apollo-lhc/Cornell_CM_Rev3_HW/MCU/CMv3_TM4C_controller_pin_specs.xlsx

 | GPIO pin that needs to be configured
 | Alternate function pin that needs to be configured
 | Analog input, connected through a low pass filter
 | Pin with a pre-defined function
 | Undefine function, direction, and buffer type
Pin Number | Pin Name | Pin Type | Buffer Type | Description | Signal Name | Usage | Schematics
1 | AIN15 | I | Analog | Analog-to-digital converter input 15 | CUR_V_4V0 | The current from the 4.0 volt regulator that supplies power to the 25Gx12 FireFly transmitters. Scale = 2 amps per volt. | 3.07, 3.08
2 | AIN14 | I | Analog | Analog-to-digital converter input 14 | CUR_V_M3V3 | The current from the 3.3 volt regulator that supplies power to the MCU and peripherals. Scale = 2 amps per volt. | 3.01, 3.08
3 | AIN13 | I | Analog | Analog-to-digital converter input 13 | CUR_V_12V | The current on the 12.0 volt line entering the board. Scale = 12.5 amps per volt (was 10 amps per volt). | 2.01, 3.08
4 | AIN12 | I | Analog | Analog-to-digital converter input 12 | V_F2_VCCAUX | The actual value of the VCCAUX voltage for FPGA#2. Nominally 1.8 volts. | 3.06, 3.08
5 | PQ0 | O | OD | GPIO port Q bit 0 | /I2C_RESET_PWR | Active-low open-drain signal to reset the TCA9548A I2C switch related to accessing the LGA80D regulators, plus the 24LCS52 serial "ID" EEPROM. | 4.01, 4.02
6 | PQ1 | O | OD | GPIO port Q bit 1 | /I2C_RESET_CLOCKS | Active-low open-drain signal to reset the TCA9548A I2C switch related to accessing the clock synthesizers and multiplexers. | 4.01, 4.03
7 | VDD | Power |  | Positive supply for I/O and some logic | V_M3V3 | 3.3 volts from the management regulator. It is present whenever the board has 12v supplied. | 2.04
8 | VDDA | Power |  | The positive supply for the analog circuits (ADC, Analog Comparators, etc.). | V_M3V3 | 3.3 volts from the management regulator. It is present whenever the board has 12v supplied. | 3.08
9 | VREFA+ | Power |  | A reference voltage used to specify the voltage at which the ADC converts to a maximum value. | MCU_VREFA | This 2.5 volt level sets the value that will correspond to the ADC full scale valu of 4095 (0xfff) | 3.08
10 | GNDA | Power |  | The ground reference for the analog circuits (ADC, Analog Comparators, etc.). | GND | Ground plane. | 3.08
11 | PQ2 | O | OD | GPIO port Q bit 2 | /I2C_RESET_F2_OPTICS | Active-low open-drain signal to reset the TCA9548A I2C switch related to accessing FireFly devices connected to FPGA#2. | 4.01, 4.06
12 | AIN0 | I | Analog | Analog-to-digital converter input 0 | V_12V | The scaled value of the +12 volt supply entering the board. Scale factor = 1/6 (12 V in reads as 2 V) Nominally 12.0 volts. | 2.01, 3.08
13 | AIN1 | I | Analog | Analog-to-digital converter input 1 | V_M3V3 | The scaled value of the always-on 3.3 volt maintenance supply. Scale factor = 1/2 (3.3 V reads as 1.65V). Nominally 3.3 volts. | 3.01, 3.08
14 | AIN2 | I | Analog | Analog-to-digital converter input 2 | V_3V3 | The scaled value of the global 3.3 volt switched supply. Scale factor = 1/2 (3.3 V reads as 1.65V). Nominally 3.3 volts. | 3.02, 3.08
15 | AIN3 | I | Analog | Analog-to-digital converter input 3 | V_4V0 | The scaled value of the global 4.0 volt switched supply that supplies power to the 25Gx12 FireFly transmitters. Scale factor = 1/2 (4.0 V reads as 2.0V). Nominally 4.0 volts. | 3.07, 3.08
16 | VDD | Power |  | Positive supply for I/O and some logic | V_M3V3 | 3.3 volts from the management regulator. It is present whenever the board has 12v supplied. | 2.04
17 | GND | Power |  | Ground reference for logic and I/O pins | GND | Ground plane. | 2.04
18 | AIN16 | I | Analog | Analog-to-digital converter input 16 | CUR_F1_VCCAUX | The current from the 1.8 volt regulator that supplies power to FPGA#1 GTY transceivers . Scale = 1 amp per volt. | 3.04, 3.08
19 | AIN17 | I | Analog | Analog-to-digital converter input 17 | CUR_F2_VCCAUX | The current from the 1.8 volt regulator that supplies power to FPGA#2 GTY transceivers . Scale = 1 amp per volt. | 3.06, 3.08
20 | AIN18 | I | Analog | Analog-to-digital converter input 18 | F1_TEMP_DIODE | The voltage from the LTC2997H signal conditioner connected to the temperature-sensing diode in FPGA#1. Scale = 4 * (1.004/1.026) millivolts per degree K. | 3.08, 5.05
21 | AIN19 | I | Analog | Analog-to-digital converter input 19 | F2_TEMP_DIODE | The voltage from the LTC2997H signal conditioner connected to the temperature-sensing diode in FPGA#2. Scale = 4 * (1.004/1.026) millivolts per degree K. | 3.08, 6.05
22 | PC7 | I | TTL | GPIO port C bit 7 | PG_4V0 | This PG (power good) input will be HIGH when the LDO06c power supply for the board-wide 4.0 volt supply has been enabled and is supplying a good voltage. | 3.07, 3.09
23 | PC6 | O | TTL | GPIO port C bit 6 | F2_CFG_START | Pulse this output HIGH to drive the "PROGRAM_B" input on FPGA#2 LOW. The leading edge of the pulse will reset the configuration logic on FPGA#1. The trailing edge will start the configuration process. This signal has a 4.7k pull-down resistor. | 2.12, 6.04
24 | PC5 | undef | undef | UART module 7 transmit, GPIO port C bit 5 | SM_ZYNQ_GPIO2 | Connection to a GPIO pin on the ZYNQ on the SM. The use is currently undefined, but it can be used for UART #7 Tx or GPIO PC5. This signal is tied to GND on the original SMv1. It initially has a 270 ohm resistor in series for current limiting. | 2.01
25 | PC4 | undef | undef | UART module 7 receive, GPIO port C bit 4 | SM_ZYNQ_GPIO1 | Connection to a GPIO pin on the ZYNQ on the SM. The use is currently undefined, but it can be used for UART #7 Rx or GPIO PC4. This signal is tied to GND on the original SMv1. It initially has a 270 ohm resistor in series for current limiting. | 2.01
26 | VDD | Power |  | Positive supply for I/O and some logic | V_M3V3 | 3.3 volts from the management regulator. It is present whenever the board has 12v supplied. | 2.04
27 | PQ3 | O | OD | GPIO port Q bit 3 | /I2C_RESET_F1_OPTICS | Active-low open-drain signal to reset the TCA9548A I2C switch related to accessing FireFly devices connected to FPGA#1. | 4.01, 4.05
28 | VDD | Power |  | Positive supply for I/O and some logic | V_M3V3 | 3.3 volts from the management regulator. It is present whenever the board has 12v supplied. | 2.04
29 | PH0 | O | OD | GPIO port H bit 0 | /I2C_RESET_FPGAS | Active-low open-drain signal to reset the TCA9548A I2C switch related to accessing the FPGAs. | 4.01, 4.04
30 | PH1 | I | TTL | GPIO port H bit 1 | SM_SOFT_PWR_EN | This signal is used by the ZYNQ to tell the MCU to enable or disable power supplies on the CM. The ZYNQ will set it LOW to make the MCU disable all controllable power supplies. The ZYNQ will transition it to HIGH to start the MCU's power control state machine. There is not any pull-up on the CM, so configure it as an input with 2 mA internal pull-up to allow operation when not connected to the SM. | 2.01
31 | PH2 | I | TTL | GPIO port H bit 2 | PG_3V3 | This PG (power good) input will be HIGH when the LGA80D power supply for the board-wide 3.3 volt supply has been enabled and is supplying a good voltage. | 3.02, 3.09
32 | PH3 | I | TTL | GPIO port H bit 3 | PG_1V8 | This PG (power good) input will be HIGH when the LGA80D power supply for the board-wide 1.8 volt supply has been enabled and is supplying a good voltage. | 3.02, 3.09
33 | U0Rx | I | TTL | I2C module 9 clock, UART Module 0 receive, GPIO port A bit 0 | SM_ZYNQ_TX | UART for serial data transmitted from the ZYNQ module on the SM and received by the MCU. Has pads for optional I2C pullup. | 2.01
34 | U0Tx | O | TTL | I2C module 9 data, UART Module 0 transmit, GPIO port A bit 1 | SM_ZYNQ_RX | UART for serial data transmitted from the MCU and received by the ZYNQ module on the SM. Has pads for optional I2C pullup. | 2.01
35 | PA2 | I/O | I2C | I2C module 8 clock, UART Module 4 receive, GPIO port A bit 2 | SM_ZYNQ_I2C_SCL | Connection to a GPIO pin on the ZYNQ on the SM. The use is currently undefined, but it can be used for I2C #8 SCL, UART #4 Rx, GPIO PA2, or Timer T1. | 2.01
36 | PA3 | I/O | I2C | I2C module 8 data, UART Module 4 transmit, GPIO port A bit 3 | SM_ZYNQ_I2C_SDA | Connection to a GPIO pin on the ZYNQ on the SM. The use is currently undefined, but it can be used for I2C #8 SDA, UART #4 Tx, GPIO PA3, or Timer T1. It is used as UART #4 Tx on CMv1 for moving monitoring data to the SM. | 2.01
37 | U3Rx | I | TTL | I2C module 7 clock, UART Module 3 receive, GPIO port A bit 4 | SM_IPMC_TX | UART for serial data transmitted from the IPMC module on the SM and received by the MCU. Has pads for optional I2C pullup. | 2.01
38 | U3Tx | O | TTL | I2C module 7 data, UART Module 3 transmit, GPIO port A bit 5 | SM_IPMC_RX | UART for serial data transmitted from the MCU and received by the IPMC module on the SM. Has pads for optional I2C pullup. | 2.01
39 | VDD | Power |  | Positive supply for I/O and some logic | V_M3V3 | 3.3 volts from the management regulator. It is present whenever the board has 12v supplied. | 2.04
40 | PA6 | undef | undef | I2C module 6 clock, UART Module 2 receive, GPIO port A bit 6, Timer T3 | SM_CPLD_GPIO0 | Connection to a GPIO pin on the CPLD on the SM (SMv2 or later). The use is currently undefined, but it can be used for I2C #6 SCL, UART #2 Rx, GPIO PA6, or Timer T3. This signal is tied to GND on the original SMv1. It initially has a 270 ohm resistor in series for current limiting. | 2.01
41 | PA7 | undef | undef | I2C module 6 data, UART Module 2 transmit, GPIO port A bit 7, Timer T3 | SM_CPLD_GPIO1 | Connection to a GPIO pin on the CPLD on the SM (SMv2 or later). The use is currently undefined, but it can be used for I2C #6 SDA, UART #2 Tx, GPIO PA7, or timer T3. This signal is tied to GND on the original SMv1. It initially has a 270 ohm resistor in series for current limiting. | 2.01
42 | PF0 | I | TTL | GPIO port F bit 0 | PG_F1_INT_A | This PG (power good) input will be HIGH when both phases of the "A" LGA80D power supply for FPGA#1's 0.85 volt V_F1_INT internal voltage have been enabled and are supplying a good voltage. The PG signals from each phase are combined in an AND gate ahead of this input. | 3.03, 3.09
43 | PF1 | I | TTL | GPIO port F bit 1 | PG_F1_INT_B | This PG (power good) input will be HIGH when both phases of the "B" LGA80D power supply for FPGA#1's 0.85 volt V_F1_INT internal voltage have been enabled and are supplying a good voltage. The PG signals from each phase are combined in an AND gate ahead of this input. | 3.03, 3.09
44 | PF2 | I | TTL | GPIO port F bit 2 | PG_F1_AVCC | This PG (power good) input will be HIGH when the LGA80D power supply for FPGA#1's 0.9 volt V_F1_AVCC supply has been enabled and is supplying a good voltage. | 3.04, 3.09
45 | PF3 | I | TTL | GPIO port F bit 3 | PG_F1_AVTT | This PG (power good) input will be HIGH when the LGA80D power supply for FPGA#1's 1.2 volt V_F1_AVTT supply has been enabled and is supplying a good voltage. | 3.04, 3.09
46 | PF4 | I | TTL | GPIO port F bit 4 | PG_F1_VCCAUX | This PG (power good) input will be HIGH when the LT1764 power supply for FPGA#1's 1.8 volt V_F1_VCCAUX supply has been enabled and is supplying a good voltage. | 3.04, 3.09
47 | VDD | Power |  | Positive supply for I/O and some logic | V_M3V3 | 3.3 volts from the management regulator. It is present whenever the board has 12v supplied. | 2.04
48 | GND | Power |  | Ground reference for logic and I/O pins | GND | Ground plane. | 2.04
49 | I2C1SCL | I/O | I2C | I2C module 1 clock. | I2C_SCL_POWER | Open-drain signal connected to the I2C clock related to accessing the LGA80D regulators, plus the 24LCS52 serial "ID" EEPROM. | 4.01, 4.02
50 | I2C1SDA | I/O | I2C | I2C module 1 data | I2C_SDA_POWER | Open-drain signal connected to the I2C data line related to accessing the LGA80D regulators, plus the 24LCS52 serial "ID" EEPROM. | 4.01, 4.02
51 | I2C2SCL | I/O | I2C | I2C module 2 clock. | I2C_SCL_CLOCKS | Open-drain signal connected to the I2C clock related to accessing the clock synthesizers and multiplexers. | 4.01, 4.03
52 | I2C2SDA | I/O | I2C | I2C module 2 data | I2C_SDA_CLOCKS | Open-drain signal connected to the I2C data line related to accessing the clock synthesizers and multiplexers. | 4.01, 4.03
53 | I2C3SCL | I/O | I2C | I2C module 3 clock. | I2C_SCL_F2_OPTICS | Open-drain signal connected to the I2C clock related to accessing FireFly devices connected to FPGA#2. | 4.01, 4.06
54 | I2C3SDA | I/O | I2C | I2C module 3 data | I2C_SDA_F2_OPTICS | Open-drain signal connected to the I2C data line related to accessing FireFly devices connected to FPGA#2. | 4.01, 4.06
55 | I2C4SCL | I/O | I2C | I2C module 4 clock. | I2C_SCL_F1_OPTICS | Open-drain signal connected to the I2C clock related to accessing FireFly devices connected to FPGA#1. | 4.01, 4.05
56 | I2C4SDA | I/O | I2C | I2C module 4 data | I2C_SDA_F1_OPTICS | Open-drain signal connected to the I2C data line related to accessing FireFly devices connected to FPGA#1. | 4.01, 4.05
57 | PQ5 | I | TTL | GPIO port Q bit 5 | PG_F2_INT_A | This PG (power good) input will be HIGH when both phases of the "A" LGA80D power supply for FPGA#2's 0.85 volt V_F2_INT internal voltage have been enabled and are supplying a good voltage. The PG signals from each phase are combined in an AND gate ahead of this input. | 3.05, 3.09
58 | PQ6 | I | TTL | GPIO port Q bit 6 | PG_F2_INT_B | This PG (power good) input will be HIGH when both phases of the "B" LGA80D power supply for FPGA#2's 0.85 volt V_F2_INT internal voltage have been enabled and are supplying a good voltage. The PG signals from each phase are combined in an AND gate ahead of this input. | 3.05, 3.09
59 | PK7 | I | TTL | GPIO port K bit 7 | PG_F2_AVCC | This PG (power good) input will be HIGH when the LGA80D power supply for FPGA#2's 0.9 volt V_F2_AVCC supply has been enabled and is supplying a good voltage. | 3.06, 3.09
60 | PK6 | I | TTL | GPIO port K bit 6 | PG_F2_AVTT | This PG (power good) input will be HIGH when the LGA80D power supply for FPGA#2's 1.2 volt V_F2_AVTT supply has been enabled and is supplying a good voltage. | 3.06, 3.09
61 | PK5 | I | TTL | GPIO port K bit 5 | PG_F2_VCCAUX | This PG (power good) input will be HIGH when the LT1764 power supply for FPGA#2's 1.8 volt V_F2_VCCAUX supply has been enabled and is supplying a good voltage. | 3.06, 3.09
62 | PK4 | I | TTL | GPIO port K bit 4 | /F1_CFG_DONE | Active-lo digital input from FPGA#1. If the FPGA is installed, this signal will be LOW when the FPGA configuration is complete. Unfortunately, if the FPGA is not installed, it will also be LOW all the time. Therefore, it must be qualified with /F1_INSTALLED. | 2.12, 5.04
63 | VDD | Power |  | Positive supply for I/O and some logic | V_M3V3 | 3.3 volts from the management regulator. It is present whenever the board has 12v supplied. | 2.04
64 | /WAKE | I | TTL | An external input that brings the processor out of Hibernate mode when asserted. | GND | Tied to GND. This function is not used. | 2.04
65 | /HIB | O | TTL | An output that indicates the processor is in Hibernate mode | No connect | No connection since this function is not used. | 2.04
66 | XOSC0 | I | Analog | External RTC clock reference input. | XOSC0 | Connected to a 32.768 kHz crystal that can drive the internal RTC. | 2.04
67 | XOSC1 | O | Analog | External RTC clock reference output. | XOSC1 | Connected to a 32.768 kHz crystal that can drive the internal RTC. | 2.04
68 | VBAT | Power |  | Power source for the Hibernation module. | V_M3V3 | 3.3 volts from the management regulator. It is present whenever the board has 12v supplied. SInce a battery is not used, this pin connects directly to the VDD source. | 2.04
69 | VDD | Power |  | Positive supply for I/O and some logic | V_M3V3 | 3.3 volts from the management regulator. It is present whenever the board has 12v supplied. | 2.04
70 | /RESET | I | TTL | System reset input | MCU_ENABLED | MCU_ENABLED will be HIGH when: a) SM_TO_CM_PWR_EN is HIGH (either from the board being operated "stand alone" or the signal driven HIGH by the service module) b) AND the management supply is good (V_M3V3). | 2.04
71 | PM7 | I | TTL | GPIO port M bit 7 | /F2_CFG_DONE | Active-low digital input from FPGA#2. If the FPGA is installed, this signal will be LOW when the FPGA configuration is complete. Unfortunately, if the FPGA is not installed, it will also be LOW. Therefore, it must be qualified with /F1_INSTALLED. | 2.12, 6.04
72 | PM6 | I | TTL | GPIO port M bit 6 | hivF1_TO_MCU lovF1_TO_MCU | Unassigned digital input from FPGA#1. This passes through a level converter. The signal name prefaced with "lov" is on the low voltage 1.8 volt FPGA side of the converter. The signal name prefaced with "hiv" is on the high-voltage 3.3v side of the converter. | 2.12, 5.08
73 | PM5 | I | TTL | GPIO port M bit 5 | hivF2_TO_MCU lovF2_TO_MCU | Unassigned digital input from FPGA#2. This passes through a level converter. The signal name prefaced with "lov" is on the low voltage 1.8 volt FPGA side of the converter. The signal name prefaced with "hiv" is on the high-voltage 3.3v side of the converter. | 2.12, 6.08
74 | PM4 | O | TTL | GPIO port M bit 4 | hivMCU_TO_F1 lovMCU_TO_F1 | Unassigned digital ouput to FPGA#1. This passes through a level converter. The signal name prefaced with "lov" is on the low voltage 1.8 volt FPGA side of the converter. The signal name prefaced with "hiv" is on the high-voltage 3.3v side of the converter. | 2.12, 5.08
75 | PM3 | O | TTL | GPIO port M bit 3 | hivMCU_TO_F2 lovMCU_TO_F2 | Unassigned digital ouput to FPGA#2. This passes through a level converter. The signal name prefaced with "lov" is on the low voltage 1.8 volt FPGA side of the converter. The signal name prefaced with "hiv" is on the high-voltage 3.3v side of the converter. | 2.12, 6.08
76 | PM2 | O | TTL | GPIO port M bit 2 | CM_TO_SM_PWR_OK | This output is set HIGH when the MCU's power control state machine has successfully completed enabling the configured set of controllable power supplies on the CM. It will be set LOW when the desired power supplies are not all operational. | 2.01
77 | PM1 | O | TTL | GPIO port M bit 1 | EN_3V3 | Set this output HIGH to turn on the LGA80D power supply for the board-wide V_3V3 3.3 volt rail. This also enables the V_4V0 4.0 volt rail used by the FireFLy 12-lane transmitters that run at 25G. | 3.02, 3.07, 3.09
78 | PM0 | O | TTL | GPIO port M bit 0 | EN_1V8 | Set this output HIGH to turn on the LGA80D power supply for the board-wide 1.8 volts V_1V8 | 3.02, 3.09
79 | VDD | Power |  | Positive supply for I/O and some logic | V_M3V3 | 3.3 volts from the management regulator. It is present whenever the board has 12v supplied. | 2.04
80 | GND | Power |  | Ground reference for logic and I/O pins | GND | Ground plane. | 2.04
81 | PL0 | O | TTL | GPIO port L bit 0 | EN_F1_INT | Set this output HIGH to turn on both phases of both "A" and "B" LGA80D power supplies for FPGA#1's 0.9 volt V_F1_INT internal voltage. | 3.03, 3.09
82 | PL1 | O | TTL | GPIO port L bit 1 | EN_F1_AVCC | Set this output HIGH to turn on the LGA80D power supply for FPGA#1's 0.9 volt V_F1_AVCC voltage. | 3.04, 3.09
83 | PL2 | O | TTL | GPIO port L bit 2 | EN_F1_AVTT | Set this output HIGH to turn on the LGA80D power supply for FPGA#1's 1.2 volt V_F1_AVTT voltage. | 3.04, 3.09
84 | PL3 | O | TTL | GPIO port L bit 3 | EN_F1_VCCAUX | Set this output HIGH to turn on the LT1764 power supply for FPGA#1's 1.8 volt V_F1_VCCAUX voltage. | 3.04, 3.09
85 | PL4 | O | TTL | GPIO port L bit 4 | EN_F2_INT | Set this output HIGH to turn on both phases of both "A" and "B" LGA80D power supplies for FPGA#2's 0.9 volt V_F2_INT internal voltage. | 3.05, 3.09
86 | PL5 | O | TTL | GPIO port L bit 5 | EN_F2_AVCC | Set this output HIGH to turn on the LGA80D power supply for FPGA#2's 0.9 volt V_F2_AVCC voltage. | 3.06, 3.09
87 | VDDC | Power |  | Positive supply for most of the logic function, including the processor core and most peripherals. The voltage on this pin is 1.2 V and is supplied by the on-chip LDO. | TM4C_VDDC | Tied to TM4C pins 87 and 115 and a 3.3 uF capacitor. The VDDC pins should only be connected to each other and an external capacitor as specified in Table 26-15 on page 1577 . | 2.04
88 | OSC0 | I | Analog | Main oscillator crystal input. | OSC0 | Connected to a 16 MHz crystal that can be used for more accuracy than the internal oscillator. | 2.04
89 | OSC1 | O | Analog | Main oscillator crystal output. | OSC1 | Connected to a 16 MHz crystal that can be used for more accuracy than the internal oscillator. | 2.04
90 | VDD | Power |  | Positive supply for I/O and some logic | V_M3V3 | 3.3 volts from the management regulator. It is present whenever the board has 12v supplied. | 2.04
91 | I2C0SCL | I/O | I2C | I2C module 0 clock. | SM_IPMC_I2C_SCL | Open-drain signal connected to the I2C clock from the SM. This is an I2C slave interface | 2.01
92 | I2C0SDA | I/O | I2C | I2C module 0 data | SM_IPMC_I2C_SDA | Open-drain signal connected to the I2C data line from the SM. This is an I2C slave interface | 2.01
93 | PL7 | O | TTL | GPIO port L bit 7 | EN_F2_AVTT | Set this output HIGH to turn on the LGA80D power supply for FPGA#2's 1.2 volt V_F2_AVTT voltage. | 3.06, 3.09
94 | PL6 | O | TTL | GPIO port L bit 6 | EN_F2_VCCAUX | Set this output HIGH to turn on the LT1764 power supply for FPGA#2's 1.8 volt V_F2_VCCAUX voltage. | 3.06, 3.09
95 | I2C5SCL | I/O | I2C | I2C module 5 clock. | I2C_SCL_FPGAS | Open-drain signal connected to the I2C clock related to accessing the FPGAs. | 4.01, 4.04
96 | I2C5SDA | I/O | I2C | I2C module 5 data | I2C_SDA_FPGAS | Open-drain signal connected to the I2C data line related to accessing the FPGAs. | 4.01, 4.04
97 | TDO | O | TTL | JTAG TDO | FP_MCU_TDO | Front-panel JTAG connector signal. Can be used for JTAG TDO or ARM "SWD" SWO | 2.03
98 | TDI | I | TTL | JTAG TDI | FP_MCU_TDI | Front-panel JTAG connector signal. Used for JTAG TDI | 2.03
99 | TMS | I | TTL | JTAG TMS | FP_MCU_TMS | Front-panel JTAG connector signal. Can be used for JTAG TMS or ARM "SWD" SWDIO | 2.03
100 | TCK | I | TTL | JTAG TCK | FP_MCU_TCK | Front-panel JTAG connector signal. Can be used for JTAG TCK or ARM "SWD" SWCLK | 2.03
101 | VDD | Power |  | Positive supply for I/O and some logic | V_M3V3 | 3.3 volts from the management regulator. It is present whenever the board has 12v supplied. | 2.04
102 | PQ4 | O | TTL | GPIO port Q bit 4 | FPGA_CFG_FROM_FLASH | Set this output HIGH to enable the FPGAs to boot from the on-board FLASH memory (Master SPI mode). Set this output LOW to limit booting to JTAG (JTAG only mode). The FPGA configuration input bit "M2" takes on the inverted value of this signal. This signal has a 4.7k pull-down resistor. | 2.12, 5.04, 6.04
103 | PP2 | O | TTL | GPIO port P bit 2 | F1_CFG_START | Pulse this output HIGH to drive the "PROGRAM_B" input on FPGA#1 LOW. The leading edge of the pulse will reset the configuration logic on FPGA#1. The trailing edge will start the configuration process. This signal has a 4.7k pull-down resistor. | 2.12, 5.04
104 | PP3 | O | TTL | GPIO port P bit 3 | MCU_LED_RED | Set this output HIGH to light the RED element of the MCU RGB LED. | 2.12
105 | PP4 | O | TTL | GPIO port P bit 4 | MCU_LED_GREEN | Set this output HIGH to light the GREEN element of the MCU RGB LED. | 2.12
106 | PP5 | O | TTL | GPIO port P bit 5 | MCU_LED_BLUE | Set this output HIGH to light the BLUE element of the MCU RGB LED. | 2.12
107 | PN0 | O | TTL | GPIO port N bit 0 | ID_EEPROM_WP | This output controls the write-protect pin on the ID EEPROM. Set this output LOW to enable writing to the EEPROM. Set this output HIGH to disable writing. | 4.01
108 | PN1 | O | TTL | GPIO port N bit 1 | JTAG_FROM_SM | Set this output HIGH to enable the FPGA JTAG chain to be controlled by the SM. Set this output LOW to enable the FPGA JTAG chian to be controlled from the front panel connector. | 2.03
109 | PN2 | undef | TTL | GPIO port N bit 2 | SPARE_GPIO3 | Connection to a test point on the CM circuit board. The use is currently undefined. It is recommended to configure it as an output driven LOW until a specific need is determined. | 2.03
110 | PN3 | undef | TTL | GPIO port N bit 3 | SPARE_GPIO2 | Connection to a test point on the CM circuit board. The use is currently undefined. It is recommended to configure it as an output driven LOW until a specific need is determined. | 2.03
111 | PN4 | undef | undef | GPIO port N bit 4 | SPARE_GPIO0 | Connection to a test point on the CM circuit board. The use is currently undefined. It is recommended to configure it as an output driven LOW until a specific need is determined. | 2.12
112 | PN5 | undef | undef | GPIO port N bit 5 | SPARE_GPIO1 | Connection to a test point on the CM circuit board. The use is currently undefined. It is recommended to configure it as an output driven LOW until a specific need is determined. | 2.12
113 | VDD | Power |  | Positive supply for I/O and some logic | V_M3V3 | 3.3 volts from the management regulator. It is present whenever the board has 12v supplied. | 2.04
114 | GND | Power |  | Ground reference for logic and I/O pins | GND | Ground plane. | 2.04
115 | VDDC | Power |  | Positive supply for most of the logic function, including the processor core and most peripherals. The voltage on this pin is 1.2 V and is supplied by the on-chip LDO. | TM4C_VDDC | Tied to TM4C pins 87 and 115 and a 3.3 uF capacitor. The VDDC pins should only be connected to each other and an external capacitor as specified in Table 26-15 on page 1577 . | 2.04
116 | PJ0 | I | TTL | GPIO port J bit 0 | hivF1_C2C_OK lovF1_C2C_OK | Active-hi digital input from FPGA#1. The FPGA should Set this signal when it has a good C2C (AXI chip-to-chip) link with the Zynq on the SM. This passes through a level converter. The signal name prefaced with "lov" is on the low voltage 1.8 volt FPGA side of the converter. The signal name prefaced with "hiv" is on the high-voltage 3.3v side of the converter. | 2.12, 5.08
117 | PJ1 | I | TTL | GPIO port J bit 1 | hivF2_C2C_OK lovF2_C2C_OK | Active-hi digital input from FPGA#2. The FPGA should Set this signal when it has a good C2C (AXI chip-to-chip) link with the Zynq on the SM. This passes through a level converter. The signal name prefaced with "lov" is on the low voltage 1.8 volt FPGA side of the converter. The signal name prefaced with "hiv" is on the high-voltage 3.3v side of the converter. | 2.12, 6.08
118 | PP0 | I | TTL | GPIO port P bit 0 | /F1_INSTALLED | Active-lo digital input that indicates that FPGA#1 is installed on the board. It connects to a pullup resistor and one of the GND balls on the FPGA. If the FPGA is installed, the signal is pulled low through the internal GND of the FPGA. | 2.12, 5.01
119 | PP1 | I | TTL | GPIO port P bit 1 | /F2_INSTALLED | Active-lo digital input that indicates that FPGA#2 is installed on the board. It connects to a pullup resistor and one of the GND balls on the FPGA. If the FPGA is installed, the signal is pulled low through the internal GND of the FPGA. | 2.12, 6.01
120 | AIN11 | I | Analog | Analog-to-digital converter input 11 | V_F2_AVTT | The actual value of the AVTT voltage for FPGA#2. Nominally 1.2 volts. | 3.06, 3.08
121 | AIN10 | I | Analog | Analog-to-digital converter input 10 | V_F2_AVCC | The actual value of the AVCC voltage for FPGA#2. Nominally 0.9 volts. | 3.06, 3.08
122 | VDD | Power |  | Positive supply for I/O and some logic | V_M3V3 | 3.3 volts from the management regulator. It is present whenever the board has 12v supplied. | 2.04
123 | AIN9 | I | Analog | Analog-to-digital converter input 9 | V_F2_INT | The actual value of the internal core voltage for FPGA#2. Nominally 0.85 volts. | 3.05, 3.08
124 | AIN8 | I | Analog | Analog-to-digital converter input 8 | V_F1_VCCAUX | The actual value of the VCCAUX voltage for FPGA#1. Nominally 1.8 volts. | 3.04, 3.08
125 | AIN7 | I | Analog | Analog-to-digital converter input 7 | V_F1_AVTT | The actual value of the AVTT voltage for FPGA#1. Nominally 1.2 volts. | 3.04, 3.08
126 | AIN6 | I | Analog | Analog-to-digital converter input 6 | V_F1_AVCC | The actual value of the AVCC voltage for FPGA#1. Nominally 0.9 volts. | 3.04, 3.08
127 | AIN5 | I | Analog | Analog-to-digital converter input 5 | V_F1_INT | The actual value of the internal core voltage for FPGA#1. Nominally 0.85 volts. | 3.03, 3.08
128 | AIN4 | I | Analog | Analog-to-digital converter input 4 | V_1V8 | The actual value of the global 1.8 volt switched supply. Nominally 1.8 volts. | 3.02, 3.08
