apollo-lhc/Cornell_CM_Rev3_HW/ClockBuilderPRO/test_projects/TestConfigurationIndex.xlsx

Sheet: Configurations
Configuration Name Breakdown (dddbbpvv)
 | ddd = device, one of R0A, R0B, R1A, R1B, or R1C
 | bb = CM board version, one of "v3" (CMv3) or "v0" (CMv1 or CMv2)
 | p = project type, one of "C" (common), "T" (TF), "D" (IT-DTC), "X" (diagnostic special), or "0" (old non-specific CMv1 or CMv2)
 | vv = version, increment for new versions of specific "dddbbp" types
Green cells indicate the input sources
R0Av3X01 | Common | 48 | no connect | unused | no connect | unused | no connect | 320 | 160 | 300 | 150 | 280 | 140 | 260 | 130 | 240 | no connect | unused
R0Av3X02 | Common |  | no connect | 230 | no connect | 230 | no connect | 230 | 230 | 230 | 230 | 230 | 230 | 230 | 230 | 230 | no connect | 230
R0Av3X03 | Common | 48 | no connect | unused | no connect | unused | no connect | 320.63 | 320.63 | 320.63 | 320.63 | 320.63 | 320.63 | 320.63 | 320.63 | 320.63 | no connect | unused
R0Bv3X01 | Common | 48 | unused | unused | unused | unused | no connect | 310 | 155 | 290 | 145 | 270 | 135 | 250 | 125 | 230 | no connect | unused
R0Bv3X02 | Common |  | 240 | unused | unused | 240 | no connect | 240 | 240 | 240 | 240 | 240 | 240 | 240 | 240 | 240 | no connect | 240
R0Bv3X03 | Common |  | unused | 320 | unused | 320 | no connect | 320 | 320 | 320 | 320 | 320 | 320 | 320 | 320 | 320 | no connect | 320
R0Bv3X04 | Common |  | unused | unused | 40 | 40 | no connect | 200 | 200 | 200 | 200 | 200 | 200 | 200 | 200 | 200 | no connect | 40
R0Bv3X05 | Common |  | 240 | 320 | 40 | unused | no connect | 280 | 280 | 280 | 280 | 280 | 280 | 280 | 280 | 280 | no connect | unused
R1Av3X01 | Common | 48 | unused | unused | unused | unused | 60 | 40 | 100 | 120 | 312 | 168 | 336 | 156 | 272 | 136 | no connect | unused
R1Av3X02 | Common |  | 320 | unused | unused | 320 | 320 | 320 | 320 | 320 | 320 | 320 | 320 | 320 | 320 | 320 | no connect | 320
R1Av3X03 | Common |  | unused | 40 | unused | 40 | 160 | 160 | 160 | 160 | 160 | 160 | 160 | 160 | 160 | 160 | no connect | 40
R1Av3X04 | Common |  | unused | unused | 40 | 40 | 120 | 120 | 120 | 120 | 120 | 120 | 120 | 120 | 120 | 120 | no connect | 40
R1Bv3X01 | Common | 48 | unused | unused | unused | unused | 176 | 220 | 110 | 132 | 296 | 163 | 326 | 148 | 268 | 132 | 55 | unused
R1Bv3X02 | Common |  | 100 | unused | unused | 100 | 200 | 200 | 200 | 200 | 200 | 200 | 200 | 200 | 200 | 200 | 200 | 100
R1Bv3X03 | Common |  | unused | 40 | unused | 40 | 280 | 280 | 280 | 280 | 280 | 280 | 280 | 280 | 280 | 280 | 280 | 40
R1Bv3X04 | Common |  | unused | unused | 40 | 40 | 140 | 140 | 140 | 140 | 140 | 140 | 140 | 140 | 140 | 140 | 140 | 40
R1Cv3X01 | Common | 48 | unused | no connect | unused | no connect | 116 | 232 | 174 | 348 | 310 | 170 | 340 | 155 | 286 | 143 | 226 | 113
R1Cv3X02 | Common |  | 120 | unused | unused | no connect | 240 | 240 | 240 | 240 | 240 | 240 | 240 | 240 | 240 | 240 | 240 | 240
R1Cv3X03 | Common |  | unused | unused | 40 | no connect | 180 | 180 | 180 | 180 | 180 | 180 | 180 | 180 | 180 | 180 | 180 | 180

Sheet: ClockDistribution
Files | R0Av3X01 | R0Bv3X01 |  |  | R1Av3X01 | R1Bv3X01 |  | R1Cv3X01
 |  |  |  |  |  |  |  |  |  |  |  |  |  | FPGA #1 |  |  | FPGA #2
Quad # | Quad Letter | Ref # | Vivado Constraints Name | FPGA #1 A/B Switch | FPGA #1 Source | FPGA #1 Freq | FPGA #2 A/B Switch | FPGA #2 Source | FPGA #2 Freq | Logic Clock Name (schematic) | Logic Clock Name (constraint file) | Logic Clock Pins | A/B Switch | Source | Freq | A/B Switch | Source | Freq | A/B Switch | Signal | IC | Bit #
 |  |  |  |  |  |  |  |  |  |  |  |  |  |  |  |  |  |  | 1 | F1L_X12_R0_SEL | U88 | P00
120 | AB | R0 | lf_r0_ab |  | R1A-0A | 60 |  | R1A-0 | 40 | FnL_X12_R0_CLK | lf_x12_r0_clk | P33/P34 | 1 | R0A/B-2 | 300/290 | 5 | R0A/B-6 | 260/250 | 2 | F1L_X4_R0_SEL | U88 | P01
120 | AB | R1 | lf_r1_ab |  | R1B-0 | 220 |  | R1B-1 | 110 | FnL_X4_R0_CLK | lf_x4_r0_clk | N32/M32 | 2 | R0A/B-3 | 150/145 | 6 | R0A/B-7 | 130/125 | 3 | F1R_X12_R0_SEL | U88 | P02
122 | AD | R0 | lf_r0_ad | 1 | R0A/B-2 | 300/290 | 5 | R0A/B-6 | 260/250 | FnR_X12_R0_CLK | rt_x12_r0_clk | R18/R17 | 3 | R0A/B-1 | 160/155 | 7 | R0A/B-0 | 320/310 | 4 | F1R_X4_R0_SEL | U88 | P03
122 | AD | R1 | lf_r1_ad |  | R1B-2 | 132 |  | R1B-6 | 148 | FnR_X4_R0_CLK | rt_x4_r0_clk | N19/N18 | 4 | R0A/B-4 | 280/270 | 8 | R0A/B-5 | 140/135 | 5 | F2L_X12_R0_SEL | U83 | P00
124 | AF | R0 | lf_r0_af | 2 | R0A/B-3 | 150/145 | 6 | R0A/B-7 | 130/125 | Fn_TCDS40_CLK | tcds40_clk | BF27/BF28 |  | R1B-9 | 55 |  | R1B-9 | 55 | 6 | F2L_X4_R0_SEL | U83 | P01
124 | AF | R1 | lf_r1_af |  | R1A-4 | 168 |  | R1A-6 | 156 | LHC_CLK | lhc_clk | BE26/BE27 |  | SM | 40 |  | SM | 40 | 7 | F2R_X12_R0_SEL | U83 | P02
126 | R | R0 | lf_r0_r | 1 | R0A/B-2 | 300/290 | 5 | R0A/B-6 | 260/250 | FnFmSPARE2 | in_spare[2] | C29/C30 |  | FPGA#2 | 200 |  | FPGA#1 | 200 | 8 | F2R_X4_R0_SEL | U83 | P03
126 | R | R1 | lf_r1_r |  | R1B-3 | 296 |  | F1B-7 | 268
129 | U | R0 | lf_r0_u | 1 | R0A/B-2 | 300/290 | 5 | R0A/B-6 | 260/250
129 | U | R1 | lf_r1_u |  | R1B-0A | 176 |  | R1B-5 | 326
131 | W | R0 | lf_r0_w | 2 | R0A/B-3 | 150/145 | 6 | R0A/B-7 | 130/125
131 | W | R1 | lf_r1_w |  | R1A-3 | 312 |  | R1A-5 | 336 |  | out_spare[2] | BG26/BG27
133 | Y | R0 | lf_r0_y | 1 | R0A/B-2 | 300/290 | 5 | R0A/B-6 | 260/250
133 | Y | R1 | lf_r1_y |  | R1B-4 | 163 |  | R1B-8 | 134 | F1_XTAL_200 | clk_200 | AT17/AU16
220 | L | R0 | rt_r0_l |  | OSC | 200 |  | OSC | 200
220 | L | R1 | rt_r1_l |  | R1A-7 | 272 |  | R1A-8 | 136
222 | N | R0 | rt_r0_n | 3 | R0A/B-1 | 160/155 | 7 | R0A/B-0 | 320/310
222 | N | R1 | rt_r1_n |  | R1C-4 | 170 |  | R1C-5 | 340
224 | P | R0 | rt_r0_p | 4 | R0A/B-4 | 280/270 | 8 | R0A/B-5 | 140/135
224 | P | R1 | rt_r1_p |  | R1C-0A | 116 |  | R1C-9 | 226
226 | B | R0 | rt_r0_b | 3 | R0A/B-1 | 160/155 | 7 | R0A/B-0 | 320/310
226 | B | R1 | rt_r1_b |  | R1C-6 | 155 |  | R1C-3 | 310
229 | E | R0 | rt_r0_e | 3 | R0A/B-1 | 160/155 | 7 | R0A/B-0 | 320/310
229 | E | R1 | rt_r1_e |  | R1C-7 | 286 |  | R1C-2 | 348
231 | G | R0 | rt_r0_g | 4 | R0A/B-4 | 280/270 | 8 | R0A/B-5 | 140/135
231 | G | R1 | rt_r1_g |  | R1C-8 | 143 |  | R1C-0 | 232
233 | I | R0 | rt_r0_i | 3 | R0A/B-1 | 160/155 | 7 | R0A/B-0 | 320/310
233 | I | R1 | rt_r1_i |  | R1C-9A | 113 |  | R1C-1 | 174
