apollo-lhc/Cornell_CM_Rev3_HW/BoardTesting/FireFly_installation_for_TF.docx

# FireFly Installation for TF on CMv3 (6089-127 Rev A)

### Summary

1) Set FireFly transmitter voltage slide switches
2) Reinstall standoffs
3) Prepare and attach front panel
4) Install FireFly modules
5) Install FireFly heatsink thermal foam and heatsink
6) Route FireFly cables to front panel coupler block
7) Label front panel coupler block

### Set FireFly transmitter voltage slide switches

1) There are 8 slide switches on the bottom side of the board. Set all of them to the “3.3V” position (NOT the 3.8V position).
2) Set only switch SW7 to the “3.8V” position. This set the transmitter voltage for the FireFly in site “U41”. (FPGA #2 quads 128/129/130)

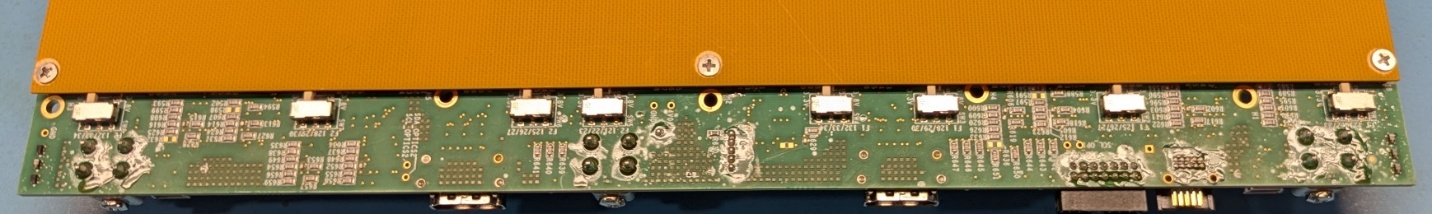
[picture p1: figure]

Selector switches in the “3.3V” (OFF) position.

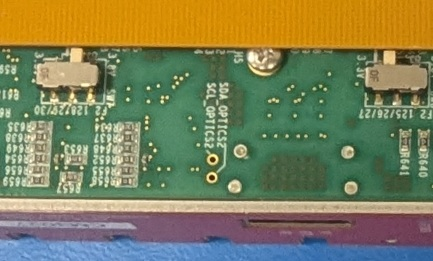
[picture p2: figure]

Selector switch SW7 in the “3.8V” (ON) position.

Selector switch SW7 location.

### Reinstall standoffs

Several standoffs may have been removed to facilitate testing the board with copper FireFly cables. If so, they need to be replaced.

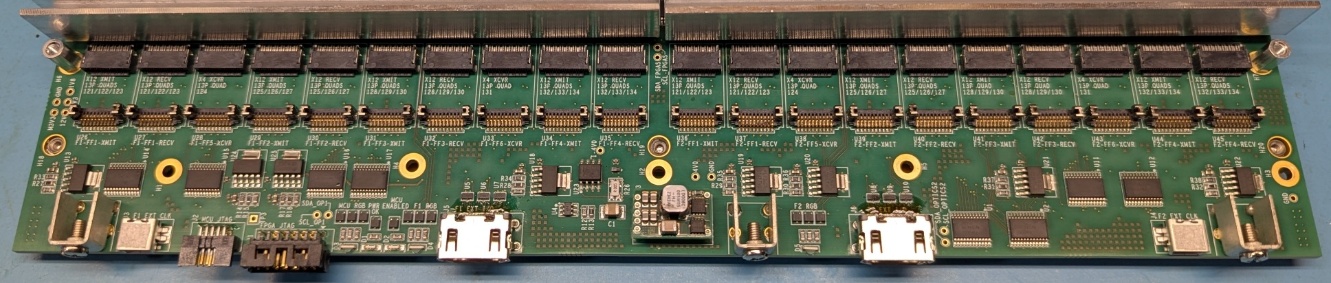
[picture p3: figure]

Missing FireFly heatsink standoffs

(2 places)

Missing top cover standoffs

(3 places)

1) Remove the bottom cover.
2) Install 3 21-mm long top cover standoffs
  a. From the bottom side of the board, insert a Phillips-head M2.5 x 8 screw and an M2.5 lock-washer through one of the mounting holes H1, H2, or H3.
  b. From the top side of the board add an M2.5 x 21 mm standoff.
  c. Tighten the screw and standoff.
3) Install 2 8-mm long FireFly heatsink standoffs
  a. From the bottom side of the board, insert a Phillips-head M2.5 x 6 screw and an M2.5 lock-washer through one of the mounting holes H4 or H5. (NOTE: The M2.5 x 8 screws are too long for these standoffs)
  b. From the top side of the board add an M2.5 x 8 mm standoff.
  c. Tighten the screw and standoff.
4) Reinstall the bottom cover.

### Prepare and attach front panel

1) Remove and discard the factory screws, if any, from the front panel mounting blocks.

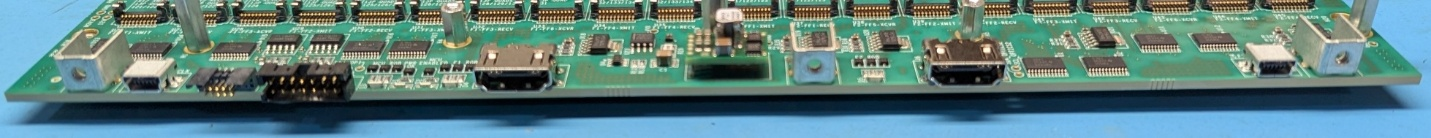
[picture p4: figure]

Remove screws

2) On a front panel that has already had the overlay applied, attach two 30-mm standoffs for the fiber optic connectors on the upper half. Insert Phillips-head M2.5x6 screws plus M2.5 lockwashers from the back side, and thread on the spacers from the front side and tighten.
3) Attach a fiber optic coupler block to the standoffs using Phillips-head M2.5 x 12-mm screws. Be sure the “key” faces in the direction shown in the photo.
4) Print and attach a label that shows the CM serial number. The format is “CMxxxx” where “xxxx” is the 4-digit serial number that matched the one on the board.
5) Attach the front panel to the board with three Phillips-head M3x6 screws.

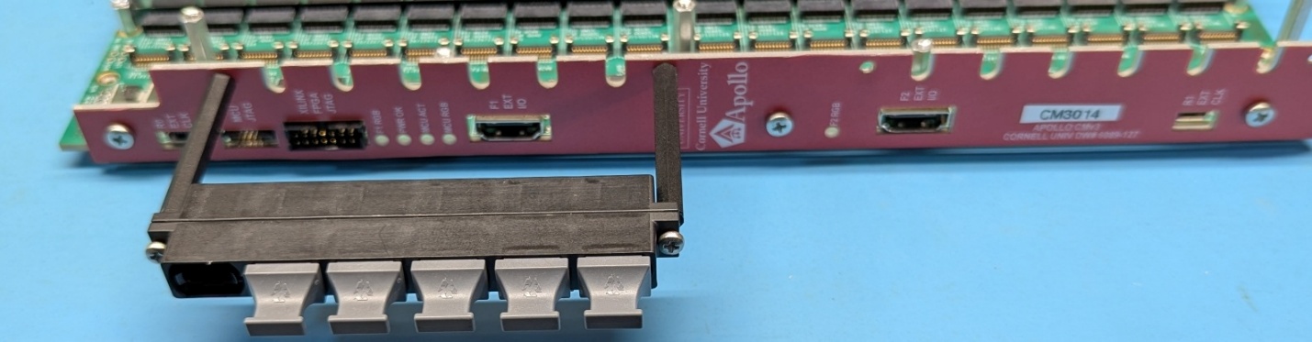
[picture p5: figure]

Coupler block

30-mm standoffs

Serial number label

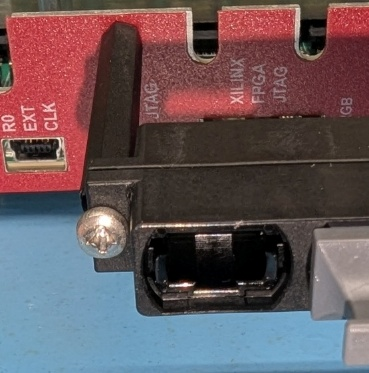
[picture p6: figure]

“Key” direction

### Install FireFly modules

1) Plug in all the required FireFly modules. For a TF board, the FireFly types and sites are:
  a. F1-FF1-RECV (U27) Quads 121/122/123: 25Gx12 Receiver
  b. F1-FF2-RECV (U30) Quads 125/126/127: 25Gx12 Receiver
  c. F1-FF3-RECV (U32) Quads 128/129/130: 25Gx12 Receiver
  d. F1-FF4-RECV (U35) Quads 132/133/134: 25Gx12 Receiver
  e. F2-FF3-XMIT (U41) Quads 128/129/130: 25Gx12 Transmitter
  f. F2-FF5-XCVR (U43) Quad 131: 25Gx4 Transceiver

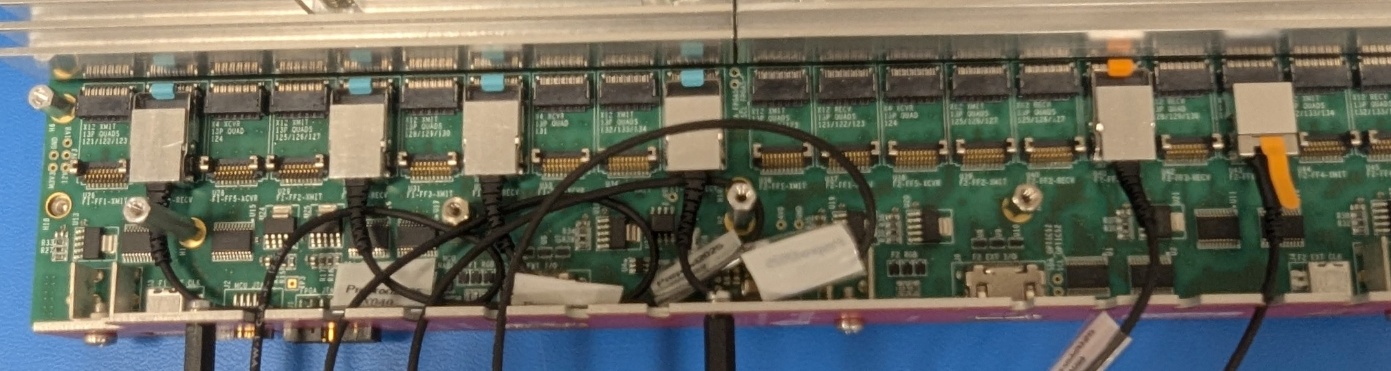
[picture p7: figure]

25Gx4 Transceiver

25Gx12 Transmitter

25Gx12 Receiver

1) Cut five 11-mm wide by 15-mm long strips of pink 1.78 mm thick Laird Tflex HD300 (DigiKey P/N 926-1594). Apply them to the top of the FireFly receivers and transmitter. Cut one 11-mm square piece and apply it to the top of the FireFly transceiver. Be sure it does not overlap the latch on this device. If you have trouble cutting and centering them, cut larger pieces to start with.

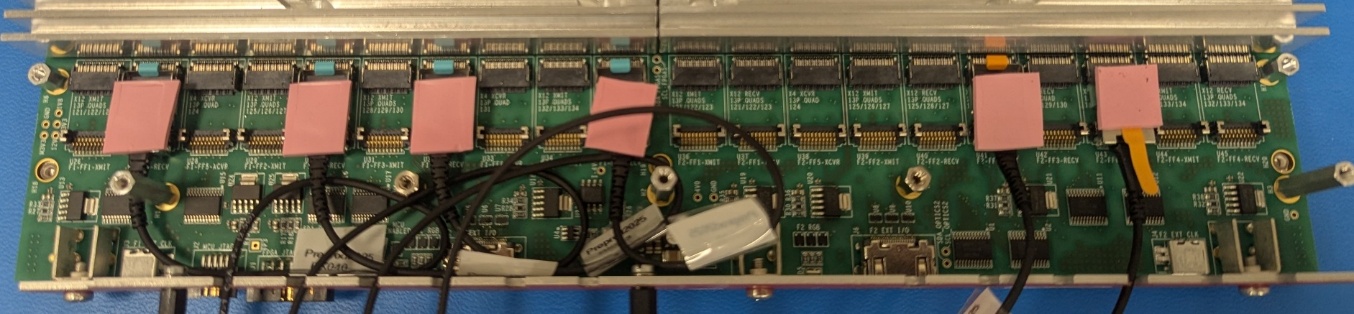
[picture p8: figure]

11-mm square (do not overlap latch)

11-mm by 15-mm ( 5 places)

2) Mount the FireFly heatsink using 4 M2.5x12 screws, 4 M2.5 shoulder washers, and 4 S001YJ1D springs. The shoulder on the washer should be inside the spring. Tighten the screws just until the springs are almost fully compressed.

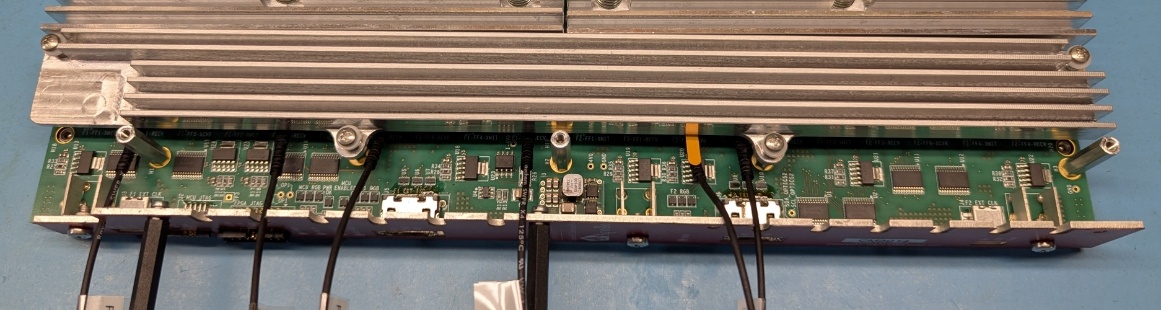
[picture p9: figure]
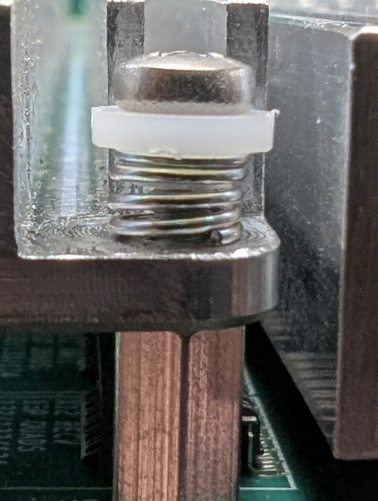
[picture p10: figure]

Spring almost fully compressed

3) One at a time, route the FireFly cables in the space between the front panel and the FireFly heatsink. Pass the cable through the slot in the front panel and plug the MTP connector into the front panel coupler block. Do them is the same order as they are installed on the board.

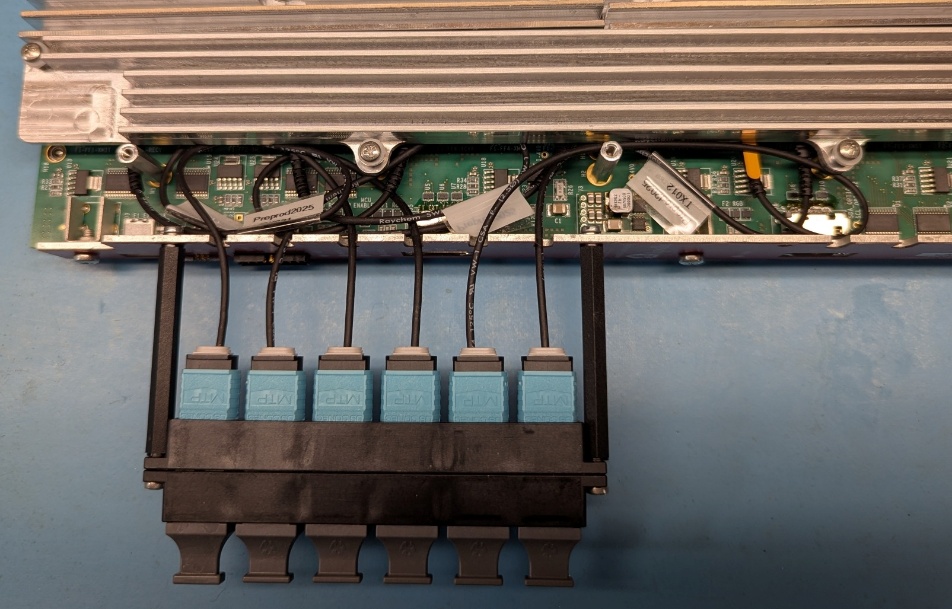
[picture p11: figure]

Cables routed

4) Label both sides of the coupler block. Use the Epson LW-PX750 with a 9 mm black-on-white cartridge. For the TF, use the data format shown below. The “^” character is a “space”.

TF block #1 (LABEL PRINTER FILE 03)

OT-DTC^^^^OT-DTC^^^^OT-DTC^^^^OT-DTC^^^^^^L1T^^^^^^^^DTH

^RECV^^^^^^RECV^^^^^^RECV^^^^^^RECV^^^^^^^XMIT^^^^^^^XCVR

^^#1^^^^^^^^^#2^^^^^^^^^#3^^^^^^^^^#4

IT-DTC block #1 (LABEL PRINTER FILE 04)

LUMI^1-1^^DTH^1-1^^^^^FE^1-1^^^^FE^1-2^^^^DTH^1-2^^^^FE^1-3

^^^^^^^^^^^^^^^^^^^^^^^^EMP^^^^^^^EMP^^^^^^^^^^^^^^^^^^EMP

^^^^^^^^^^^^^^^^^^^^^^^96-107^^^^^84-95^^^^^^^^^^^^^^^^^68-79

IT-DTC block #2 (LABEL PRINTER FILE 05)

DTH^2-1^^^^^FE^2-1^^^^FE^2-2^^^^DTH^2-2^^^^FE^2-3

^^^^^^^^^^^^^^EMP^^^^^^^EMP^^^^^^^^^^^^^^^^^^EMP

^^^^^^^^^^^^^96-107^^^^^84-95^^^^^^^^^^^^^^^^^68-79

5) With scissors, trim the excess from both ends of the tape, peel the backing, and apply the labels.

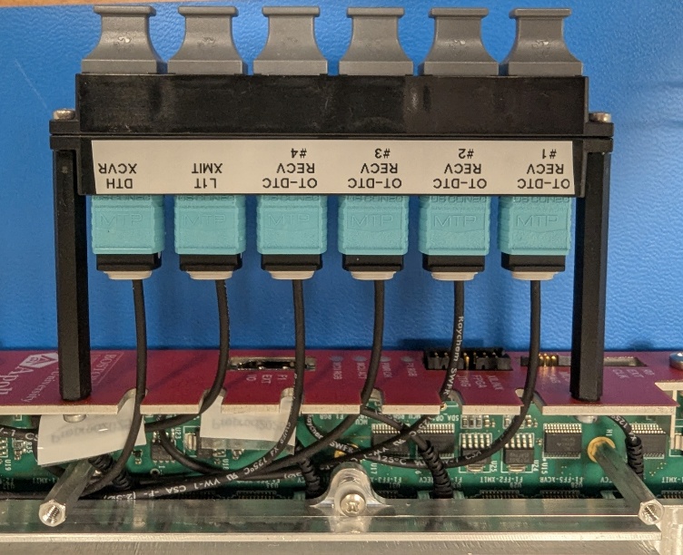
[picture p12: figure]

Viewed from top side of CM

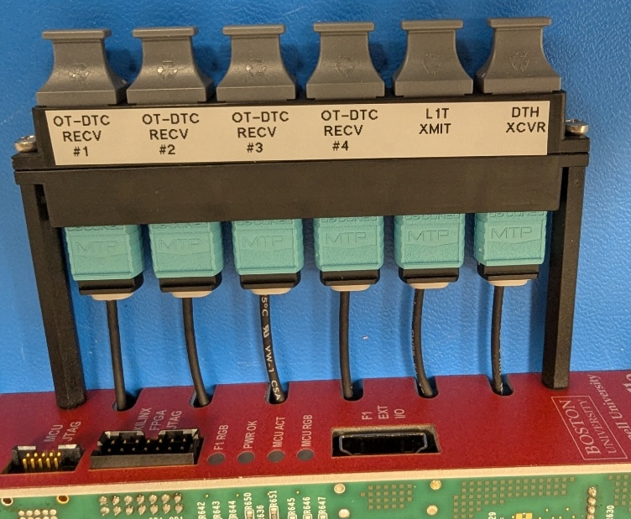
[picture p13: figure]

Viewed from bottom side of CM

### Details about installing FireFly modules

1) When installing a FireFly module with a retaining clip, the clip MUST be at its full height on both sides throughout the process.
  a. If the clip is down by even a small amount, it will bend the receiver on the socket when the FireFly is pushed in.
  b. Subsequently pressing down on the clip to lock it will be hard, and the receiver will be bent even more. The FireFly may be withdrawn slightly.
  c. Examining the empty socket will reveal bent receivers.
  d. A bent receiver can be VERY CAREFULLY straightened, but if you over-correct then the receiver can be broken off.

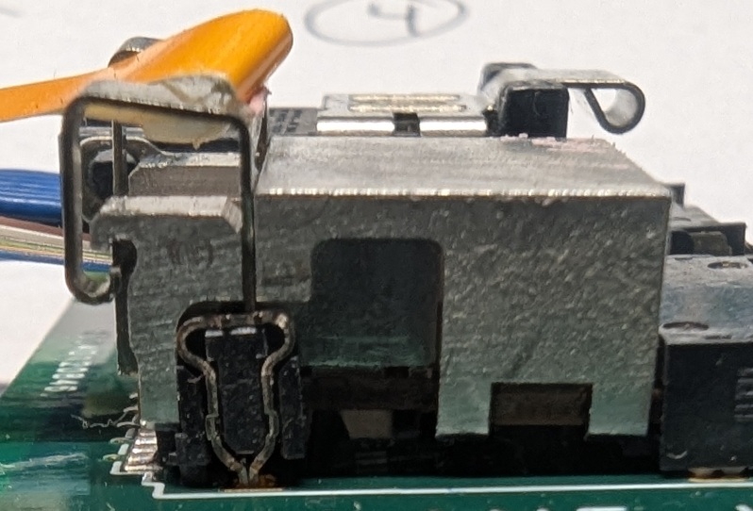
[picture p14: figure]

FireFly fully inserted

Clip aligned over receiver

Clip at full height during insertion

Figure 1 Correct alignment of the Retaining Clip for Insertion

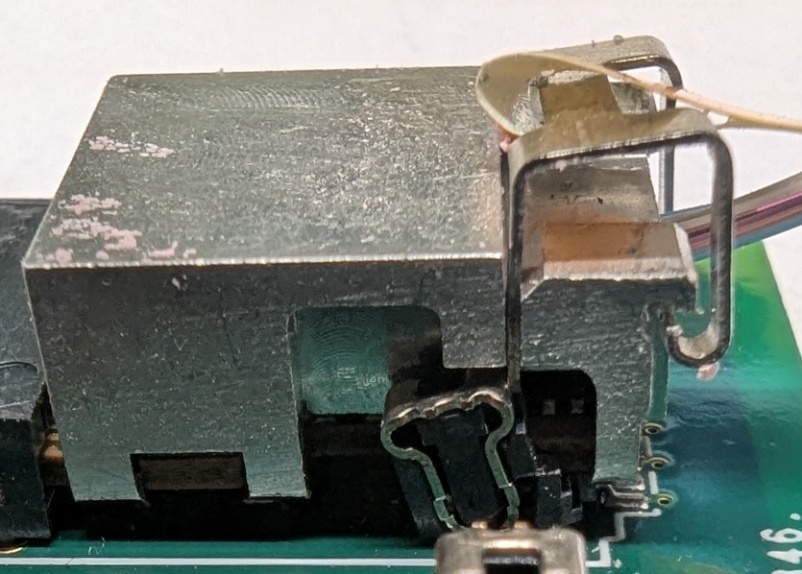
[picture p15: figure]

FireFly slightly withdrawn

Receiver bent forward when FireFly is pushed in

Clip slightly less than full height during insertion

Figure 2 Incorrect positioning of the Retaining Clip

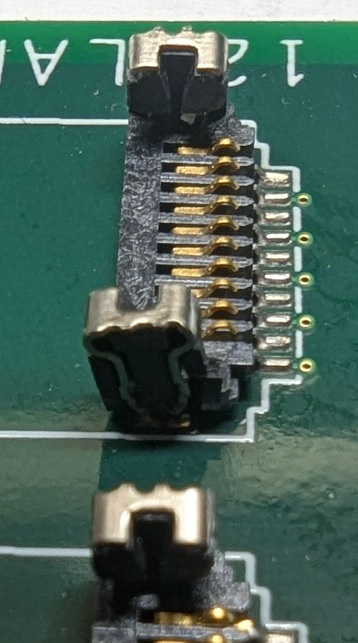
[picture p16: figure]

Bad (bent) receiver

Good (straight) receiver

Figure 3 Bent Retaining Clip Receiver

2) When installing a FireFly module or cable, it is first placed over the low-speed connector.
  a. If the module has a retaining clip, it must be at its full height. See instructions about retaining clips. Cable latches must be open.
  b. As the module or cable is held level, it is slightly pushed into the high-speed connector while verifying that it is entering the center of the connector.
  c. It is then fully slid into the high-speed connector. It should be flush against the connector.
  d. Some incorrect alignment issues are shown below. They may be slightly exaggerated.

Module is level before gold fingers enter high-speed connector.

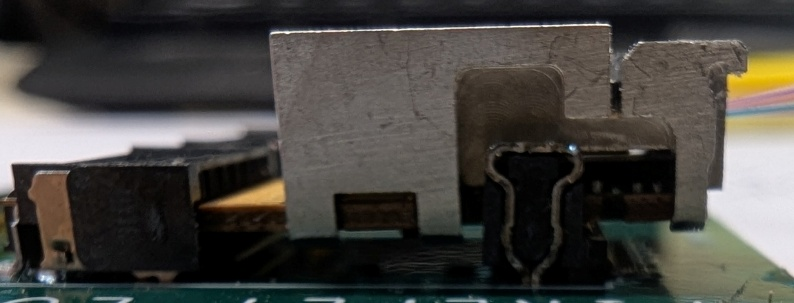
[picture p17: figure]

Module is then slid forward a slight bit while being checked for insertion into the center of the connector.

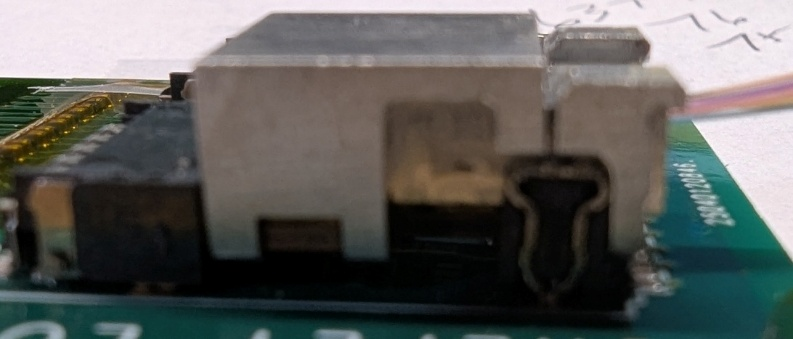
[picture p18: figure]

Module is slid fully into the connector. No gap, no visible gold.

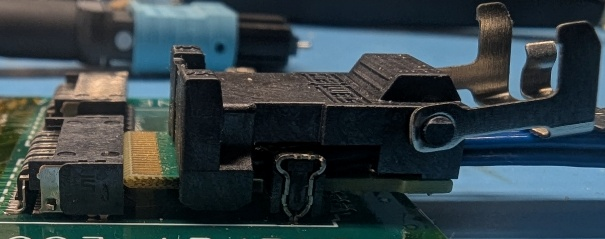
[picture p19: figure]
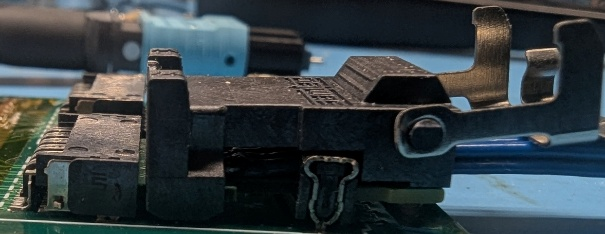
[picture p20: figure]
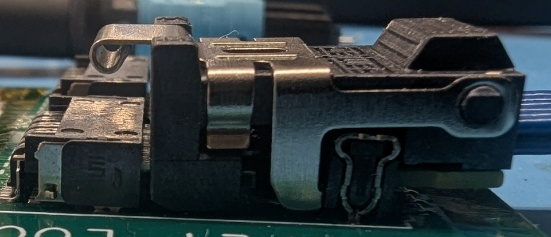
[picture p21: figure]

The closed latch on a cable must be behind, and not overlap, the side of the low-speed connector.

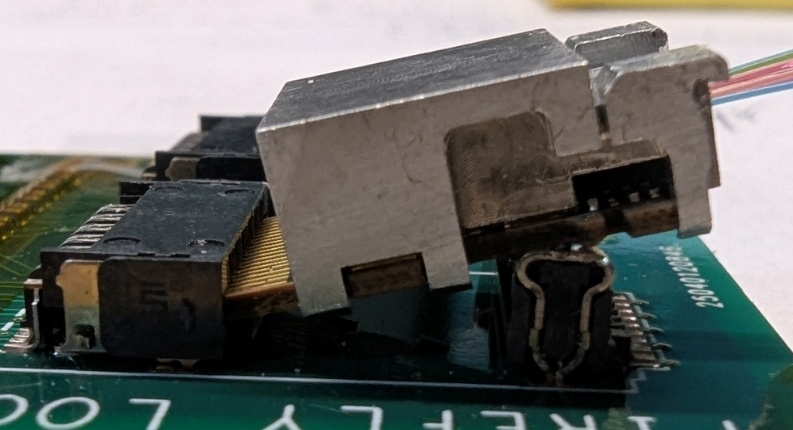
[picture p22: figure]

This module is tilted, and was started into the high-speed connector before being placed over the low-speed connector.

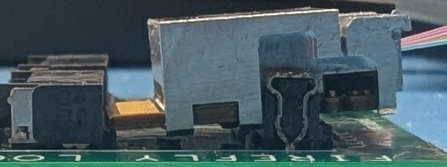
[picture p23: figure]

These fingers are not aligned with the center of the high-speed connector

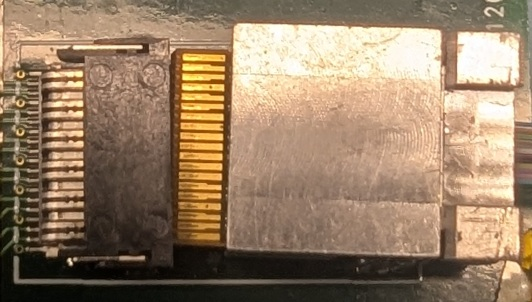
[picture p24: figure]

This module is not square to the connector
