apollo-lhc/Cornell_CM_Rev3_HW/BoardTesting/6089-127_RevA_final_SM_CM_assembly.pdf

1

### 6089-127 RevA Final SM-CM Assembly

### 1. Get an SM and unplug the front panel handle switch connector from the SM 1.1. These connectors are FRAGILE! 1.2. Do not pull on the wires

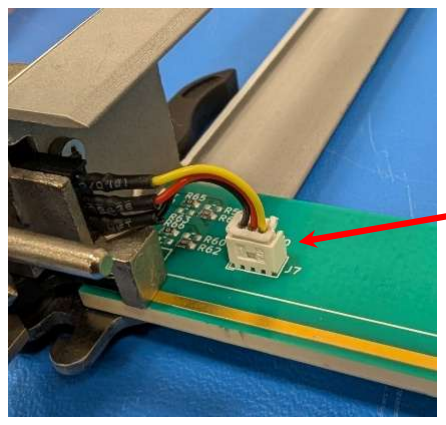
[picture p62: figure]

### 2. Flip the board over to the bottom. Remove the front panel handle screws 2.1. Use a #0 square-tip screwdriver 2.2. Do not use a Phillips-head screwdriver

2.3. Do not lose the screws. We don’t have spares.

### 2.4. Set aside the front panel

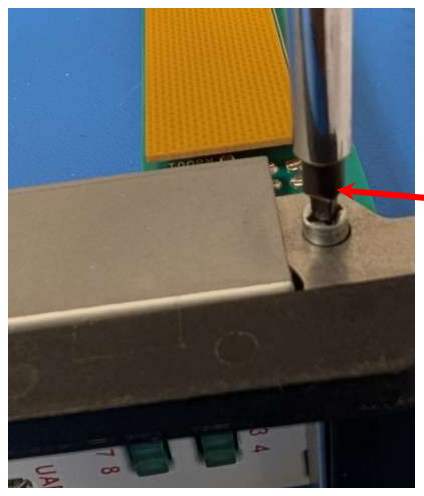
[picture p63: figure]

### 3. Remove the splice plates 3.1. The bottom cover does not need to be removed

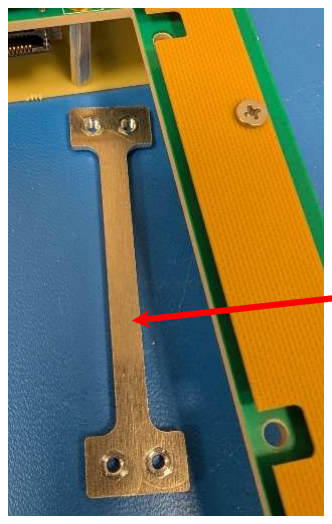
[picture p64: figure]

Splice plate removed
with cover in place

Square-drive screwdriver to remove handle screws

Front panel handle switch
connector

2

### 4. Flip the board over to the top. Unplug the front panel LED circuit board 4.1. Support the SM main board while unplugging

4.2. Wiggle it out. Do not bend the pins.

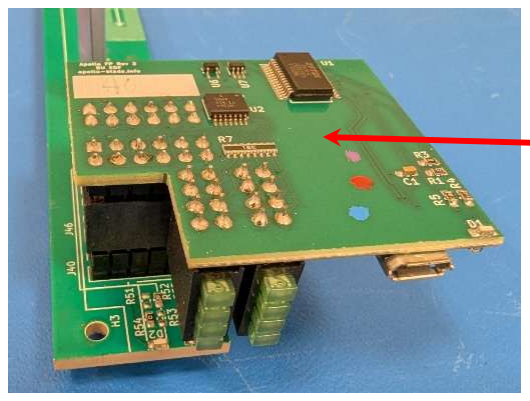
[picture p65: figure]

### 5. Get a CM

5.1. Do not use matching serial numbers. Matching numbers will become confusing.

### 6. Connect the CM to the SM 6.1. With the SM flat on the table, set the CM into the cutout opening

6.2. Mate the boards, pressing evenly on both sides with your index fingers on the SM top cover standoffs and your thumbs on the CM front panel

LED board ready for removal

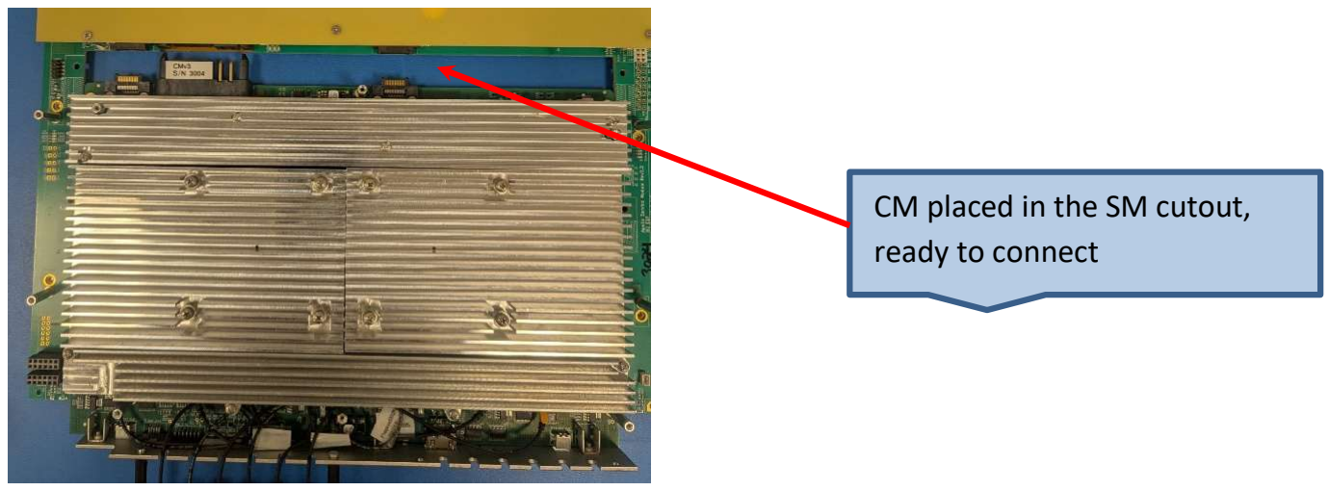
[picture p66: figure]
CM placed in the SM cutout, ready to connect
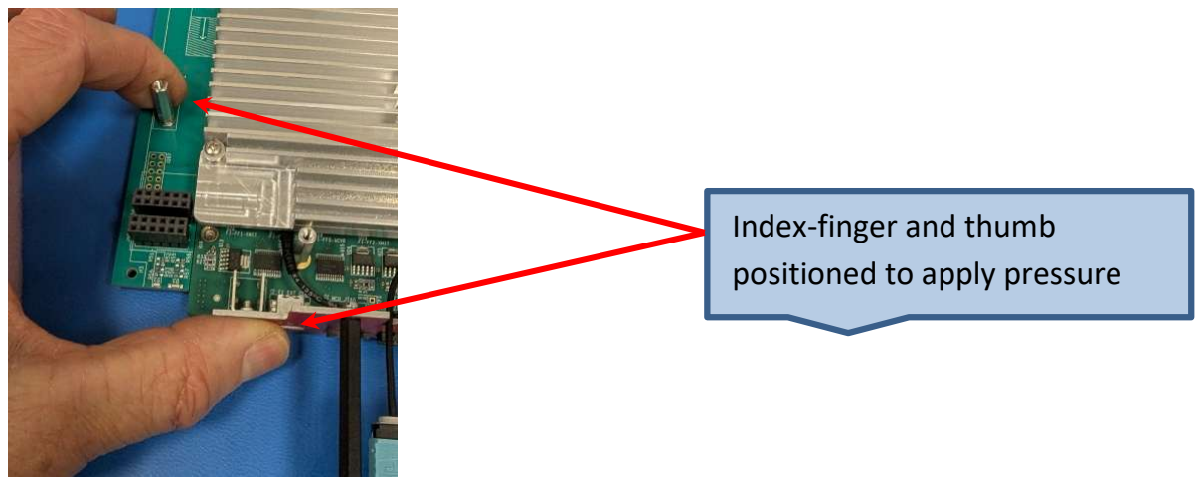
[picture p67: figure]
Index-finger and thumb positioned to apply pressure

3

Attach first splice plate
6.3. Without lifting either board, rotate the combo so that one side hangs over the edge of the table

### 6.4. Slide a splice plate into position 6.5. Loosely insert 4 6-mm long M3 screws from the bottom

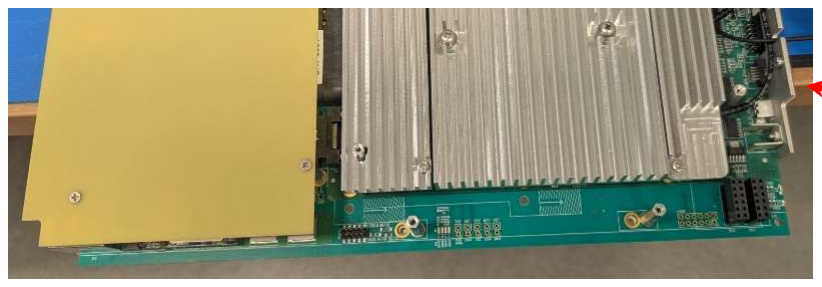
[picture p68: figure]
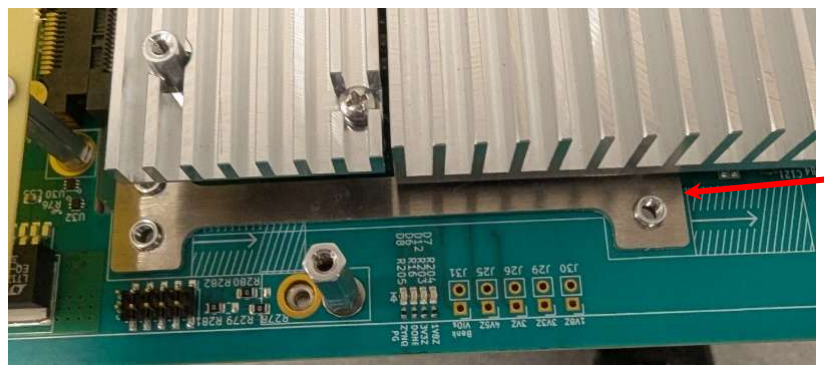
[picture p69: figure]
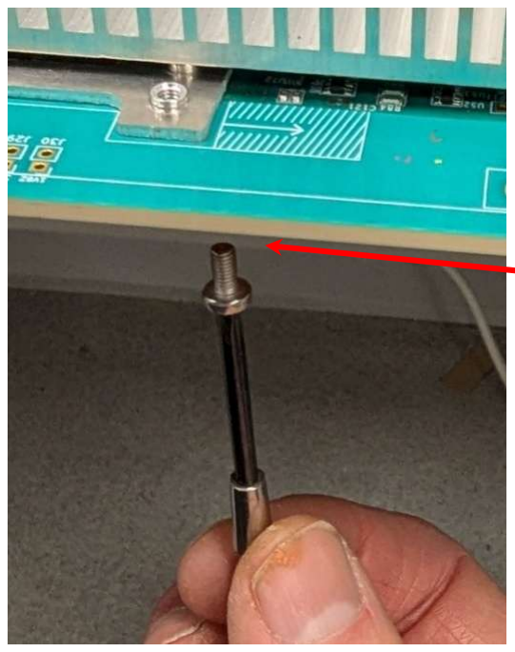
[picture p70: figure]

7. Rotate the combo so the opposite side is over the edge of the table and attach the second splice plate in the same way as the first

Insert screws from the bottom. A jeweler’s screwdriver is very handy.

Place splice plate in position

Hanging over edge of table

4

### 8. Flip the board over to the bottom and tighten the splice plate screws 8.1. Use the torque-driver and tighten to 3.5 in-lbs

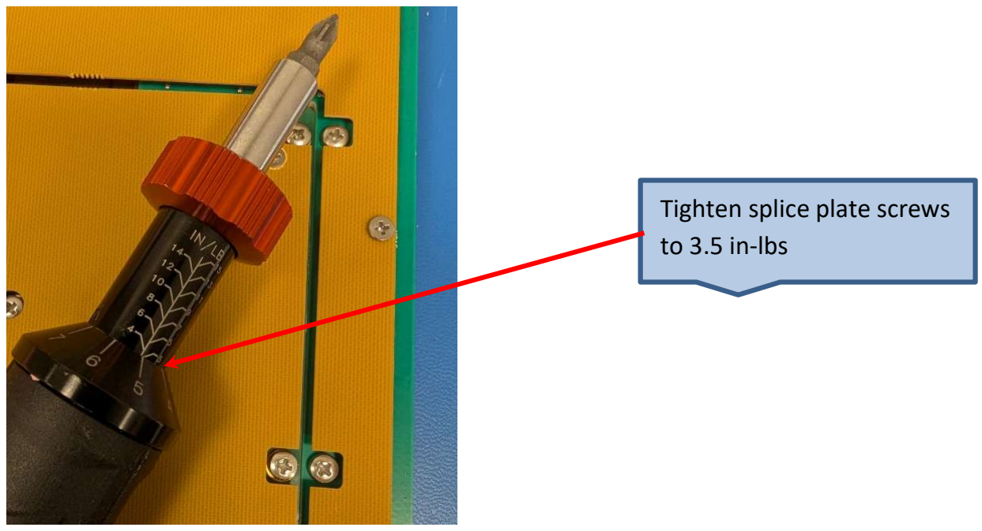
[picture p71: figure]
Tighten splice plate screws to 3.5 in-lbs

### 9. Flip the board over to the top side and install the SM’s front panel LED board

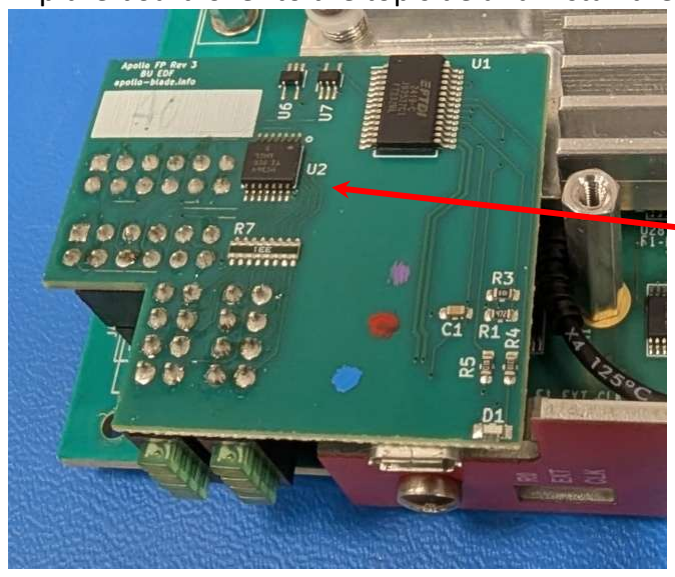
[picture p72: figure]
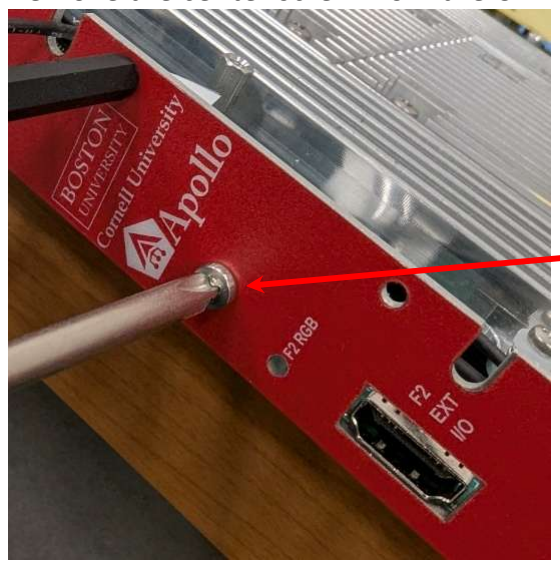
[picture p73: figure]

### 10. Remove the center screw from the CM front panel

Remove center screw

Plug in LED board

5

### 11. Attach the SM front panel

11.1. The SM front panel LED board will need some wiggling to align the LEDs and connector with the openings in

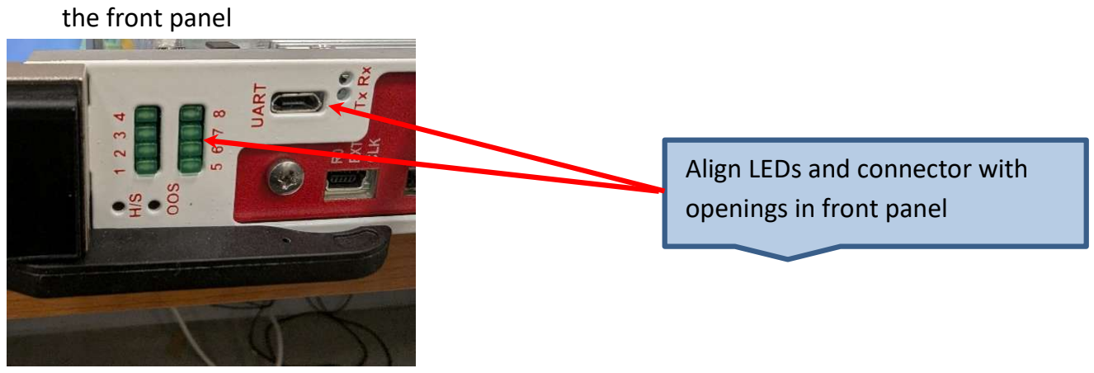
[picture p74: figure]
the front panel; Align LEDs and connector with openings in front panel

### 12. Flip the board over to the bottom side and install the front panel handle screws 12.1. Line up the holes in the handle mounts wit the holes in the board 12.2. Install the screws just barely snug

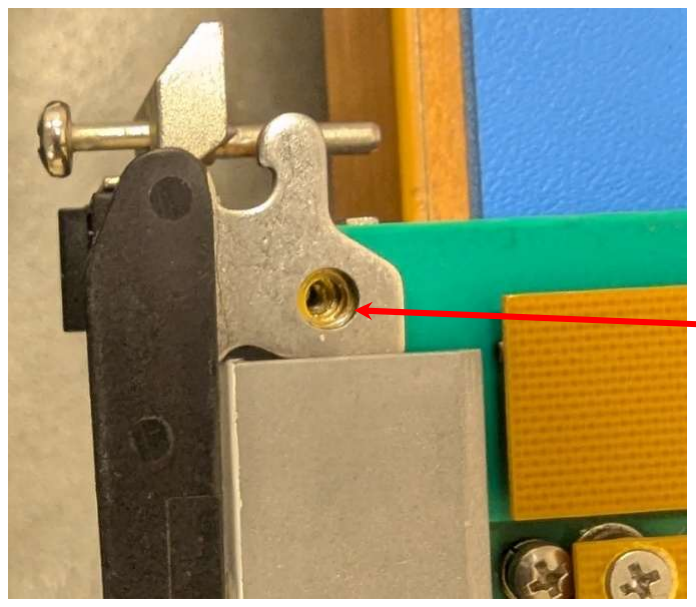
[picture p75: figure]
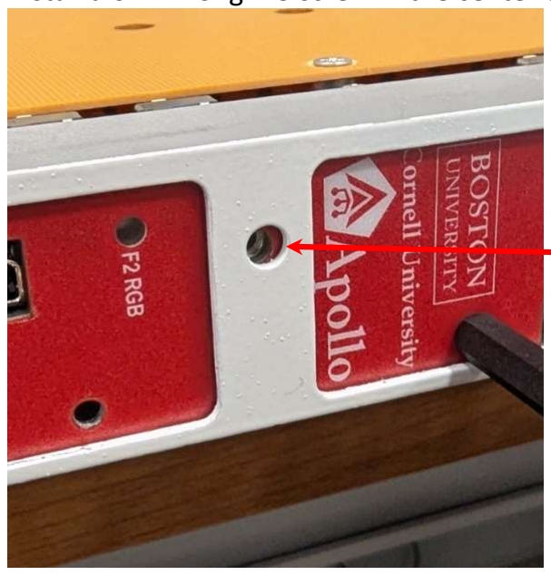
[picture p76: figure]

### 13. Install a 6 mm long M3 screw in the center of the front panel

M3 x 6-mm screw

Align board hole
with handle hole

6

### 14. Flip the board over to the top side and plug in the front panel switch connector

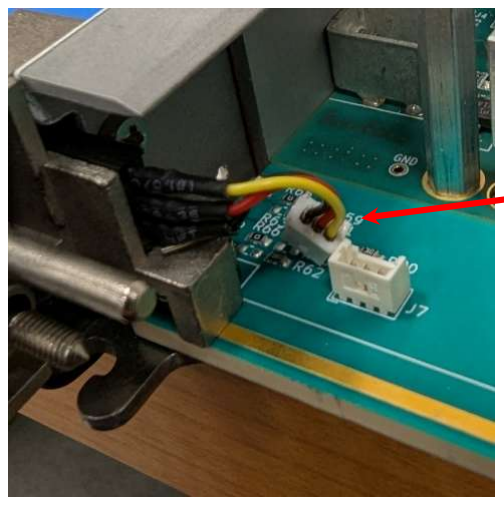
[picture p77: figure]

### 15. Attach a CM top cover with 10 M2.5 flat-head screws

16. Record the SM and CM serial numbers in the database.

### 16.1. On 18Mar2026, I mated SM3024 with CM3004

Plug in connector

Picture needed
