apollo-lhc/Cornell_CM_Rev3_HW/BoardTesting/Programming_the_FPGAs.docx

Programming the FPGAs

This guide details how to program the Apollo FPGAs using the Vivado GUI.

1) Open a Terminal

Once logged onto a Cornell computer connected to an Apollo board, open a terminal. (For production testing, the node to log onto is lnx231.classe.cornell.edu.) One way this can be done is by clicking the “Activities” button in the top left-hand corner of the screen.

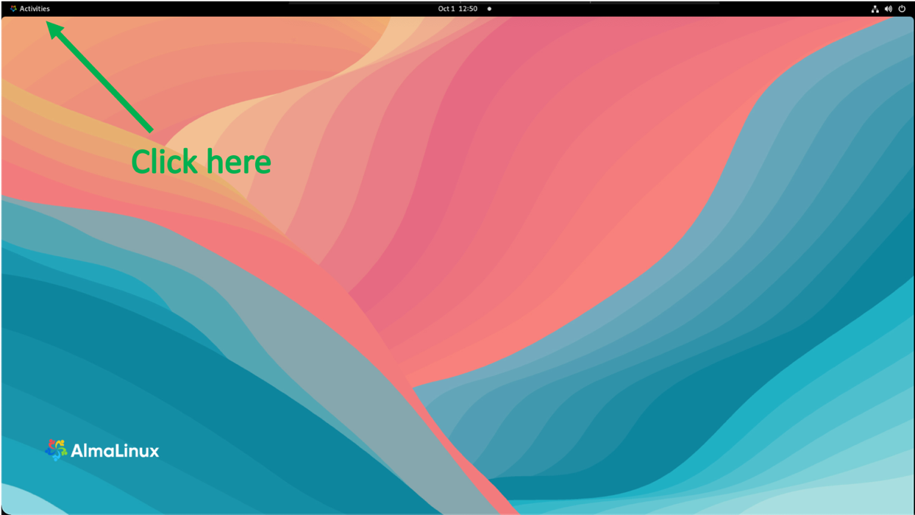
[picture p99: figure]

Next, click the terminal icon now at the bottom of the screen.

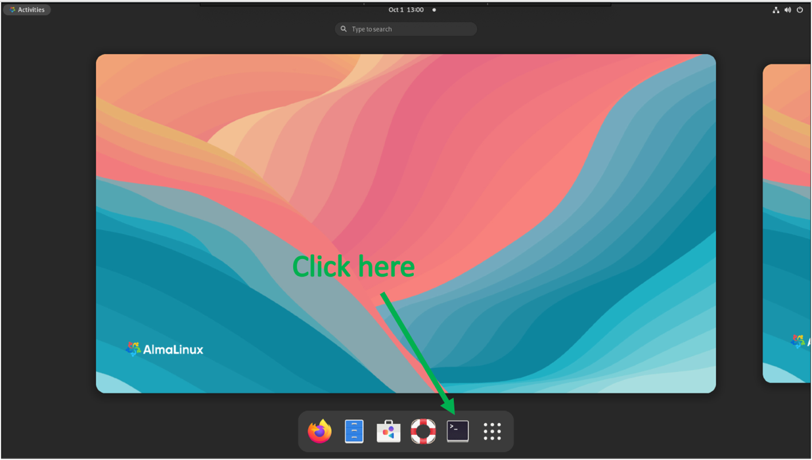
[picture p100: figure]

2) Open the Vivado GUI

We are going to use this terminal to open an instance of the Vivado GUI. Before we can do that, we must tell the computer where Vivado is installed and which version we want to use. Do this by entering the following commands into the terminal:

source /nfs/opt/Xilinx/Vivado/2020.2/settings64.sh

export XILINXD_LICENSE_FILE=2100@lnxlm

vivado

Note that vivado creates a log file where it is launched, so make sure you have write permission in the directory you are writing in.

Upon entering the above commands into the terminal, the terminal should print the following messages:

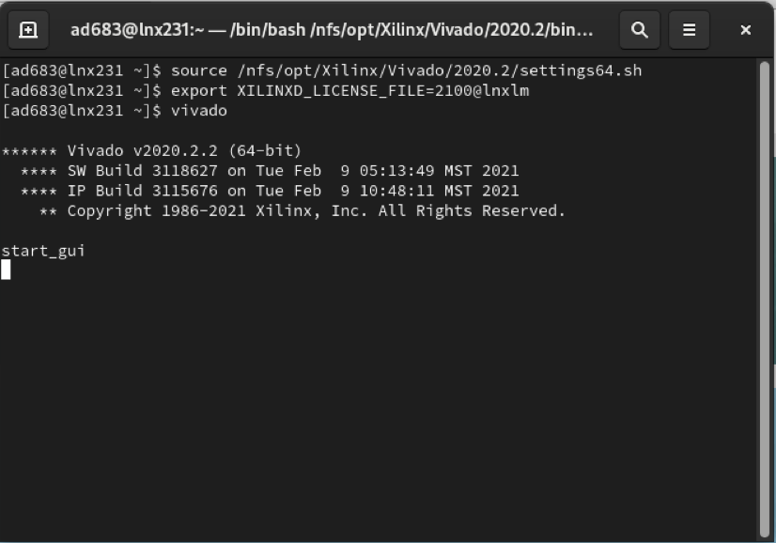
[picture p101: figure]

After a few seconds, the Vivado GUI should appear on your screen.

3) Open the Vivado Hardware Manager

Next, click “Open Hardware Manager” in the “Tasks” section.

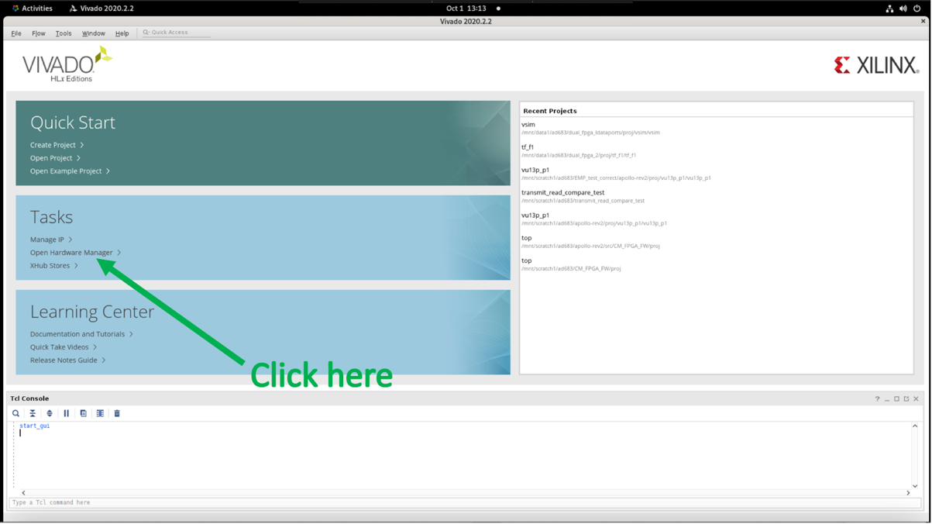
[picture p102: figure]

This should open the hardware manager designed to program, test, and interact in other ways with the Apollo board.

4) Connect to the Hardware Target

Before we do any of those things, we need to connect the board to the hardware manager. Look in the box labeled “Hardware” in the top left of the screen. Click the auto-connect button that looks like a dark wrench and a light wrench facing each other.

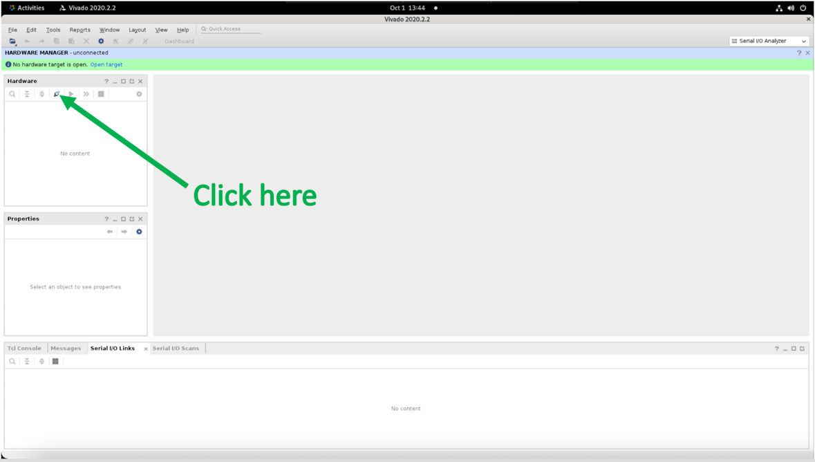
[picture p103: figure]

Auto-connect should take a few seconds to complete. Upon completion, the hardware manager should have connected to a target named: “xilinx_tcf/Xilinx/00001631afcb01”

You should see this target name next to a green square with a red dot in the “Hardware” box like so. Below that, you should see the two devices corresponding to the two FPGAs. They are represented by jagged blue squares. The name next to one device should read “xcvu13p_0”, and the other should read “xcvu13p_1”. If instead you see a long scrollable list of other components, don’t worry. This just means that at least one of the boards is already programmed. The device may read as “Programmed” or “Not programmed” next to the name to indicate this. Either setting is fine. The procedure for programming the boards will be the same. The important point is that you can find the two devices of interest in that list. However, you may want to click the downward facing arrow next to programmed devices to hide the MGT list so you don’t have to scroll around to find the devices we want to program.

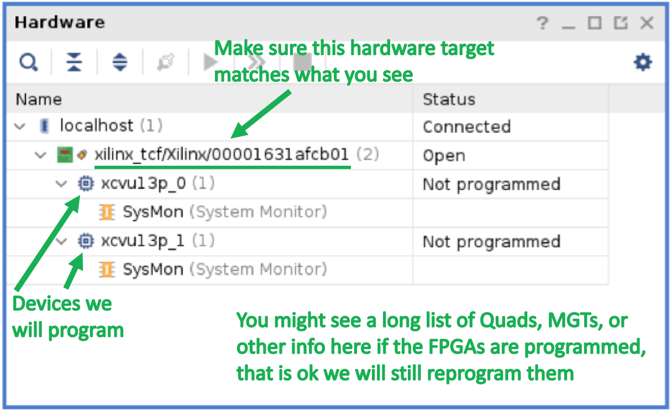
[picture p104: figure]

5) Select FPGA to Program

Next, right click the first device (the one labeled “xcvu13p_0”) to open an options menu shown below. Then click “Program Device…”

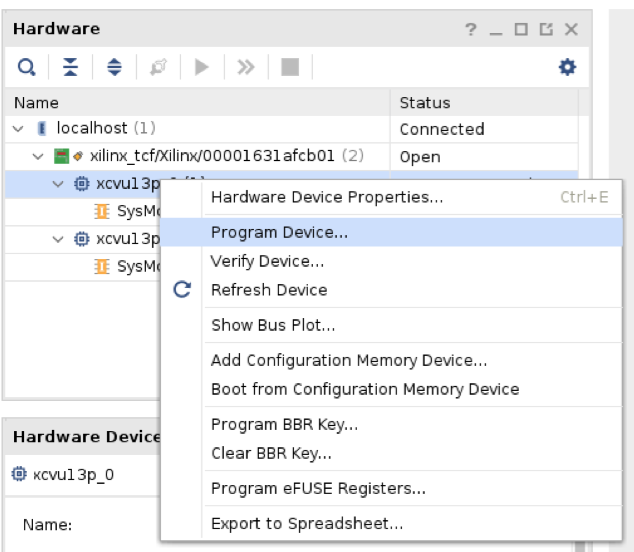
[picture p105: figure]

6) Choose the Firmware with which to Program the FPGA

That will open a window titled “Program Device” as shown below. Finally, copy and paste the path to your bit file (e.g. /nfs/cms/tracktrigger/apollo/clocktest/clock_test.bit) in the “Bitstream file:” text box. Make sure you are copying the correct firmware. Some firmwares are specific to one FPGA or the other. Other firmwares expect certain connectors on the external links and using the wrong firmware could damage the board as a result. Finally, click the blue “Program” button to program the first FPGA (xcvu13p_0) with the desired firmware.

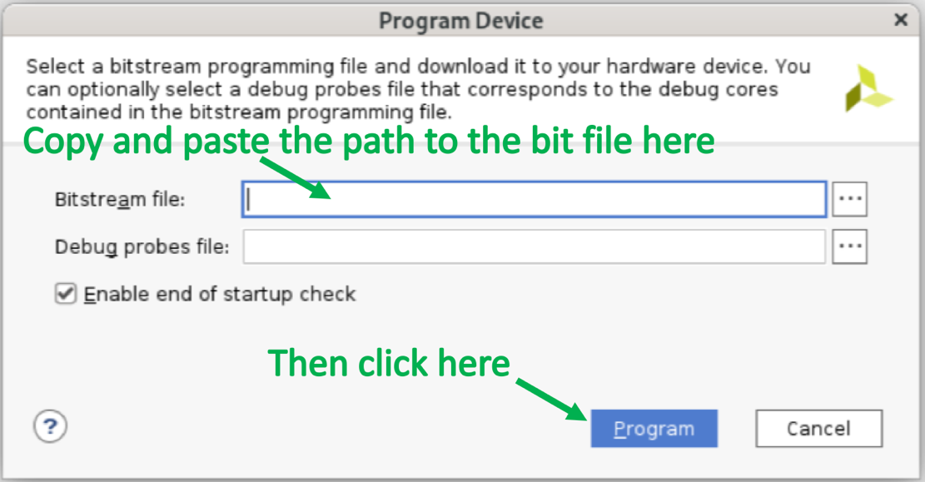
[picture p106: figure]

You will then see a loading screen like the one below. It may take a few minutes to finish, but upon completion the FPGA will be programmed.

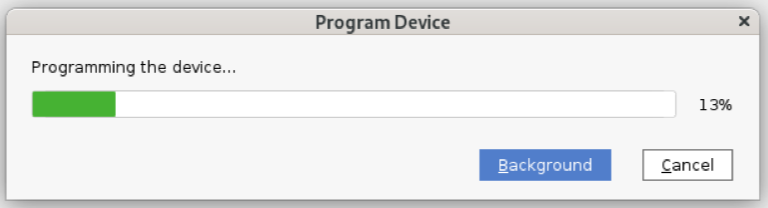
[picture p107: figure]

7) Program the other FPGA

Programming the second FPGA (xcvu13p_1) is a similar procedure. Repeat the procedure detailed in steps 5) and 6). This time right clicking on the other device for step 5) and select “Program Device…”. Then repeat step 6) making sure to copy and paste the correct firmware for FPGA 2 (xcvu13p_1).
