apollo-lhc/Cornell_CM_Rev3_HW/BoardTesting/6089-126_CM_TESTBOARD_SCHEMATIC_04Nov2024.pdf

# ZYNQ UART

## THESE CONNECTORS ARE FOR A

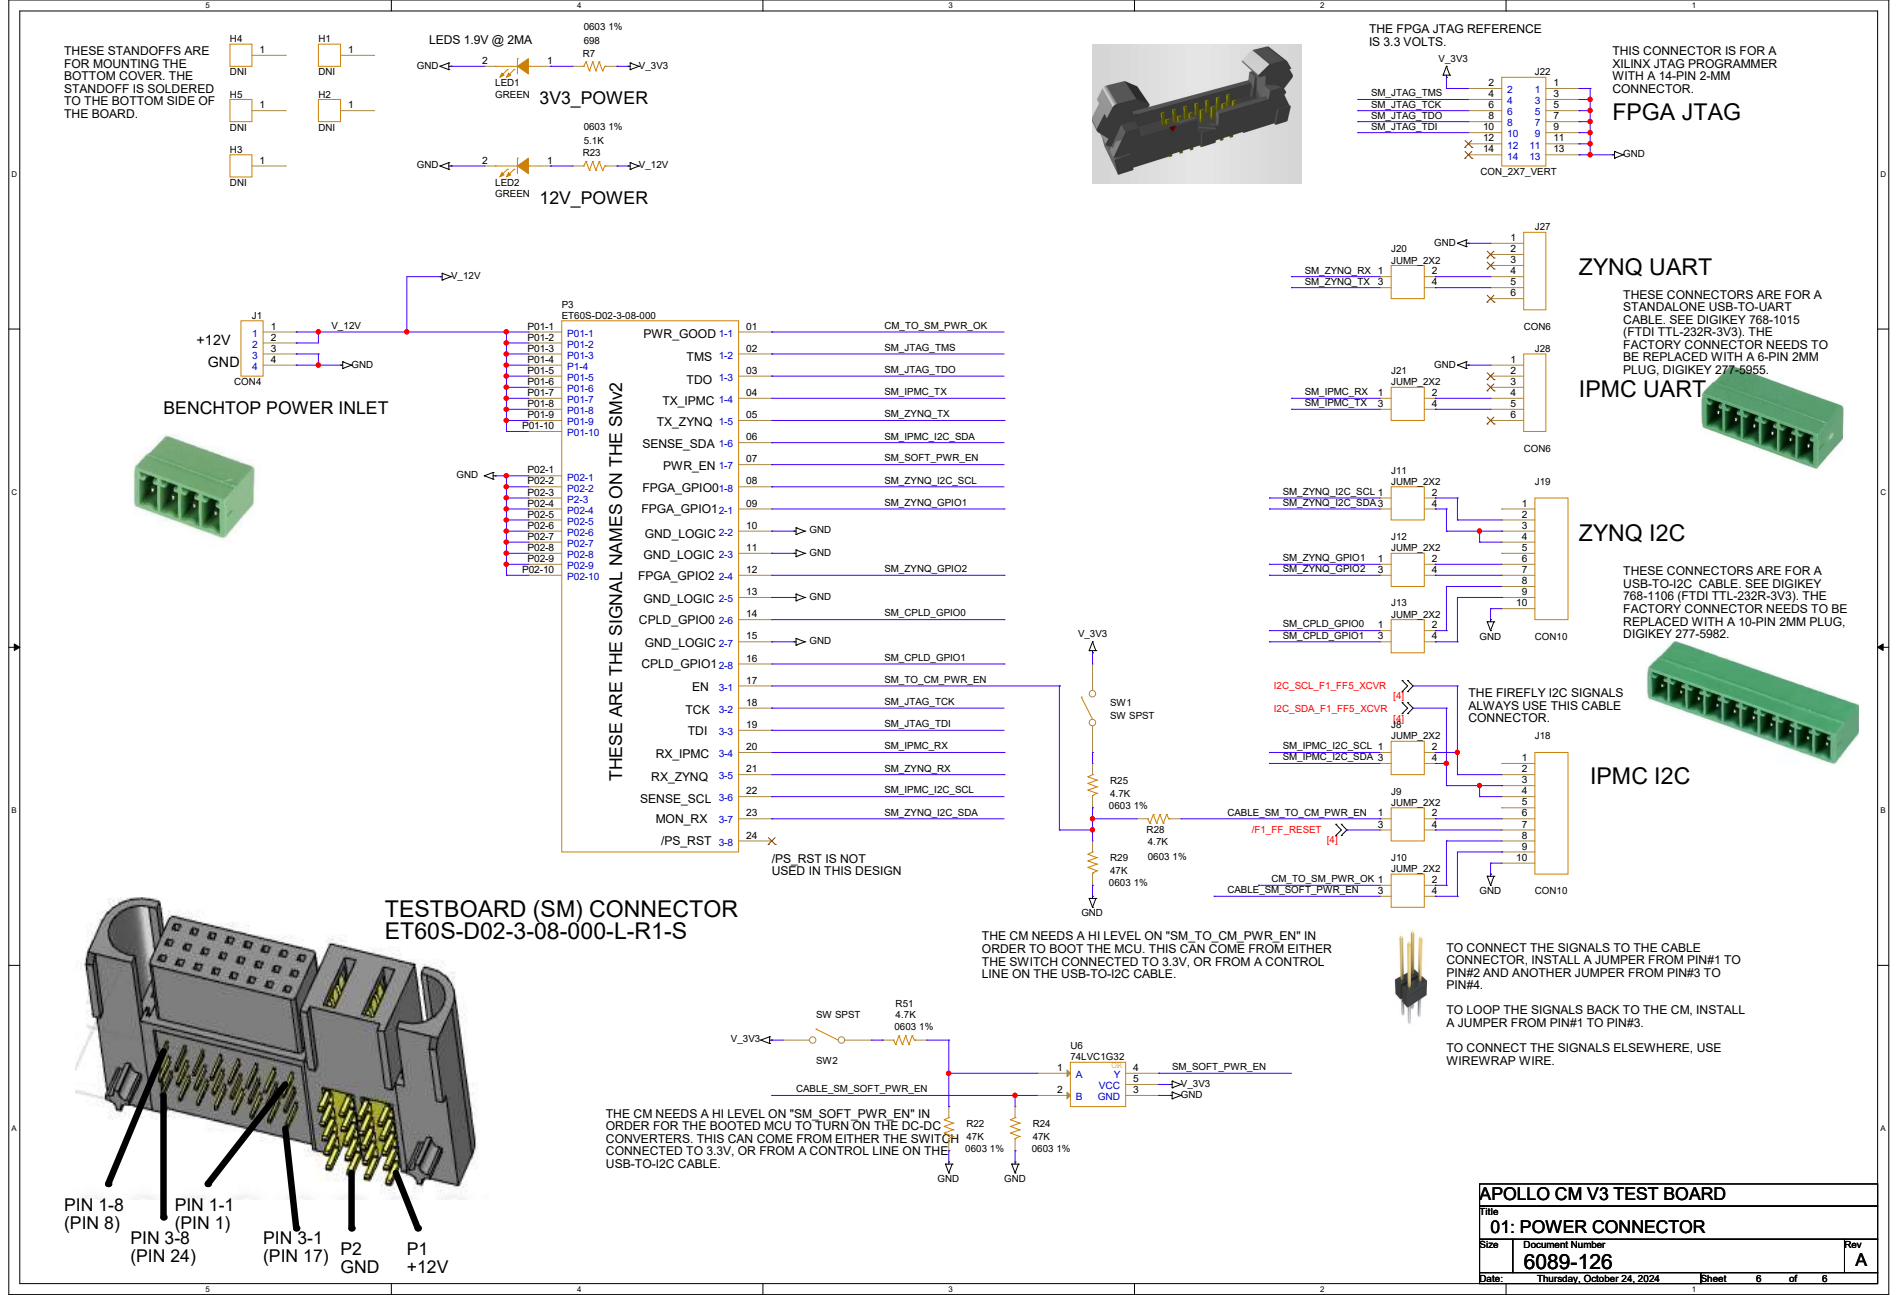
[picture p122: page 1]

THE FPGA JTAG REFERENCE
IS 3.3 VOLTS.

THESE STANDOFFS ARE
FOR MOUNTING THE
BOTTOM COVER. THE
STANDOFF IS SOLDERED
TO THE BOTTOM SIDE OF
THE BOARD.

THIS CONNECTOR IS FOR A
XILINX JTAG PROGRAMMER
WITH A 14-PIN 2-MM
CONNECTOR.
FPGA JTAG

STANDALONE USB-TO-UART
CABLE. SEE DIGIKEY 768-1015
(FTDI TTL-232R-3V3). THE
FACTORY CONNECTOR NEEDS TO
BE REPLACED WITH A 6-PIN 2MM
PLUG, DIGIKEY 277-5955.
IPMC UART

THESE CONNECTORS ARE FOR A
USB-TO-I2C CABLE. SEE DIGIKEY
768-1106 (FTDI TTL-232R-3V3). THE
FACTORY CONNECTOR NEEDS TO BE
REPLACED WITH A 10-PIN 2MM PLUG,
DIGIKEY 277-5982.

/PS_RST IS NOT
USED IN THIS DESIGN

THE CM NEEDS A HI LEVEL ON "SM_TO_CM_PWR_EN" IN
ORDER TO BOOT THE MCU. THIS CAN COME FROM EITHER
THE SWITCH CONNECTED TO 3.3V, OR FROM A CONTROL
LINE ON THE USB-TO-I2C CABLE.

TO CONNECT THE SIGNALS TO THE CABLE
CONNECTOR, INSTALL A JUMPER FROM PIN#1 TO
PIN#2 AND ANOTHER JUMPER FROM PIN#3 TO
PIN#4.
TO LOOP THE SIGNALS BACK TO THE CM, INSTALL
A JUMPER FROM PIN#1 TO PIN#3.
TO CONNECT THE SIGNALS ELSEWHERE, USE
WIREWRAP WIRE.

THE CM NEEDS A HI LEVEL ON "SM_SOFT_PWR_EN" IN
ORDER FOR THE BOOTED MCU TO TURN ON THE DC-DC
CONVERTERS. THIS CAN COME FROM EITHER THE SWITCH
CONNECTED TO 3.3V, OR FROM A CONTROL LINE ON THE
USB-TO-I2C CABLE.

APOLLO CM V3 TEST BOARD
01: POWER CONNECTOR

## THE SIGNALS THAT START WITH "MGT" ARE HIGH SPEED DIFFERENTIAL PAIRS CONNECTED TO GIGABIT

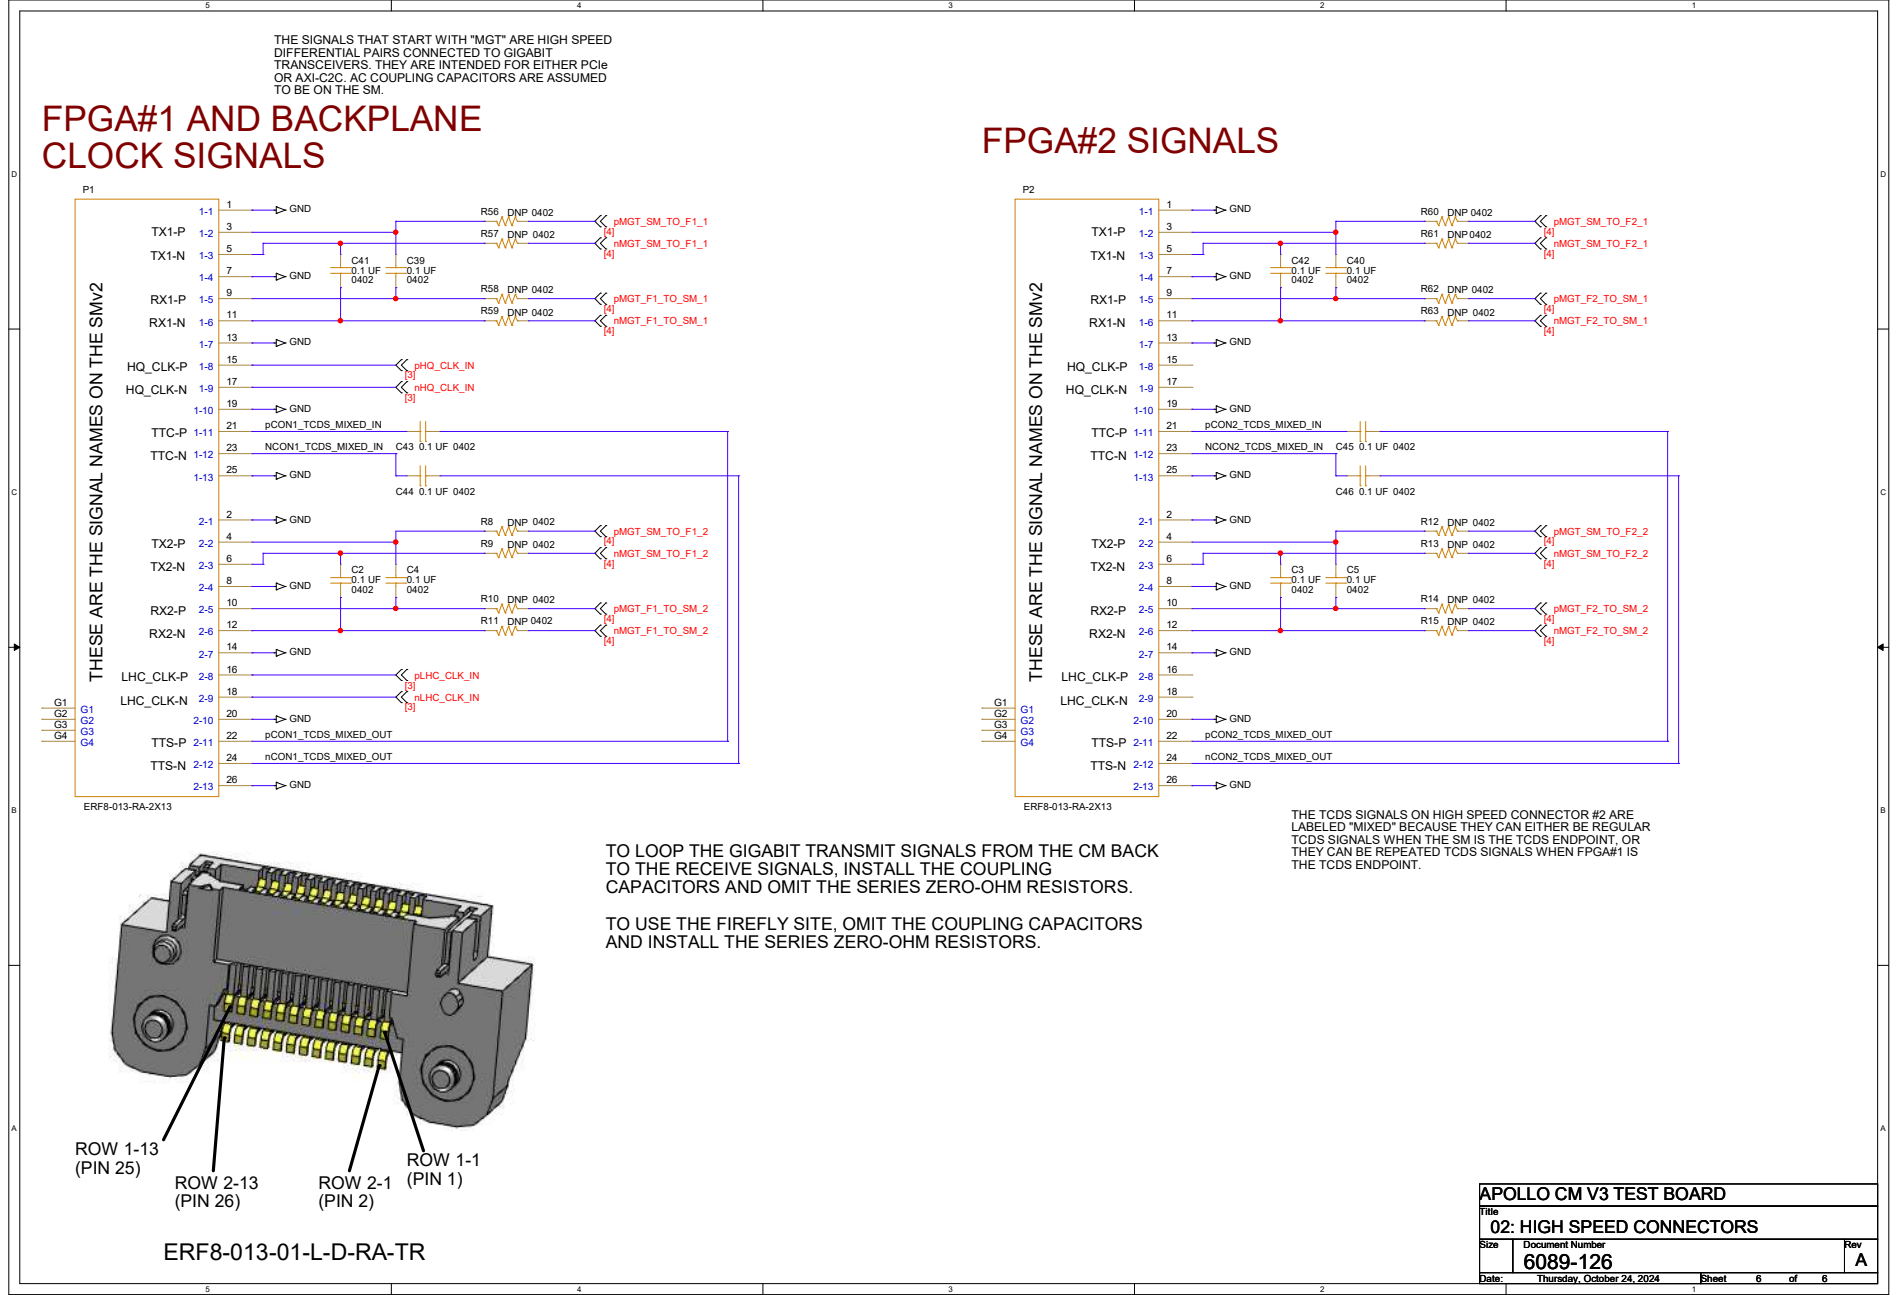
[picture p123: page 2]

TRANSCEIVERS. THEY ARE INTENDED FOR EITHER PCIe
OR AXI-C2C. AC COUPLING CAPACITORS ARE ASSUMED
TO BE ON THE SM.

FPGA#1 AND BACKPLANE
CLOCK SIGNALS
RX1-P THESE ARE THE SIGNAL NAMES ON THE SMv2

GND GND GND GND GND

R15 DNP 0402 C46 0.1 UF 0402 R63 DNP 0402 R10 DNP 0402 C2

THE TCDS SIGNALS ON HIGH SPEED CONNECTOR #2 ARE
LABELED "MIXED" BECAUSE THEY CAN EITHER BE REGULAR
TCDS SIGNALS WHEN THE SM IS THE TCDS ENDPOINT, OR
THEY CAN BE REPEATED TCDS SIGNALS WHEN FPGA#1 IS
THE TCDS ENDPOINT.

TO LOOP THE GIGABIT TRANSMIT SIGNALS FROM THE CM BACK
TO THE RECEIVE SIGNALS, INSTALL THE COUPLING
CAPACITORS AND OMIT THE SERIES ZERO-OHM RESISTORS.
TO USE THE FIREFLY SITE, OMIT THE COUPLING CAPACITORS
AND INSTALL THE SERIES ZERO-OHM RESISTORS.

# IN_320MHZ

# IN_FP_CLK1

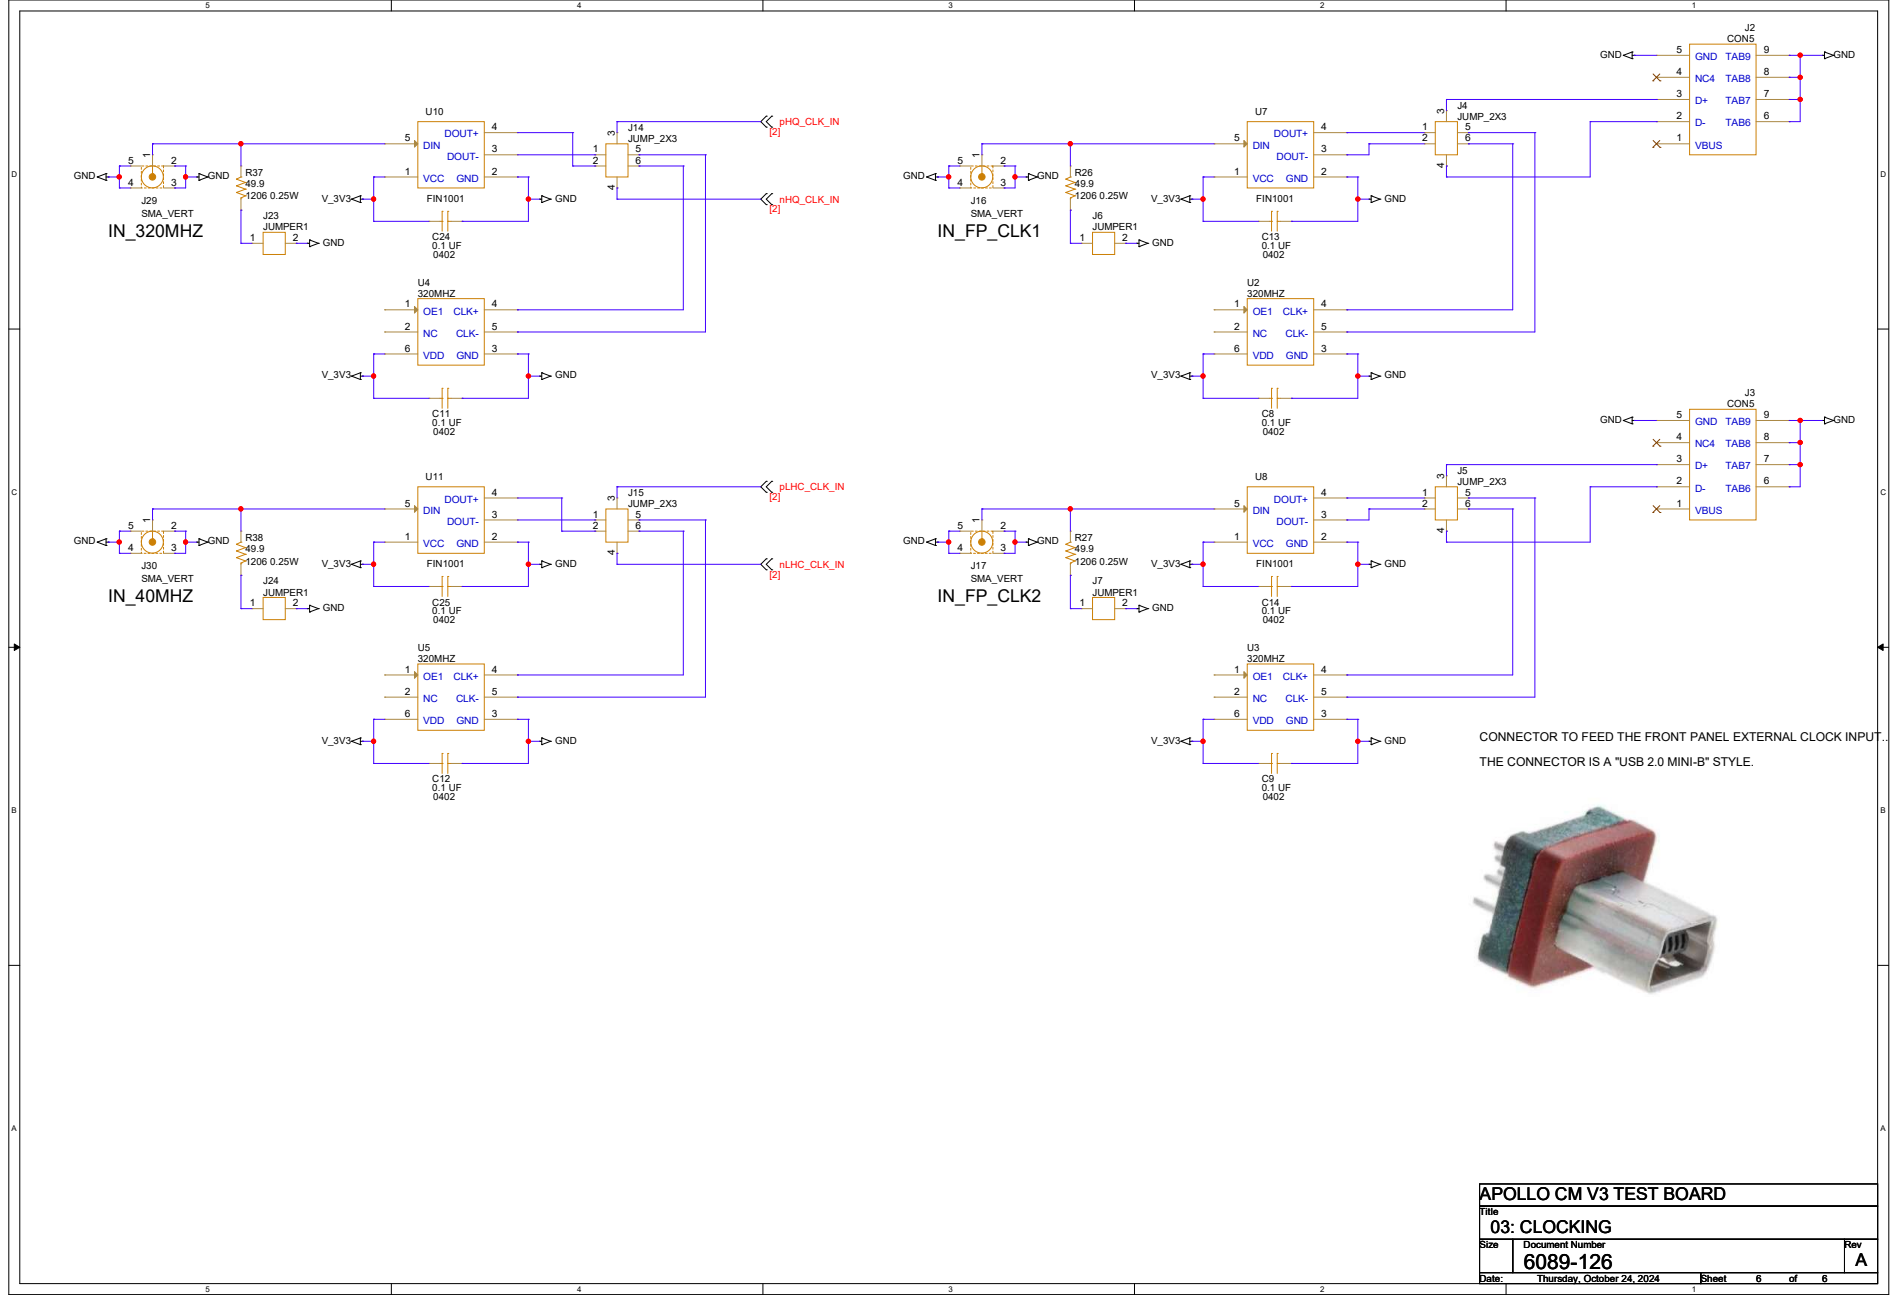
[picture p124: page 3]

CONNECTOR TO FEED THE FRONT PANEL EXTERNAL CLOCK INPUT..
THE CONNECTOR IS A "USB 2.0 MINI-B" STYLE.

# GND_B7 B7 GND_A7 A7 GND_B4 B4 GND_A4 A4 GND_B1 B1 GND_A1 A1

# RX3P B14 RX3N B15 RX4P A14 RX4N A15 TX1P A3 TX1N A2 TX2P B3 TX2N B2 TX3P A6

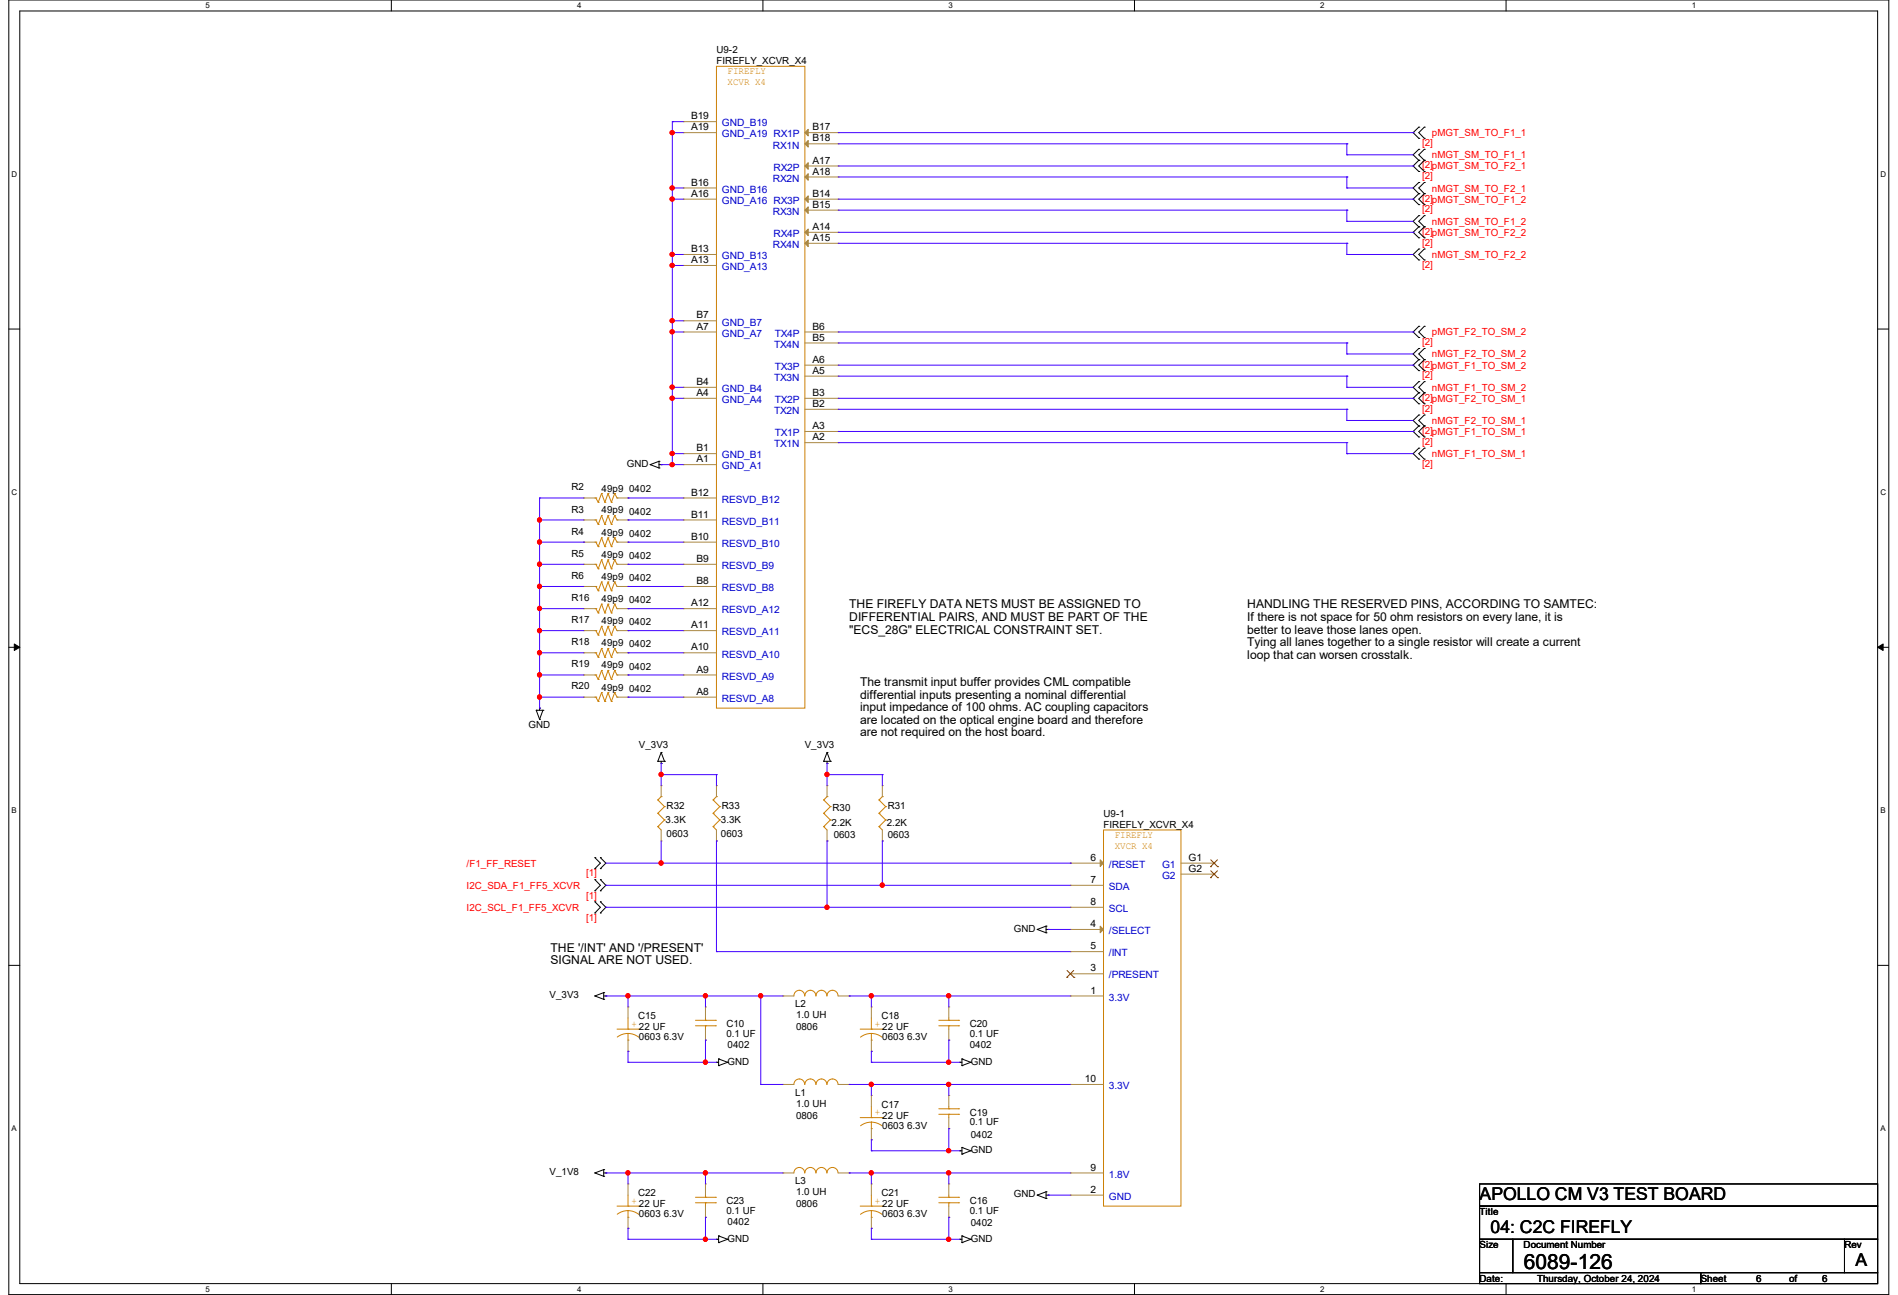
[picture p125: page 4]

THE FIREFLY DATA NETS MUST BE ASSIGNED TO
DIFFERENTIAL PAIRS, AND MUST BE PART OF THE
"ECS_28G" ELECTRICAL CONSTRAINT SET.

HANDLING THE RESERVED PINS, ACCORDING TO SAMTEC:
If there is not space for 50 ohm resistors on every lane, it is
better to leave those lanes open.
Tying all lanes together to a single resistor will create a current
loop that can worsen crosstalk.

The transmit input buffer provides CML compatible
differential inputs presenting a nominal differential
input impedance of 100 ohms. AC coupling capacitors
are located on the optical engine board and therefore
are not required on the host board.

THE '/INT' AND '/PRESENT'
SIGNAL ARE NOT USED.

## THIS DEVICE DOES NOT REQUIRE ANY

EXTERNAL OUTPUT CAPACITORS.

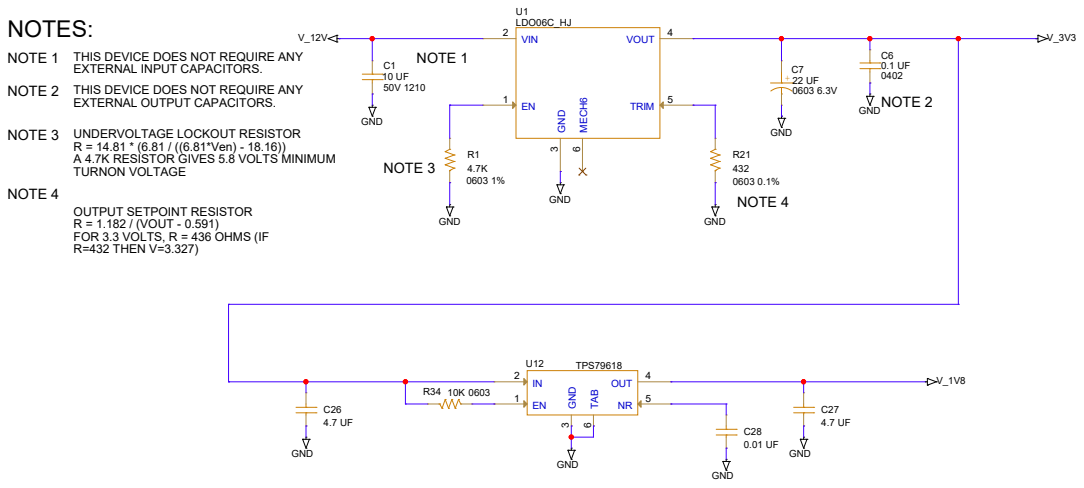
[picture p126: page 5]

THIS DEVICE DOES NOT REQUIRE ANY
EXTERNAL INPUT CAPACITORS.

NOTE 3 UNDERVOLTAGE LOCKOUT RESISTOR

R = 14.81 * (6.81 / ((6.81*Ven) - 18.16))
A 4.7K RESISTOR GIVES 5.8 VOLTS MINIMUM
TURNON VOLTAGE

OUTPUT SETPOINT RESISTOR
R = 1.182 / (VOUT - 0.591)
FOR 3.3 VOLTS, R = 436 OHMS (IF
R=432 THEN V=3.327)

## EVEN AND ODD ARE ON OPPOSITE SIDES. JUMPER

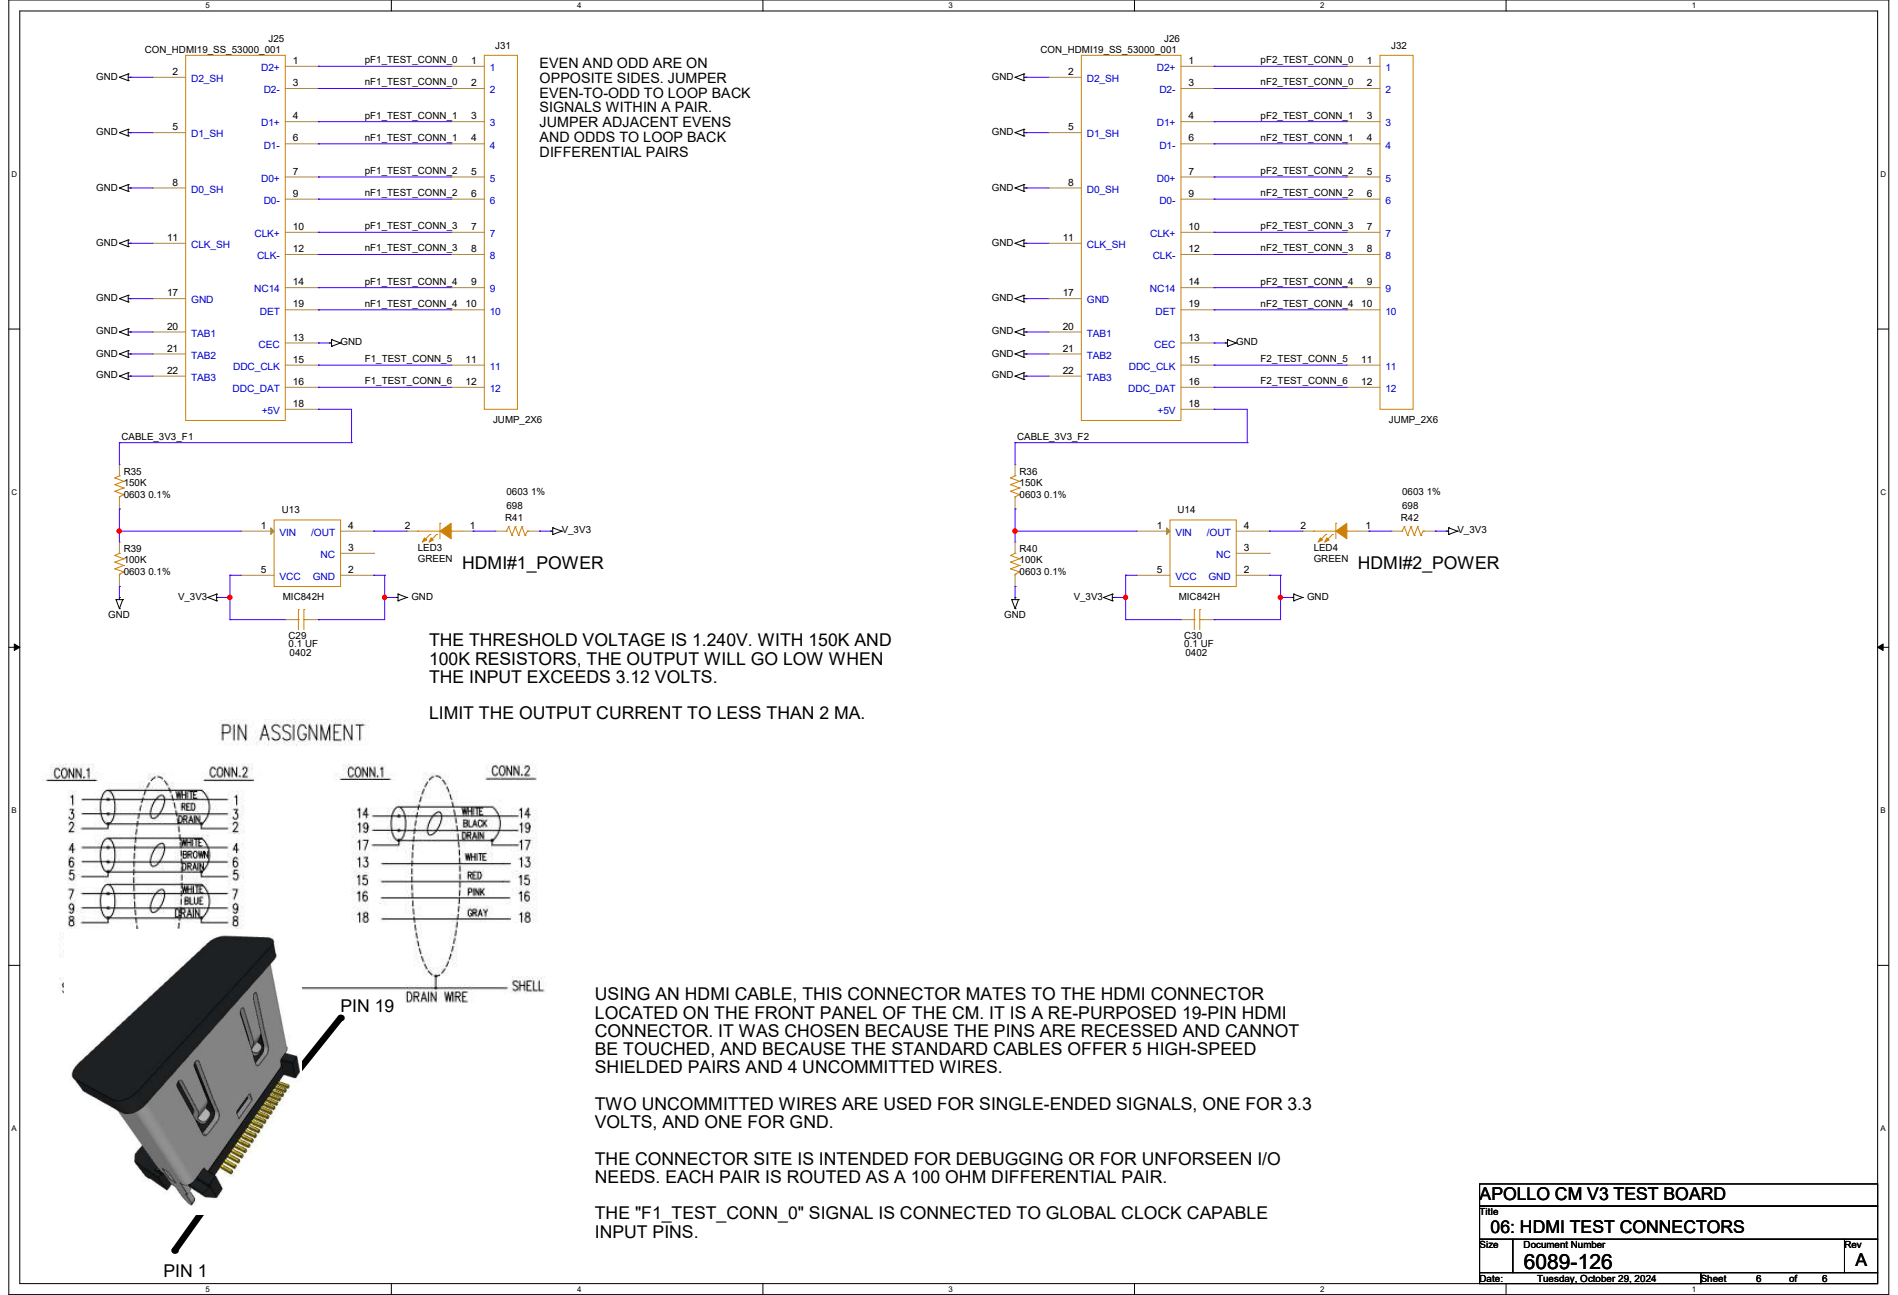
[picture p127: page 6]

EVEN-TO-ODD TO LOOP BACK
SIGNALS WITHIN A PAIR.
JUMPER ADJACENT EVENS
AND ODDS TO LOOP BACK
DIFFERENTIAL PAIRS

THE THRESHOLD VOLTAGE IS 1.240V. WITH 150K AND
100K RESISTORS, THE OUTPUT WILL GO LOW WHEN
THE INPUT EXCEEDS 3.12 VOLTS.
LIMIT THE OUTPUT CURRENT TO LESS THAN 2 MA.

USING AN HDMI CABLE, THIS CONNECTOR MATES TO THE HDMI CONNECTOR
LOCATED ON THE FRONT PANEL OF THE CM. IT IS A RE-PURPOSED 19-PIN HDMI
CONNECTOR. IT WAS CHOSEN BECAUSE THE PINS ARE RECESSED AND CANNOT
BE TOUCHED, AND BECAUSE THE STANDARD CABLES OFFER 5 HIGH-SPEED
SHIELDED PAIRS AND 4 UNCOMMITTED WIRES.
TWO UNCOMMITTED WIRES ARE USED FOR SINGLE-ENDED SIGNALS, ONE FOR 3.3
VOLTS, AND ONE FOR GND.
THE CONNECTOR SITE IS INTENDED FOR DEBUGGING OR FOR UNFORSEEN I/O
NEEDS. EACH PAIR IS ROUTED AS A 100 OHM DIFFERENTIAL PAIR.
THE "F1_TEST_CONN_0" SIGNAL IS CONNECTED TO GLOBAL CLOCK CAPABLE
INPUT PINS.

IN_HDMI_1 | OUT_HDMI_1

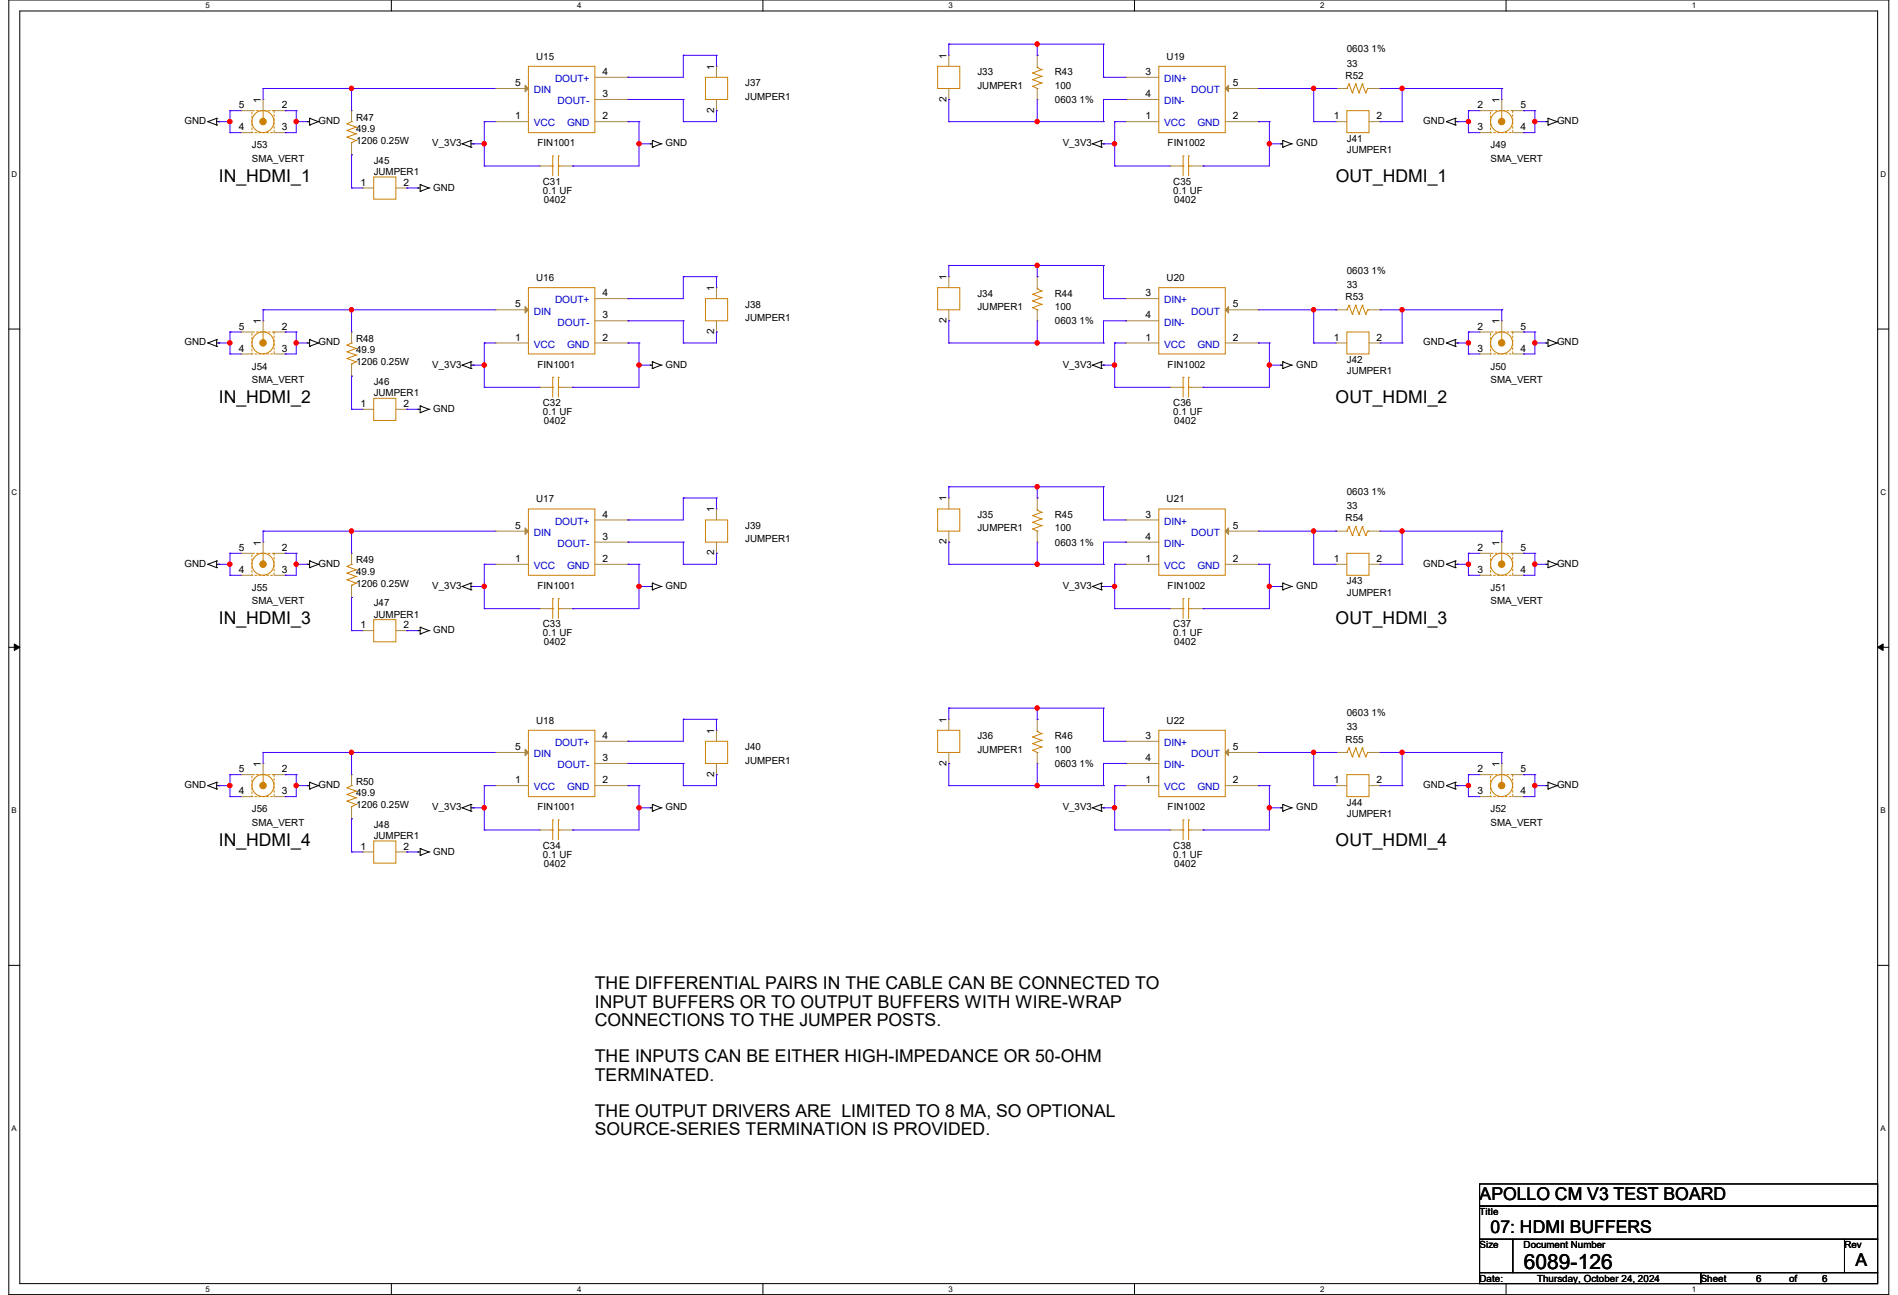
[picture p128: page 7]

THE DIFFERENTIAL PAIRS IN THE CABLE CAN BE CONNECTED TO
INPUT BUFFERS OR TO OUTPUT BUFFERS WITH WIRE-WRAP
CONNECTIONS TO THE JUMPER POSTS.
THE INPUTS CAN BE EITHER HIGH-IMPEDANCE OR 50-OHM
TERMINATED.
THE OUTPUT DRIVERS ARE LIMITED TO 8 MA, SO OPTIONAL
SOURCE-SERIES TERMINATION IS PROVIDED.
