apollo-lhc/Cornell_CM_Rev3_HW/Schematic/6089-127-RevA_23Jan2025.pdf

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
# THIS IS A FLAT SCHEMATIC, NOT A HIERARCHICAL ONE. NETS USE "OFFPAGE CONNECTOR" SYMBOLS TO GO FROM PAGE TO PAGE. ON ANY PAGE, THE NUMBER OF THE CONNECTING PAGE(S) IS SHOWN IN A SMALL NUMBER BELOW THE SIGNAL NAME. PAGE NUMBERS CAN BE FOUND IN SMALL TYPE AT THE

BOTTOM OF THE TITLE BLOCK.

THE SCHEMATIC IS DIVIDED INTO SECTIONS OF RELATED FUNCTIONALITY. THE SECTIONS ARE: 1: NOTES AND BLOCK DIAGRAMS 2: OFF-BOARD SIGNALS (SM AND FRONT PANEL), GLOBAL CLOCKING, C2C AND TCDS 3: POWER SOURCES AND CONTROLS 4: I2C CONTROLS 5: FPGA#1 POWER AND SIGNAL (NON-MGT) 6: FPGA#2 POWER AND SIGNAL (NON-MGT) 7: FPGA#1 GTY TRANSCEIVERS FOR FIREFLY 8: FPGA#2 GTY TRANSCEIVERS FOR FIREFLY 9: BETWEEN-FPGA GTY TRANSCEIVERS 9.99: MECHANICAL PARTS

# TO DO:

# These are some general signal naming conventions:

1) Signals connected to the FPGAs contain either "F1" or "F2".
2) Signals connected to the Service Module contain "SM".
3) Signals connected to the Front Panel contain "FP".
4) Signal names starting with “PG” are “Power Good” signals from power modules.
5) Signal names starting with “EN” are “Enable” signals to turn on power modules.
6) GTY reference clock names indicate FPGA followed by side (F1L, F1R, F2L, F2R), then the reference clock (R0 or R1), finishing with the sequence order (1 thru 7).
7) Power source names start with "V_", then the voltage with the letter "V" as a decimal point.

# (V_3V3 is a 3.3 volt source)

8) The MCU I/Os are 3.3 volt and the FPGA I/Os are 1.8 volt. Level shifters are used for the conversion. Signal names on the FPGA side are prefaced with "lov" (low voltage) and signals on the MCU side are prefaced with "hiv" (high voltage).

# Make JPG pictures for the block diagrams by displaying them in a PowerPoint slide show

that fills the screen. Do a "print screen", then paste it in "paint". Crop, save file, and insert picture.

# Consider making page numbers larger

# Update MCU code with new scale factor for 12V current reading

# Make design notes on the 5 synth pages match

# Update MCU code to accomodate reassigned pins on I2C register chips

Title Size | Document Number | Rev Date: | Sheet | of
6089-127 | A

# 1.01: NOTES

Thursday, January 23, 2025 | 1 | 82
APOLLO CM v3 Title Size | Document Number | Rev Date: | Sheet | of

# 1.01: NOTES

Thursday, January 23, 2025 | 1 | 82

# 1.01: NOTES

Thursday, January 23, 2025 | 1 | 82

# APOLLO CM v3

# 1.02: BLOCK DIAGRAM

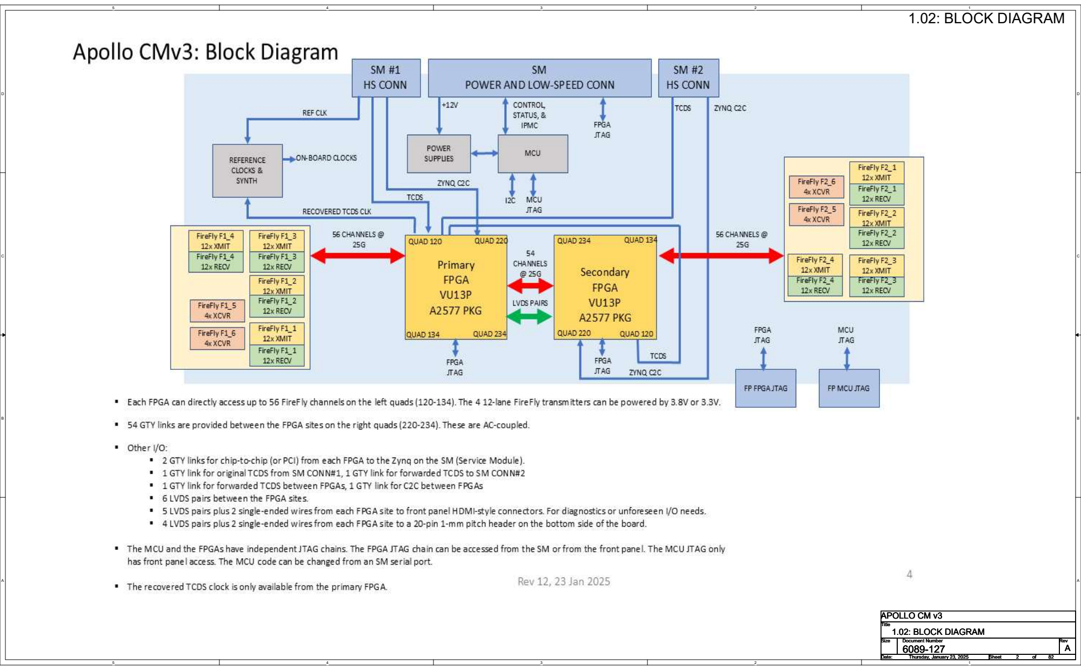
[picture p129: page 2]
Title Size; Document Number; Rev Date:; Sheet; 1.02: BLOCK DIAGRAM; Thursday, January 23, 2025; APOLLO CM v3 Title Size; APOLLO CM v3

# 1.03: GTY CONNECTIONS

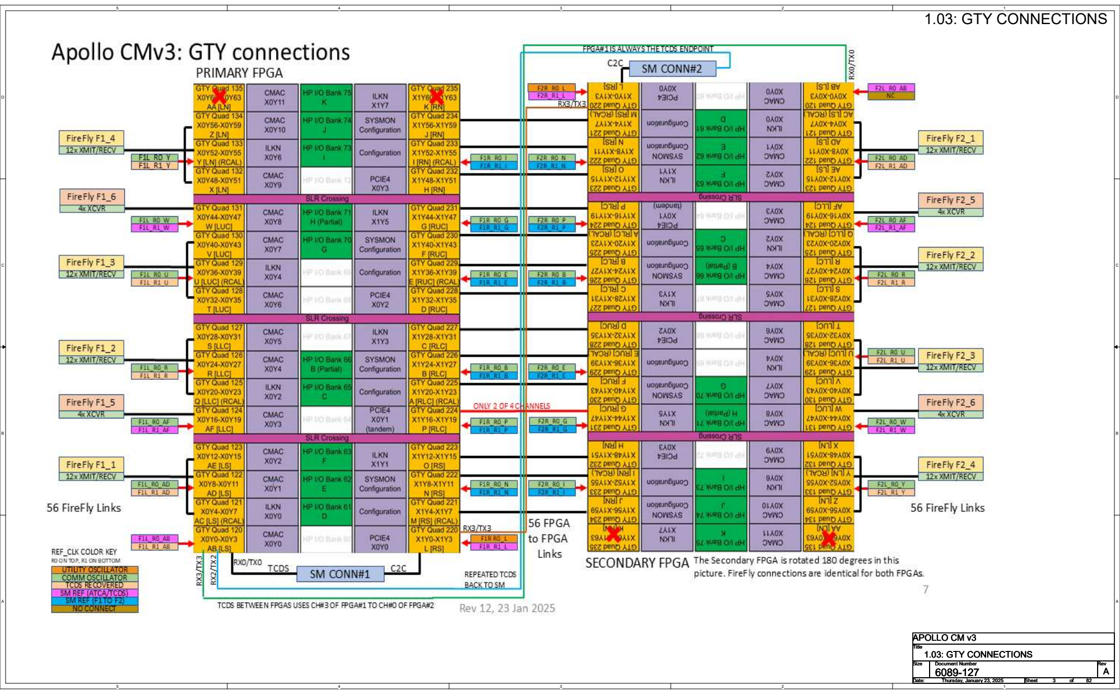
[picture p130: page 3]
Title Size; Document Number; Rev Date:; Sheet; 1.03: GTY CONNECTIONS; Thursday, January 23, 2025; APOLLO CM v3 Title Size; APOLLO CM v3

# 1.04: POWER

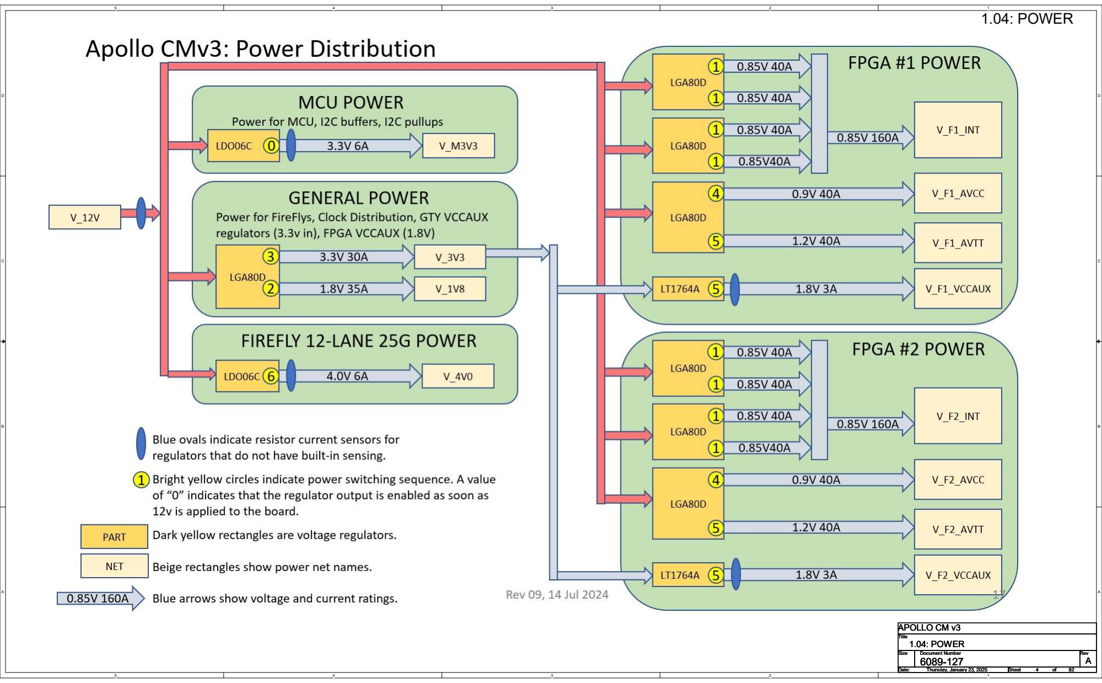
[picture p131: page 4]
Title Size; Document Number; Rev Date:; Sheet; 1.04: POWER; Thursday, January 23, 2025; APOLLO CM v3 Title Size; APOLLO CM v3

# 1.05: R0 SYNTH CLOCKS

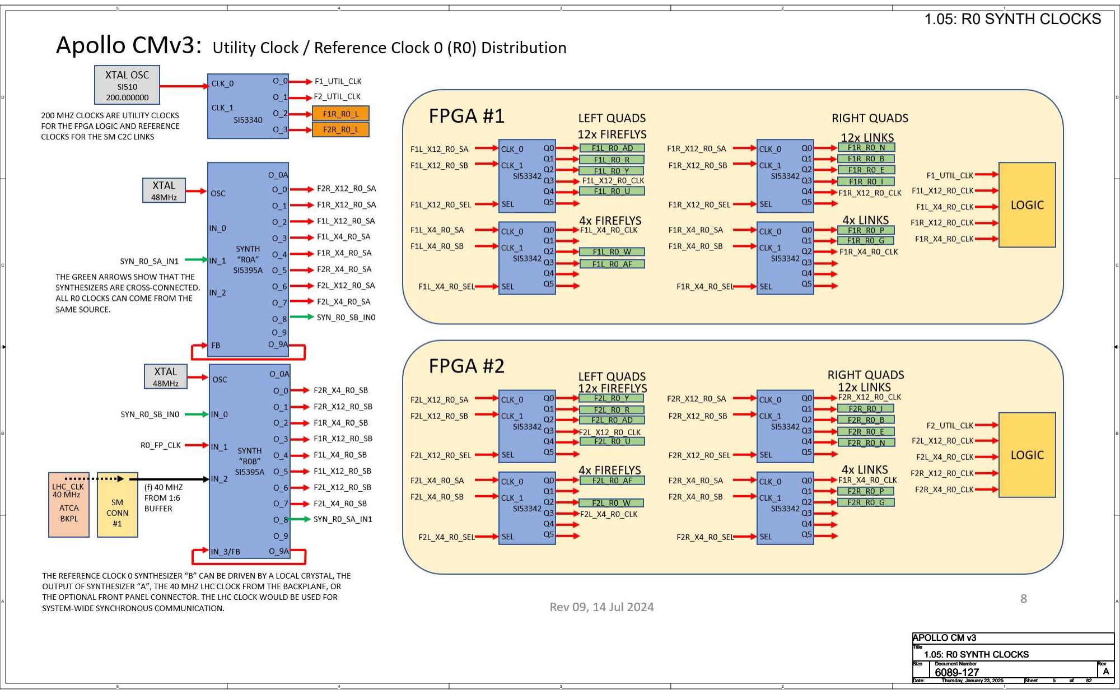
[picture p132: page 5]
Title Size; Document Number; Rev Date:; Sheet; 1.05: R0 SYNTH CLOCKS; Thursday, January 23, 2025; APOLLO CM v3 Title Size; APOLLO CM v3

# 1.06: R1 SYNTH CLOCKS

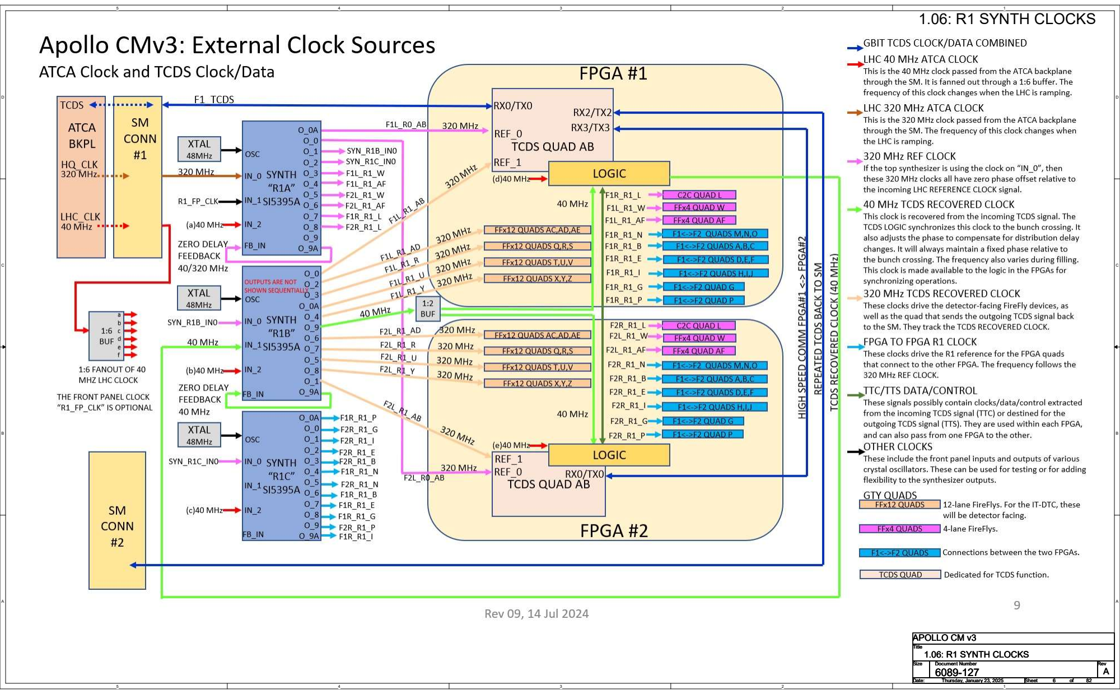
[picture p133: page 6]
Title Size; Document Number; Rev Date:; Sheet; 1.06: R1 SYNTH CLOCKS; Thursday, January 23, 2025; APOLLO CM v3 Title Size; APOLLO CM v3

# 1.07: TCDS FULL (SIMPLIFIED)

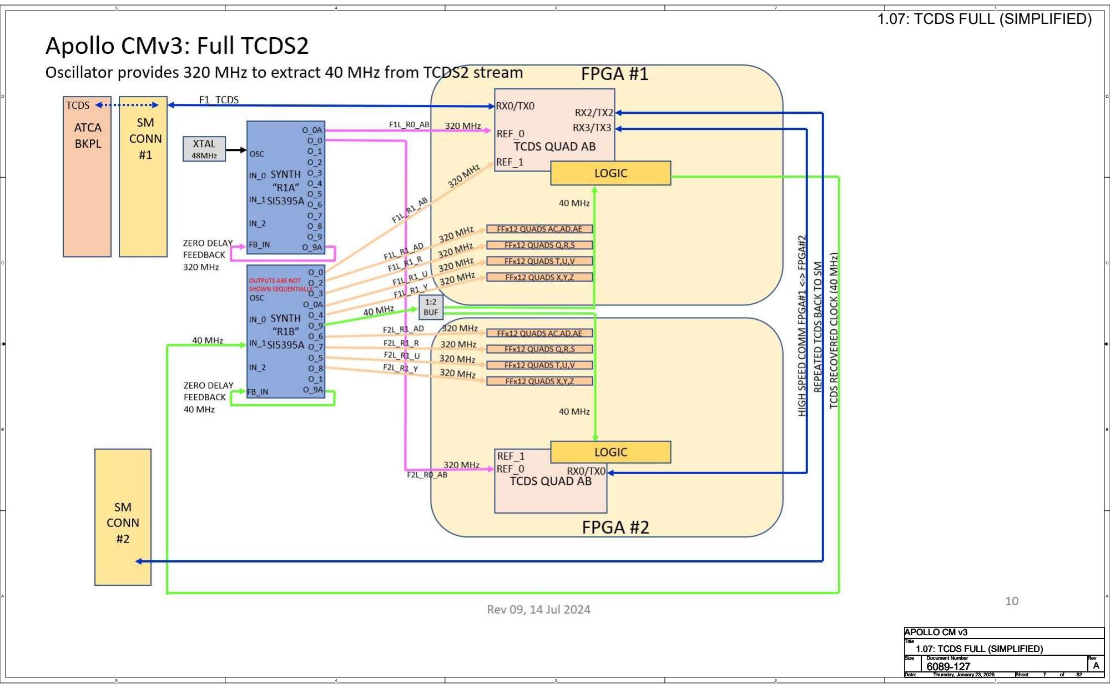
[picture p134: page 7]
Title Size; Document Number; Rev Date:; Sheet; Thursday, January 23, 2025; APOLLO CM v3 Title Size

1.07: TCDS FULL (SIMPLIFIED)

APOLLO CM v3

# 1.08: TCDS LIGHTWEIGHT-A (SIMPLIFIED)

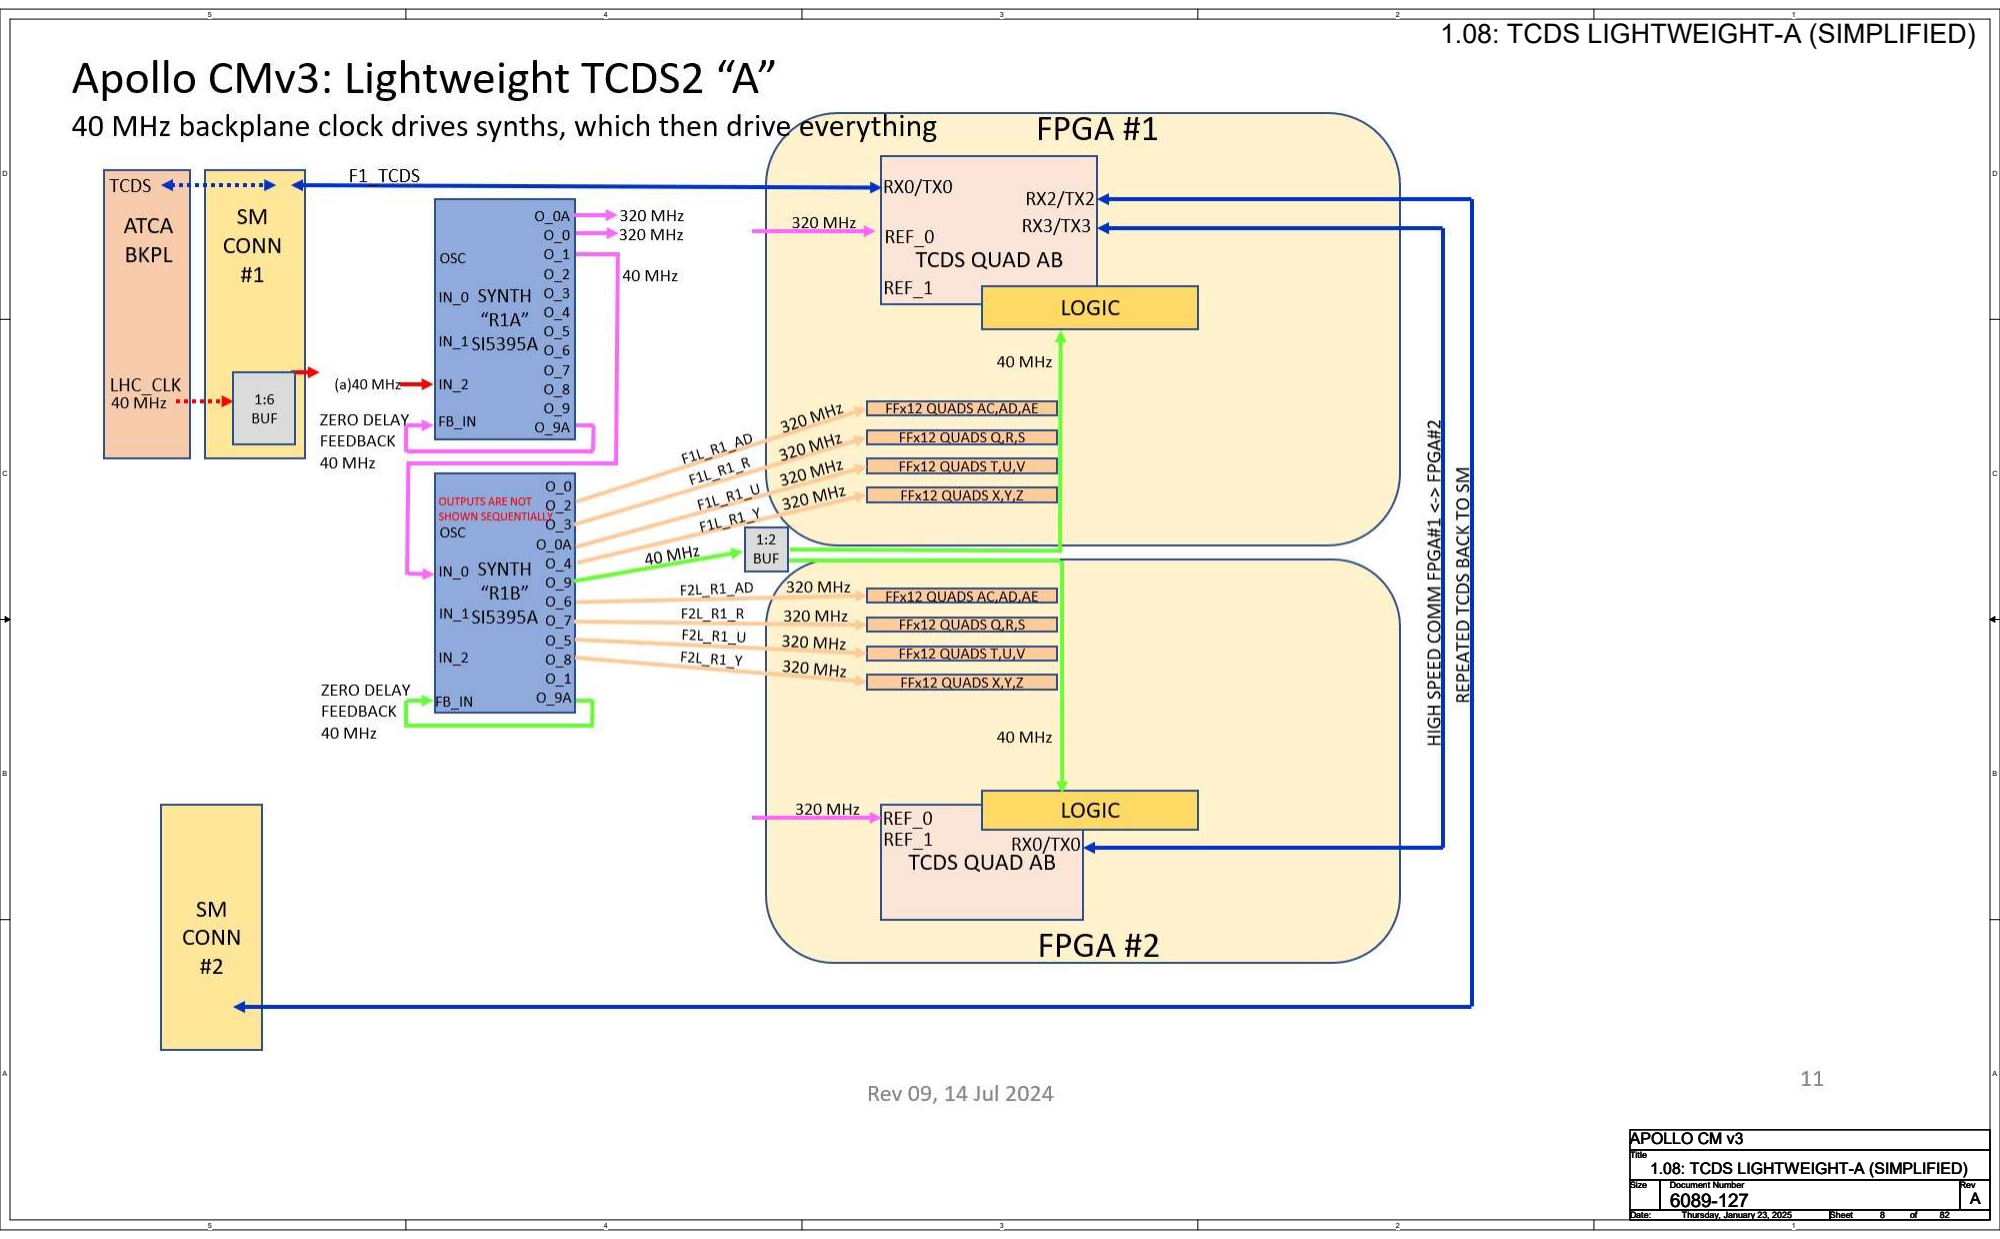
[picture p135: page 8]
Title Size; Document Number; Rev Date:; Sheet; Thursday, January 23, 2025; APOLLO CM v3 Title Size

1.08: TCDS LIGHTWEIGHT-A (SIMPLIFIED)

APOLLO CM v3

# 1.09: TCDS LIGHTWEIGHT-B (SIMPLIFIED)

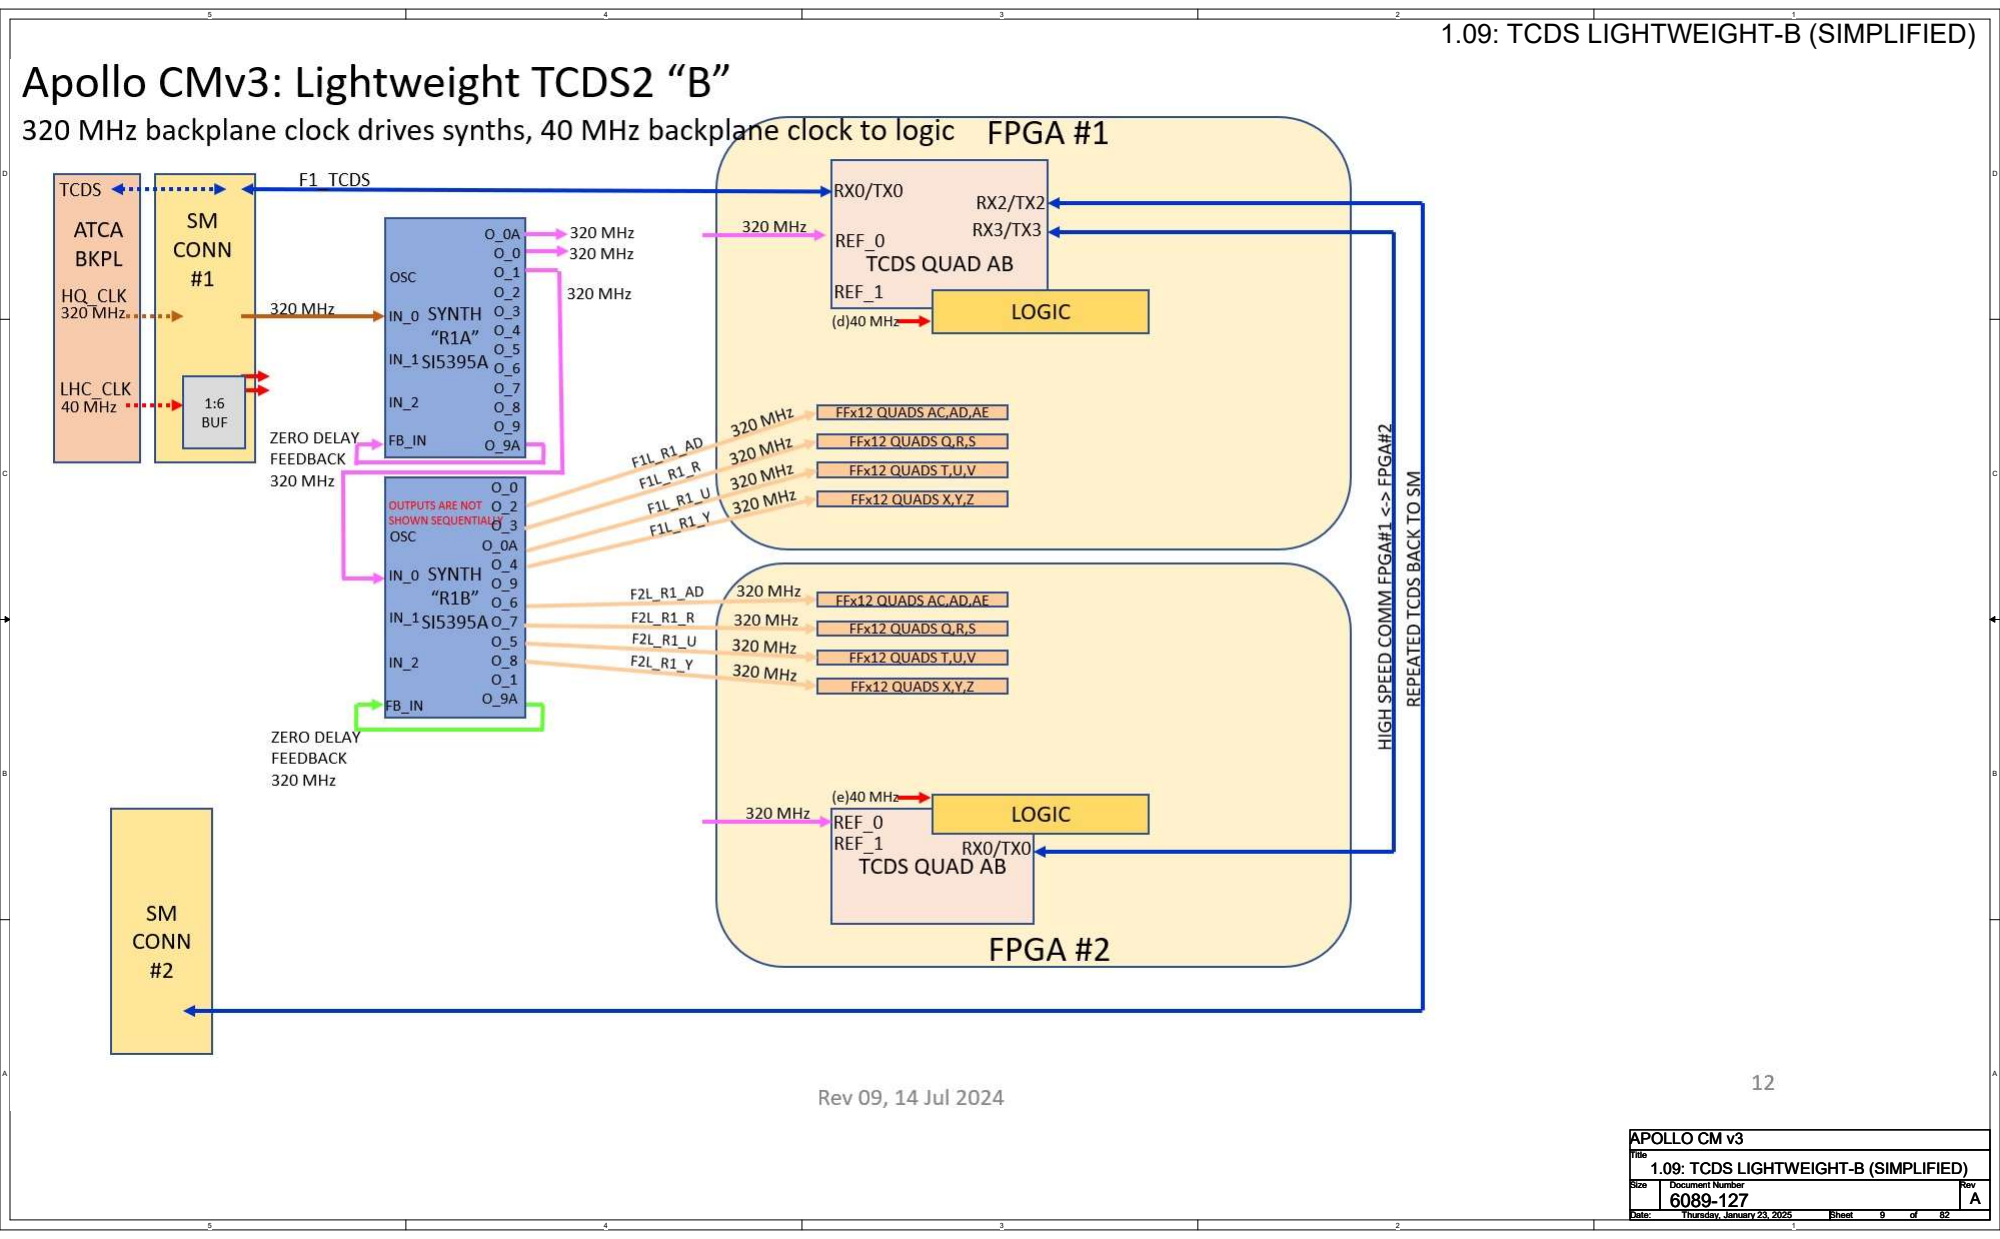
[picture p136: page 9]
Title Size; Document Number; Rev Date:; Sheet; Thursday, January 23, 2025; APOLLO CM v3 Title Size

1.09: TCDS LIGHTWEIGHT-B (SIMPLIFIED)

APOLLO CM v3

# 1.10: TCDS LIGHTWEIGHT-C (SIMPLIFIED)

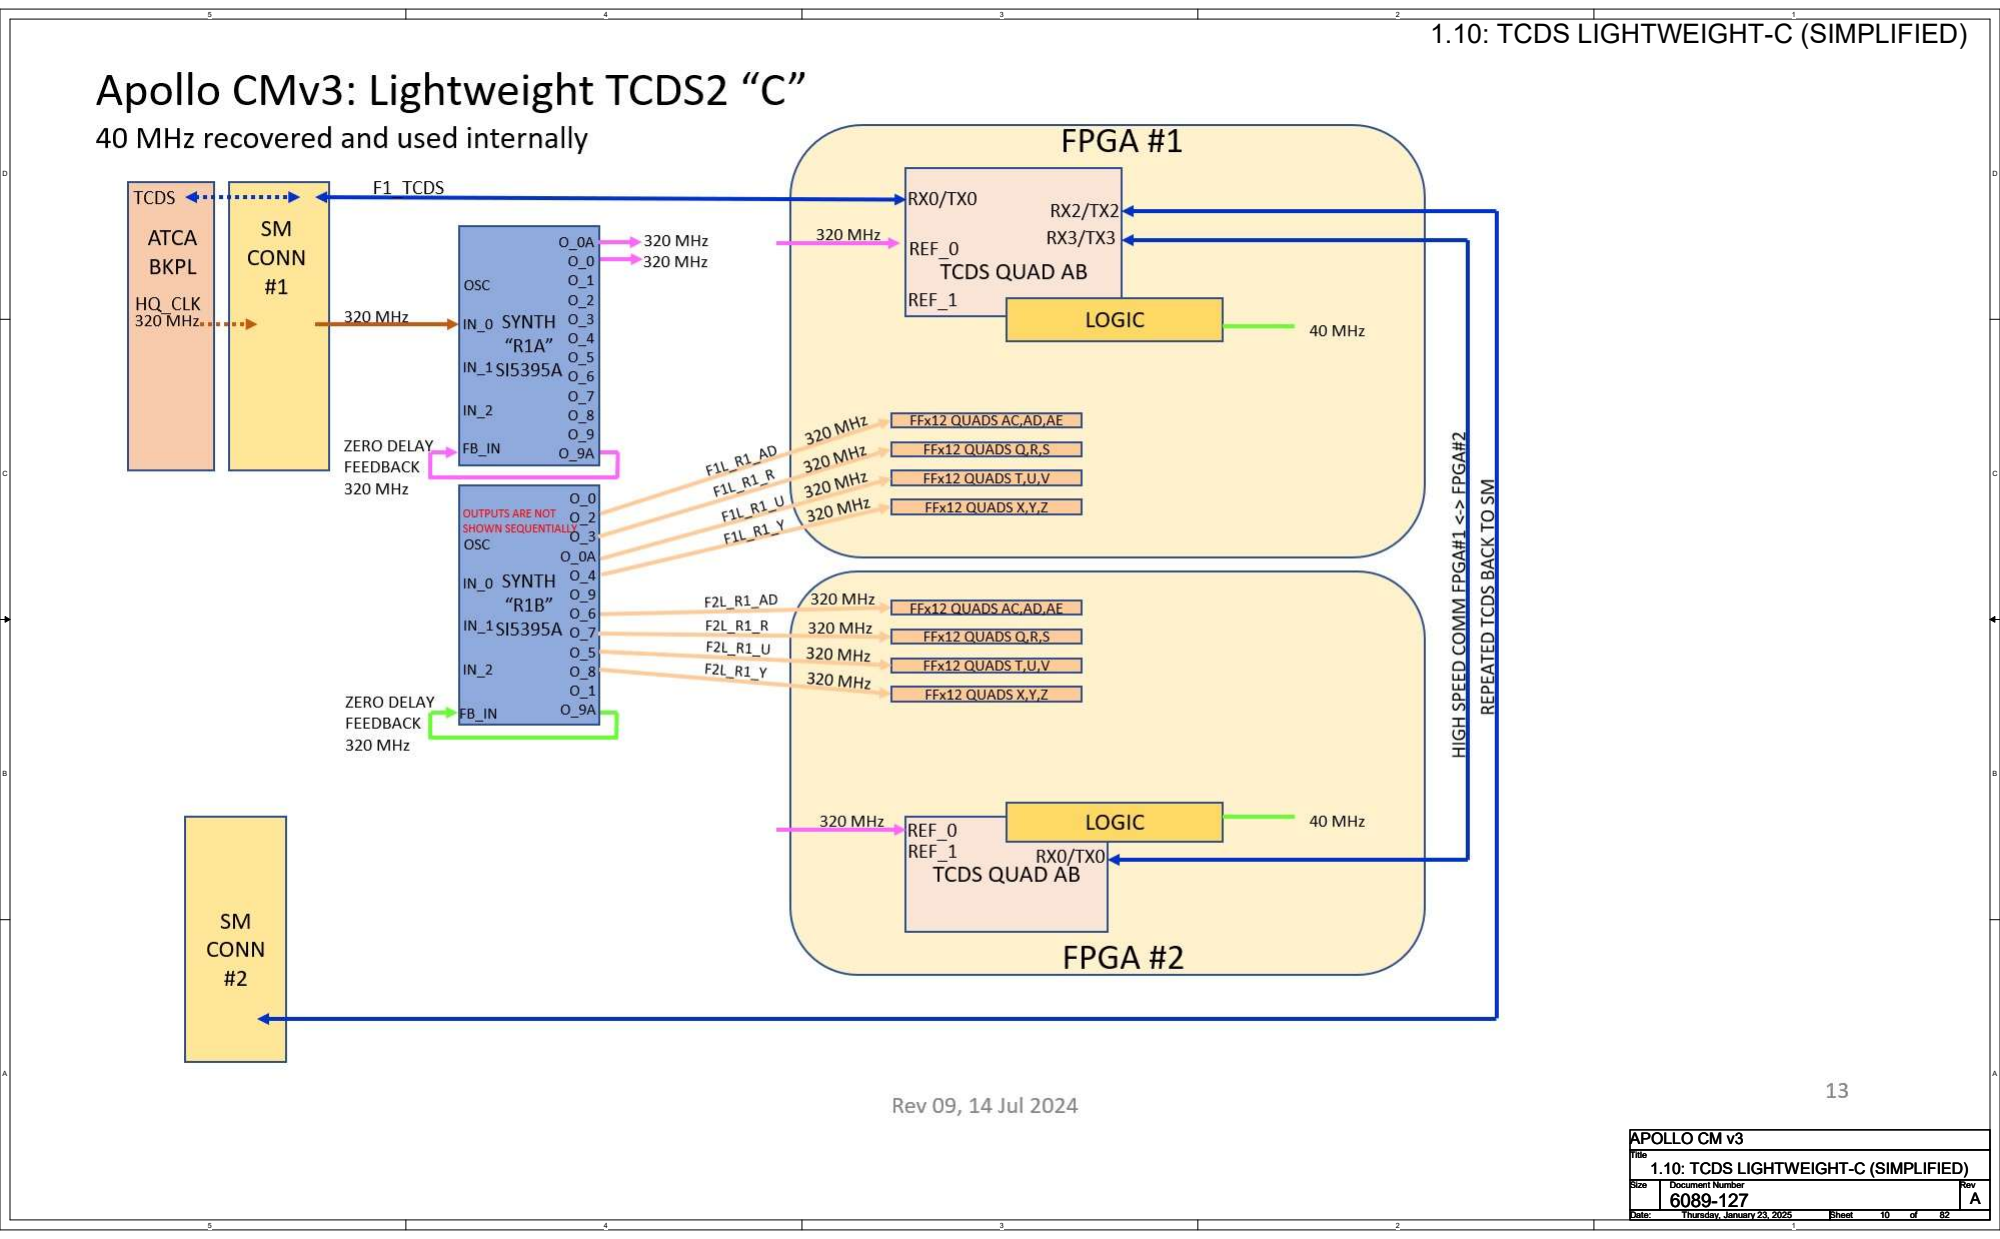
[picture p137: page 10]
Title Size; Document Number; Rev Date:; Sheet; Thursday, January 23, 2025; APOLLO CM v3 Title Size

1.10: TCDS LIGHTWEIGHT-C (SIMPLIFIED)

APOLLO CM v3

# 1.11: MCU I/O AND INTERNALS

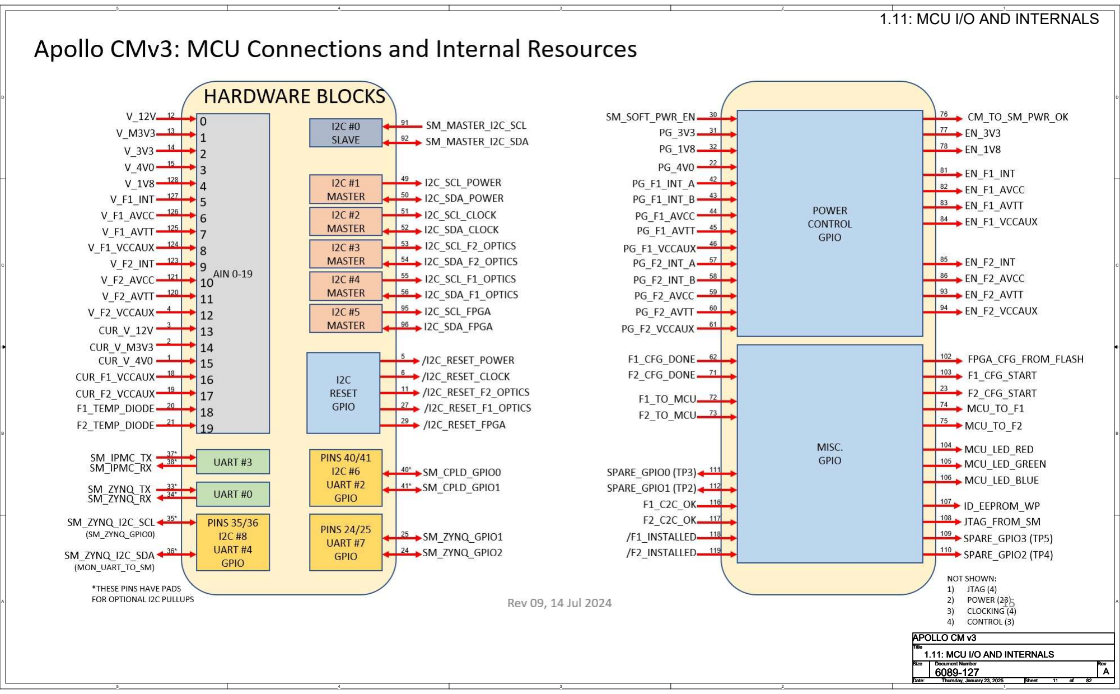
[picture p138: page 11]
Title Size; Document Number; Rev Date:; Sheet; Thursday, January 23, 2025; APOLLO CM v3 Title Size

1.11: MCU I/O AND INTERNALS

APOLLO CM v3

# 1.12: FIREFLY SITE USAGE

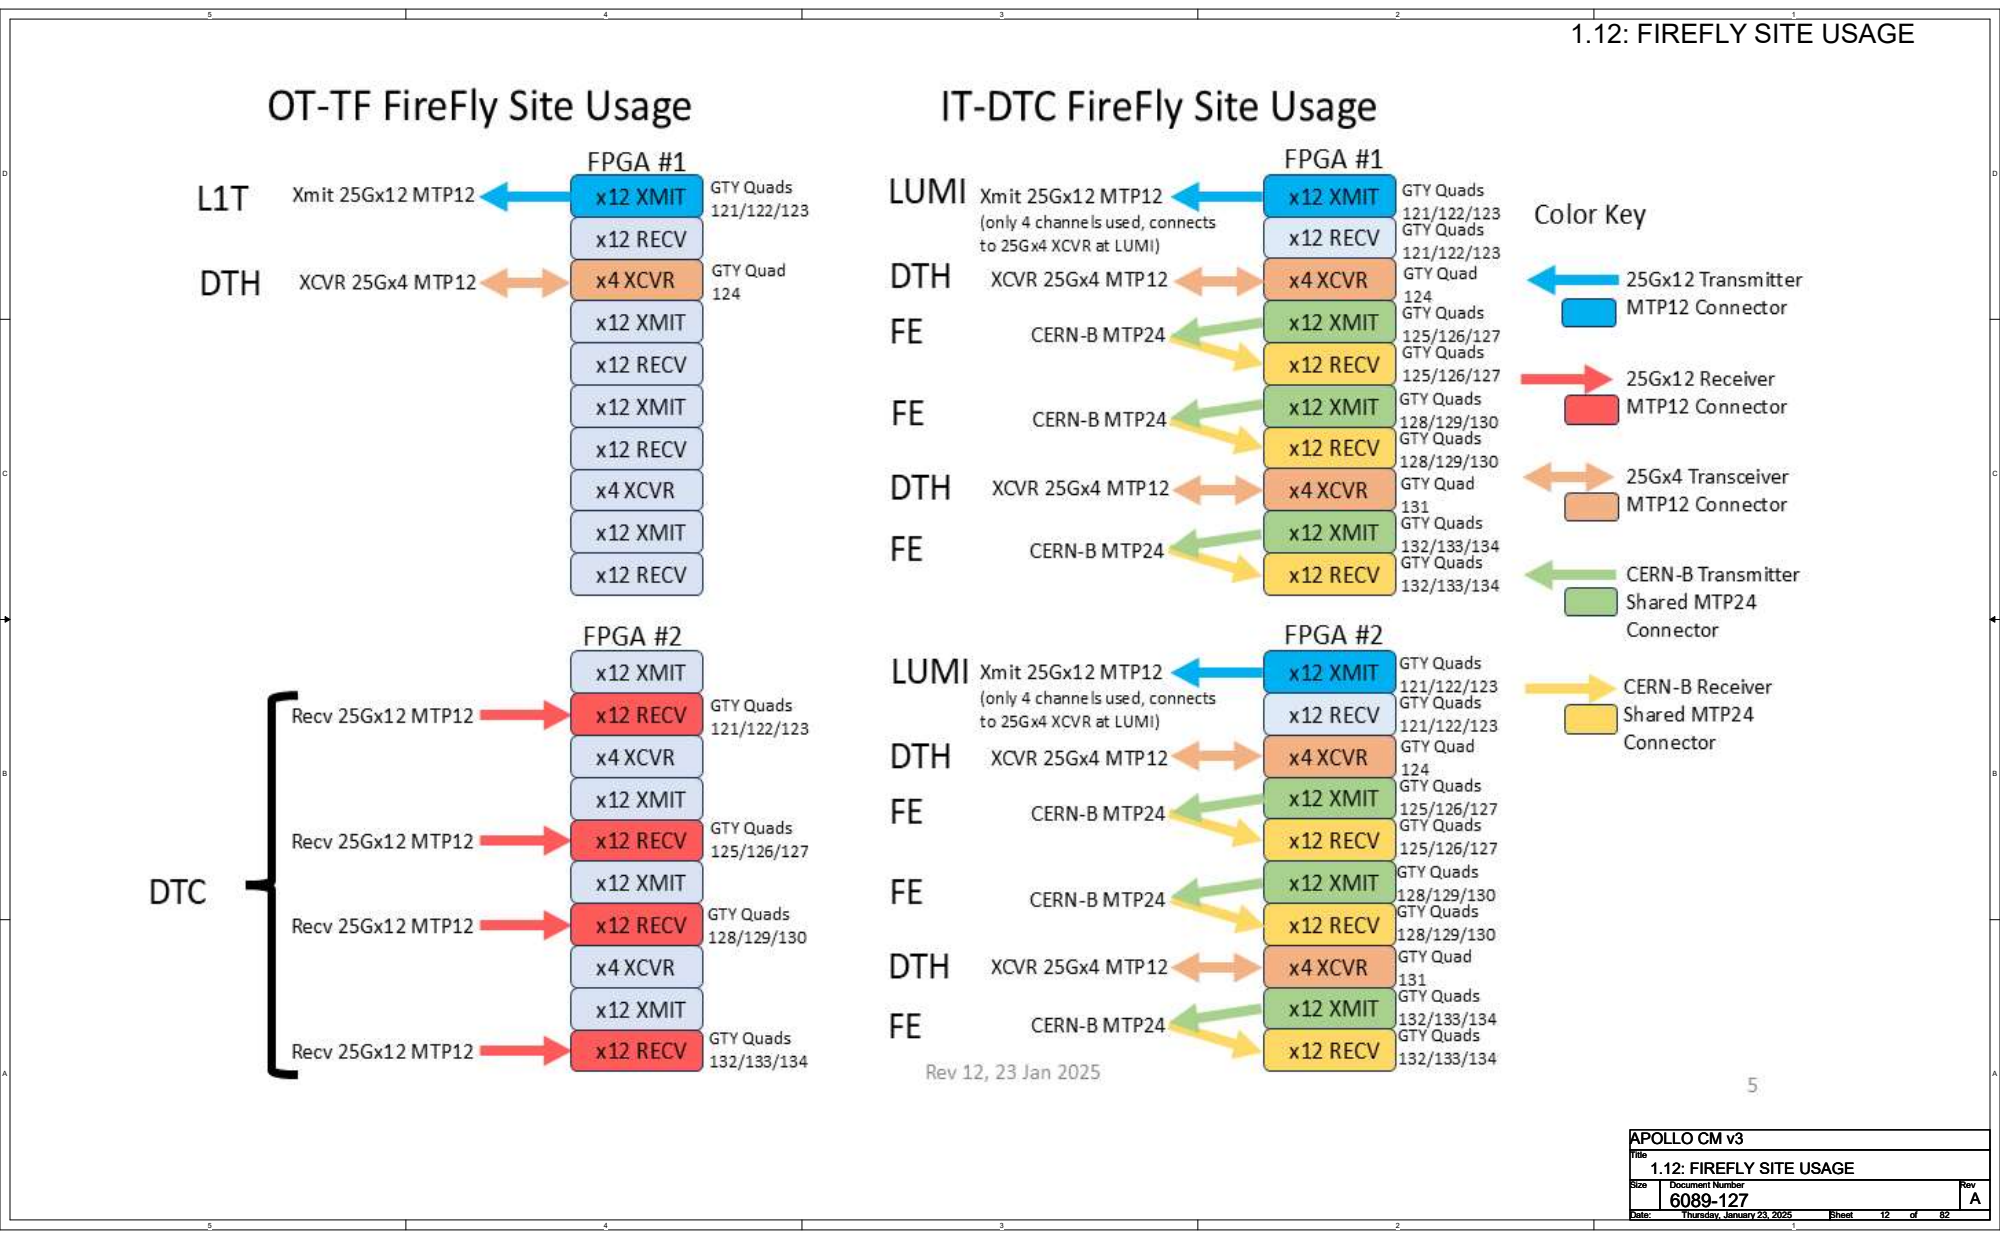
[picture p139: page 12]
Title Size; Document Number; Rev Date:; Sheet; Thursday, January 23, 2025; APOLLO CM v3 Title Size

1.12: FIREFLY SITE USAGE

APOLLO CM v3

# 2.01: SM POWER AND CONTROL CONNECTOR

## THE CURRENT SENSE RESISTOR IS A 4-WIRE DEVICE. A

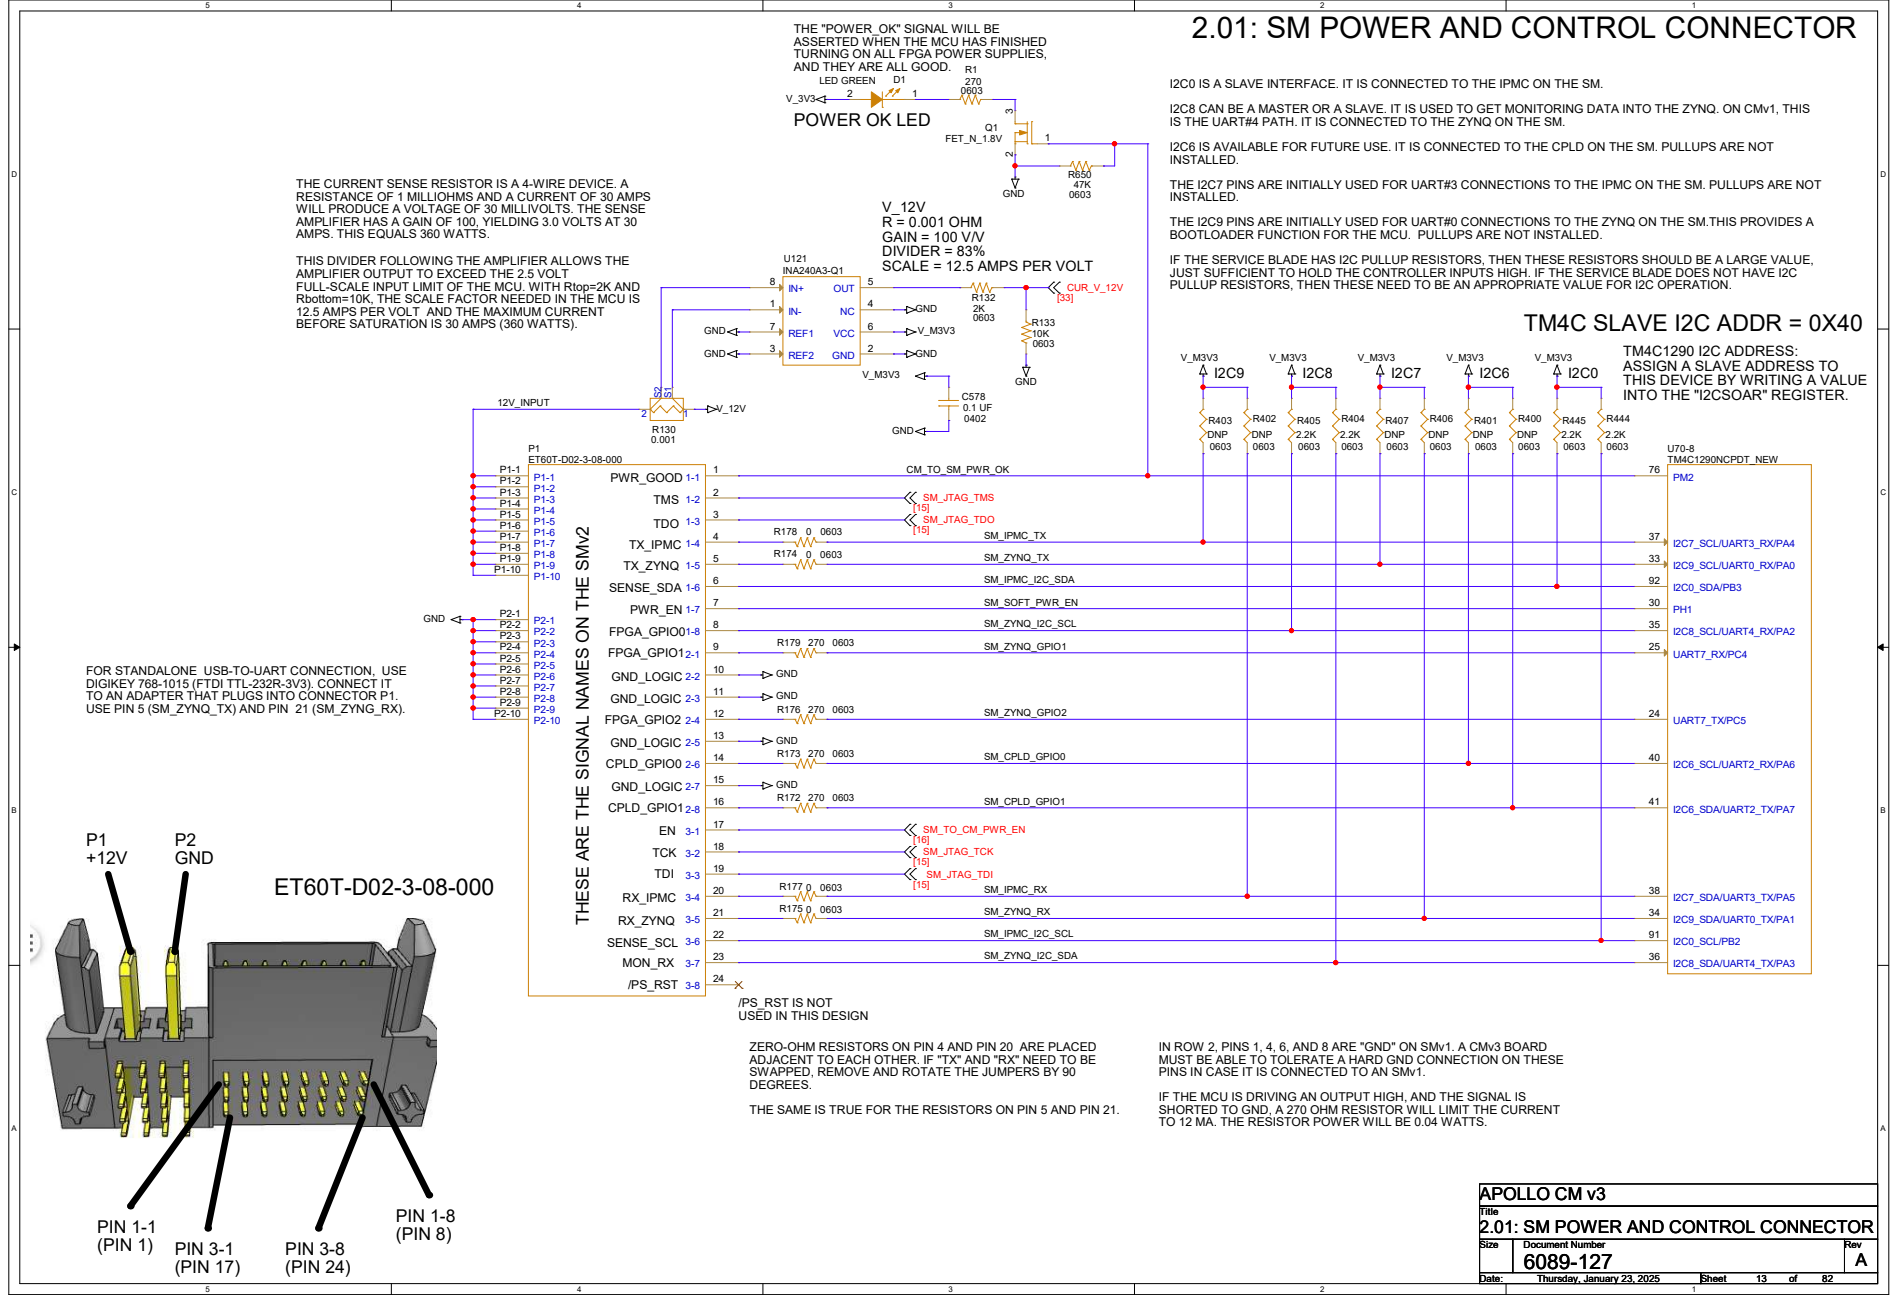
[picture p140: page 13]

THE "POWER_OK" SIGNAL WILL BE
ASSERTED WHEN THE MCU HAS FINISHED
TURNING ON ALL FPGA POWER SUPPLIES,
AND THEY ARE ALL GOOD.
POWER OK LED

I2C0 IS A SLAVE INTERFACE. IT IS CONNECTED TO THE IPMC ON THE SM.
I2C8 CAN BE A MASTER OR A SLAVE. IT IS USED TO GET MONITORING DATA INTO THE ZYNQ. ON CMv1, THIS
IS THE UART#4 PATH. IT IS CONNECTED TO THE ZYNQ ON THE SM.
I2C6 IS AVAILABLE FOR FUTURE USE. IT IS CONNECTED TO THE CPLD ON THE SM. PULLUPS ARE NOT
INSTALLED.
THE I2C7 PINS ARE INITIALLY USED FOR UART#3 CONNECTIONS TO THE IPMC ON THE SM. PULLUPS ARE NOT
THE I2C9 PINS ARE INITIALLY USED FOR UART#0 CONNECTIONS TO THE ZYNQ ON THE SM.THIS PROVIDES A
BOOTLOADER FUNCTION FOR THE MCU. PULLUPS ARE NOT INSTALLED.
IF THE SERVICE BLADE HAS I2C PULLUP RESISTORS, THEN THESE RESISTORS SHOULD BE A LARGE VALUE,
JUST SUFFICIENT TO HOLD THE CONTROLLER INPUTS HIGH. IF THE SERVICE BLADE DOES NOT HAVE I2C
PULLUP RESISTORS, THEN THESE NEED TO BE AN APPROPRIATE VALUE FOR I2C OPERATION.

RESISTANCE OF 1 MILLIOHMS AND A CURRENT OF 30 AMPS
WILL PRODUCE A VOLTAGE OF 30 MILLIVOLTS. THE SENSE
AMPLIFIER HAS A GAIN OF 100, YIELDING 3.0 VOLTS AT 30
AMPS. THIS EQUALS 360 WATTS.

THIS DIVIDER FOLLOWING THE AMPLIFIER ALLOWS THE
AMPLIFIER OUTPUT TO EXCEED THE 2.5 VOLT
FULL-SCALE INPUT LIMIT OF THE MCU. WITH Rtop=2K AND
Rbottom=10K, THE SCALE FACTOR NEEDED IN THE MCU IS
12.5 AMPS PER VOLT AND THE MAXIMUM CURRENT

TM4C1290 I2C ADDRESS:
ASSIGN A SLAVE ADDRESS TO
THIS DEVICE BY WRITING A VALUE
INTO THE "I2CSOAR" REGISTER.

FOR STANDALONE USB-TO-UART CONNECTION, USE
DIGIKEY 768-1015 (FTDI TTL-232R-3V3). CONNECT IT
TO AN ADAPTER THAT PLUGS INTO CONNECTOR P1.
USE PIN 5 (SM_ZYNQ_TX) AND PIN 21 (SM_ZYNG_RX).

/PS_RST IS NOT
USED IN THIS DESIGN

ZERO-OHM RESISTORS ON PIN 4 AND PIN 20 ARE PLACED
ADJACENT TO EACH OTHER. IF "TX" AND "RX" NEED TO BE
SWAPPED, REMOVE AND ROTATE THE JUMPERS BY 90
DEGREES.
THE SAME IS TRUE FOR THE RESISTORS ON PIN 5 AND PIN 21.

IN ROW 2, PINS 1, 4, 6, AND 8 ARE "GND" ON SMv1. A CMv3 BOARD
MUST BE ABLE TO TOLERATE A HARD GND CONNECTION ON THESE
PINS IN CASE IT IS CONNECTED TO AN SMv1.
IF THE MCU IS DRIVING AN OUTPUT HIGH, AND THE SIGNAL IS
SHORTED TO GND, A 270 OHM RESISTOR WILL LIMIT THE CURRENT

2.01: SM POWER AND CONTROL CONNECTOR

## TX1-P

## TX1-N

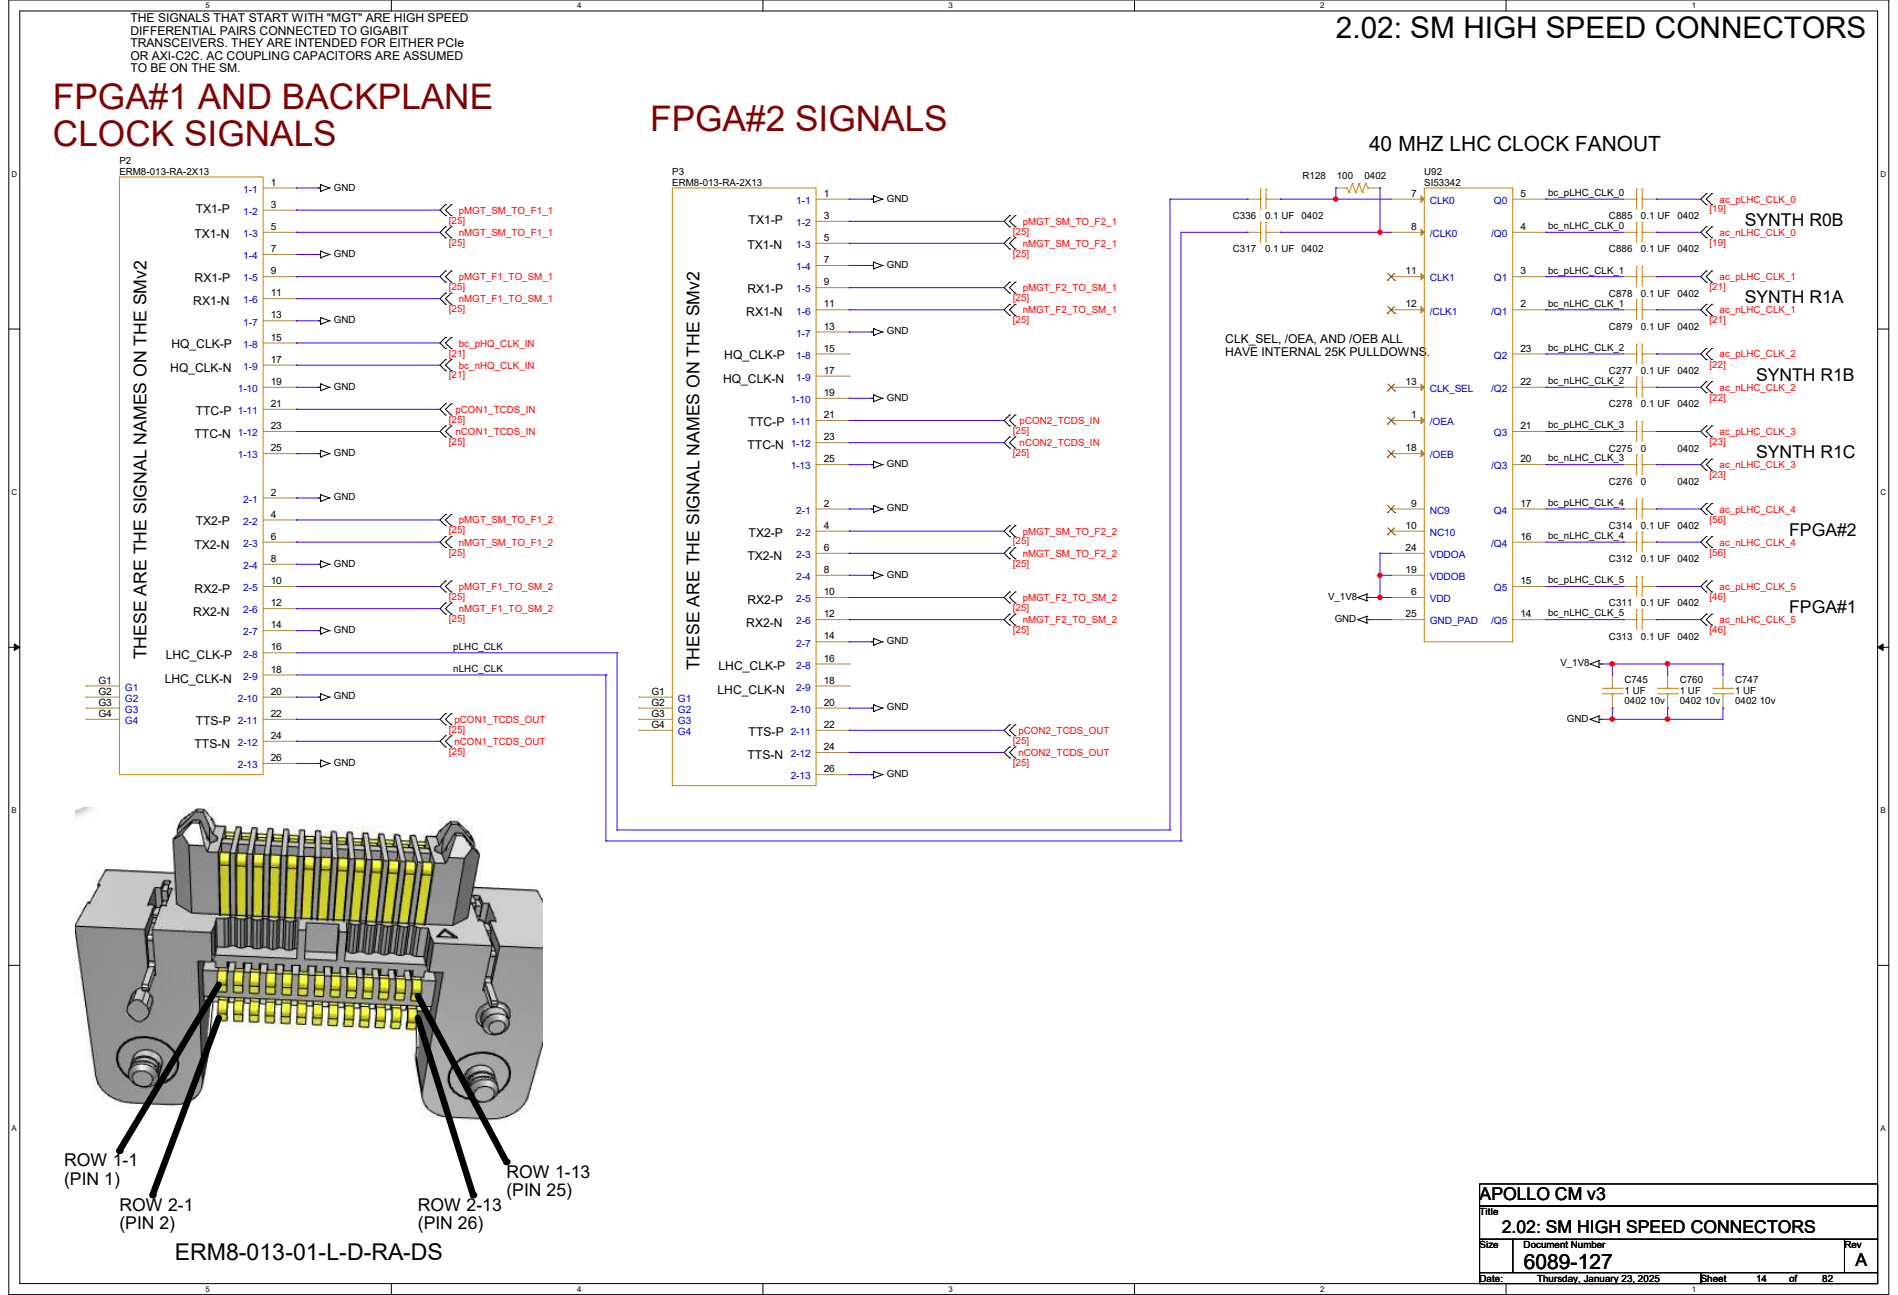
[picture p141: page 14]

THE SIGNALS THAT START WITH "MGT" ARE HIGH SPEED
DIFFERENTIAL PAIRS CONNECTED TO GIGABIT
TRANSCEIVERS. THEY ARE INTENDED FOR EITHER PCIe
OR AXI-C2C. AC COUPLING CAPACITORS ARE ASSUMED
TO BE ON THE SM.
FPGA#1 AND BACKPLANE

2.02: SM HIGH SPEED CONNECTORS

CLOCK SIGNALS THESE ARE THE SIGNAL NAMES ON THE SMv2

40 MHZ LHC CLOCK FANOUT

RX1-P THESE ARE THE SIGNAL NAMES ON THE SMv2

GND GND GND GND GND

GND GND GND GND

CLK_SEL, /OEA, AND /OEB ALL
HAVE INTERNAL 25K PULLDOWNS.

# FPGA#2 JTAG

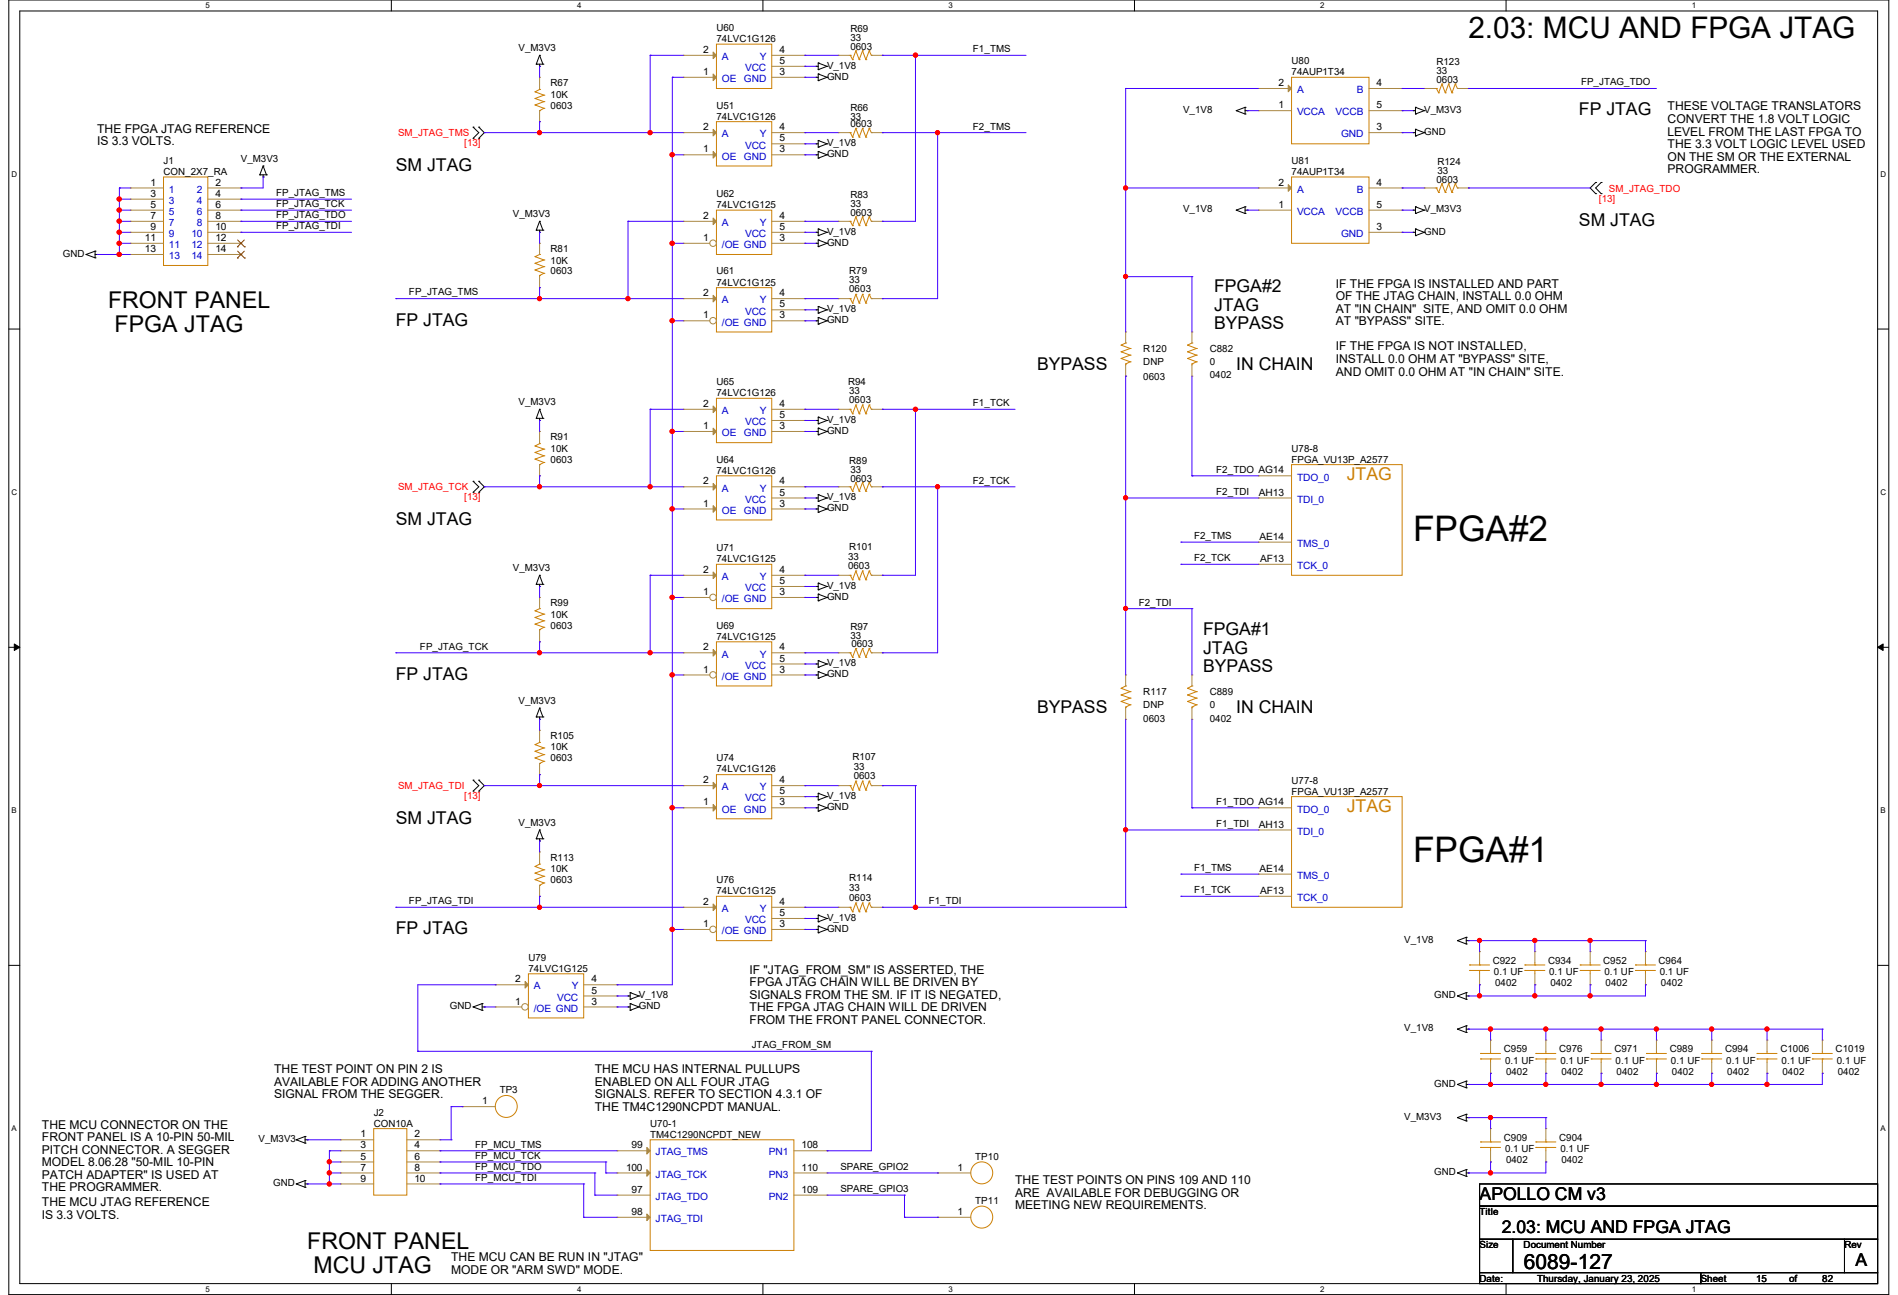
[picture p142: page 15]

2.03: MCU AND FPGA JTAG

THESE VOLTAGE TRANSLATORS
CONVERT THE 1.8 VOLT LOGIC
LEVEL FROM THE LAST FPGA TO
THE 3.3 VOLT LOGIC LEVEL USED
ON THE SM OR THE EXTERNAL
PROGRAMMER.

THE FPGA JTAG REFERENCE
IS 3.3 VOLTS.

IF THE FPGA IS INSTALLED AND PART
OF THE JTAG CHAIN, INSTALL 0.0 OHM
AT "IN CHAIN" SITE, AND OMIT 0.0 OHM
AT "BYPASS" SITE.
IF THE FPGA IS NOT INSTALLED,
INSTALL 0.0 OHM AT "BYPASS" SITE,

AND OMIT 0.0 OHM AT "IN CHAIN" SITE. BYPASS

IF "JTAG_FROM_SM" IS ASSERTED, THE
FPGA JTAG CHAIN WILL BE DRIVEN BY
SIGNALS FROM THE SM. IF IT IS NEGATED,
THE FPGA JTAG CHAIN WILL DE DRIVEN
FROM THE FRONT PANEL CONNECTOR.

THE TEST POINT ON PIN 2 IS
AVAILABLE FOR ADDING ANOTHER
SIGNAL FROM THE SEGGER.

THE MCU HAS INTERNAL PULLUPS
ENABLED ON ALL FOUR JTAG
SIGNALS. REFER TO SECTION 4.3.1 OF
THE TM4C1290NCPDT MANUAL.

THE MCU CONNECTOR ON THE
FRONT PANEL IS A 10-PIN 50-MIL
PITCH CONNECTOR. A SEGGER
MODEL 8.06.28 "50-MIL 10-PIN
PATCH ADAPTER" IS USED AT
THE PROGRAMMER.
THE MCU JTAG REFERENCE

THE TEST POINTS ON PINS 109 AND 110
ARE AVAILABLE FOR DEBUGGING OR
MEETING NEW REQUIREMENTS.

THE MCU CAN BE RUN IN "JTAG"
MODE OR "ARM SWD" MODE.

## AS PER TABLE 25.7 OF THE TM4C1290 MANUAL, THE UNUSED "/WAKE" PIN

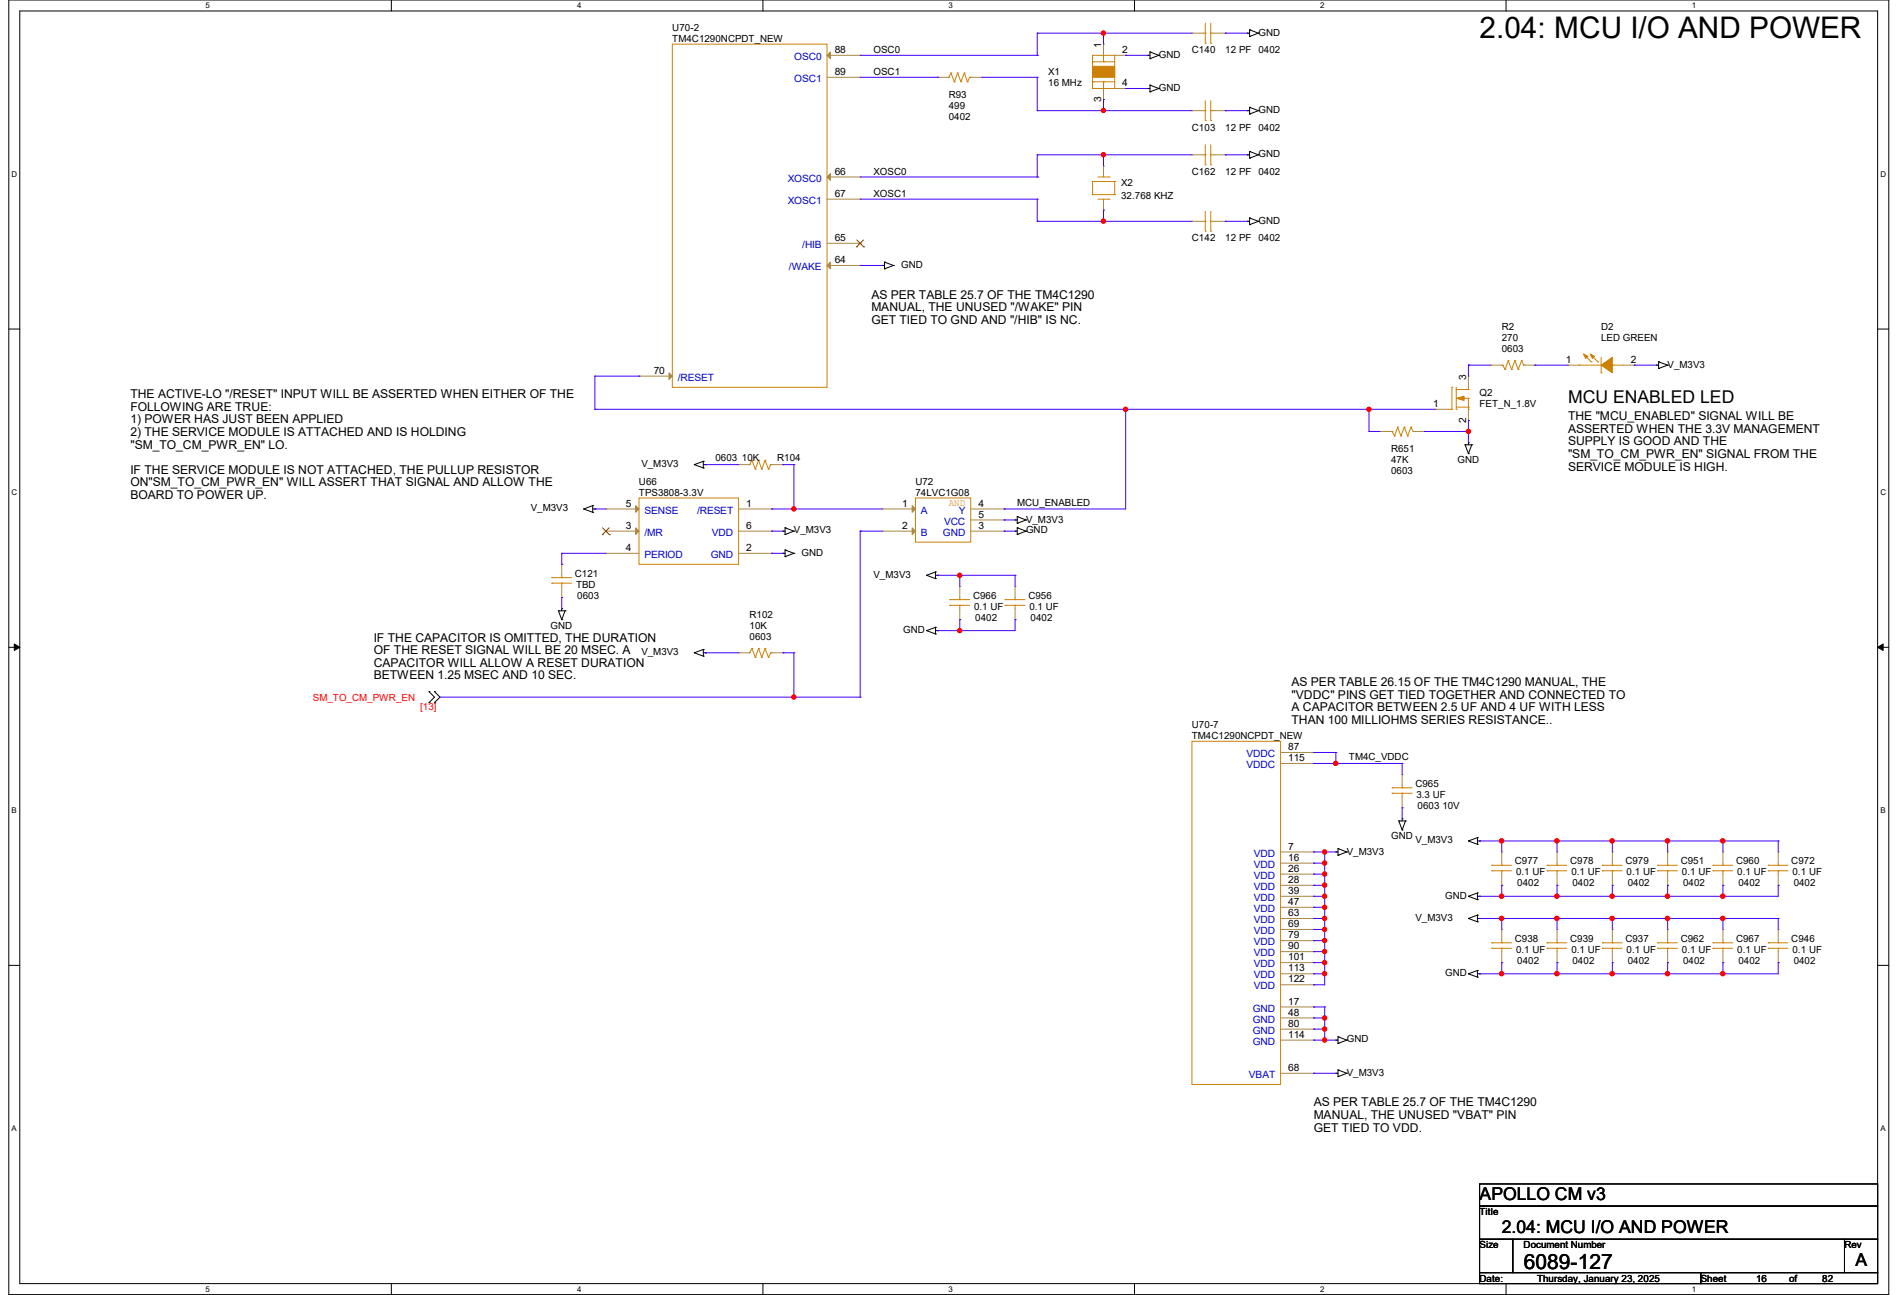
[picture p143: page 16]

GET TIED TO GND AND "/HIB" IS NC.

MCU ENABLED LED
THE "MCU_ENABLED" SIGNAL WILL BE
ASSERTED WHEN THE 3.3V MANAGEMENT
SUPPLY IS GOOD AND THE
"SM_TO_CM_PWR_EN" SIGNAL FROM THE
SERVICE MODULE IS HIGH.

THE ACTIVE-LO "/RESET" INPUT WILL BE ASSERTED WHEN EITHER OF THE
FOLLOWING ARE TRUE:
1) POWER HAS JUST BEEN APPLIED
2) THE SERVICE MODULE IS ATTACHED AND IS HOLDING
"SM_TO_CM_PWR_EN" LO.
IF THE SERVICE MODULE IS NOT ATTACHED, THE PULLUP RESISTOR
ON"SM_TO_CM_PWR_EN" WILL ASSERT THAT SIGNAL AND ALLOW THE
BOARD TO POWER UP.

IF THE CAPACITOR IS OMITTED, THE DURATION
OF THE RESET SIGNAL WILL BE 20 MSEC. A
CAPACITOR WILL ALLOW A RESET DURATION
BETWEEN 1.25 MSEC AND 10 SEC.

AS PER TABLE 26.15 OF THE TM4C1290 MANUAL, THE
"VDDC" PINS GET TIED TOGETHER AND CONNECTED TO
A CAPACITOR BETWEEN 2.5 UF AND 4 UF WITH LESS
THAN 100 MILLIOHMS SERIES RESISTANCE..

VDD 7 VDD 16 VDD 26 VDD 28 VDD 39 VDD 47 VDD 63 VDD 69

AS PER TABLE 25.7 OF THE TM4C1290
MANUAL, THE UNUSED "VBAT" PIN
GET TIED TO VDD.

## THIS OSCILLATOR HAS A STANDARD VALUE OF

200.0000 MHZ AND AN LVDS OUTPUT.

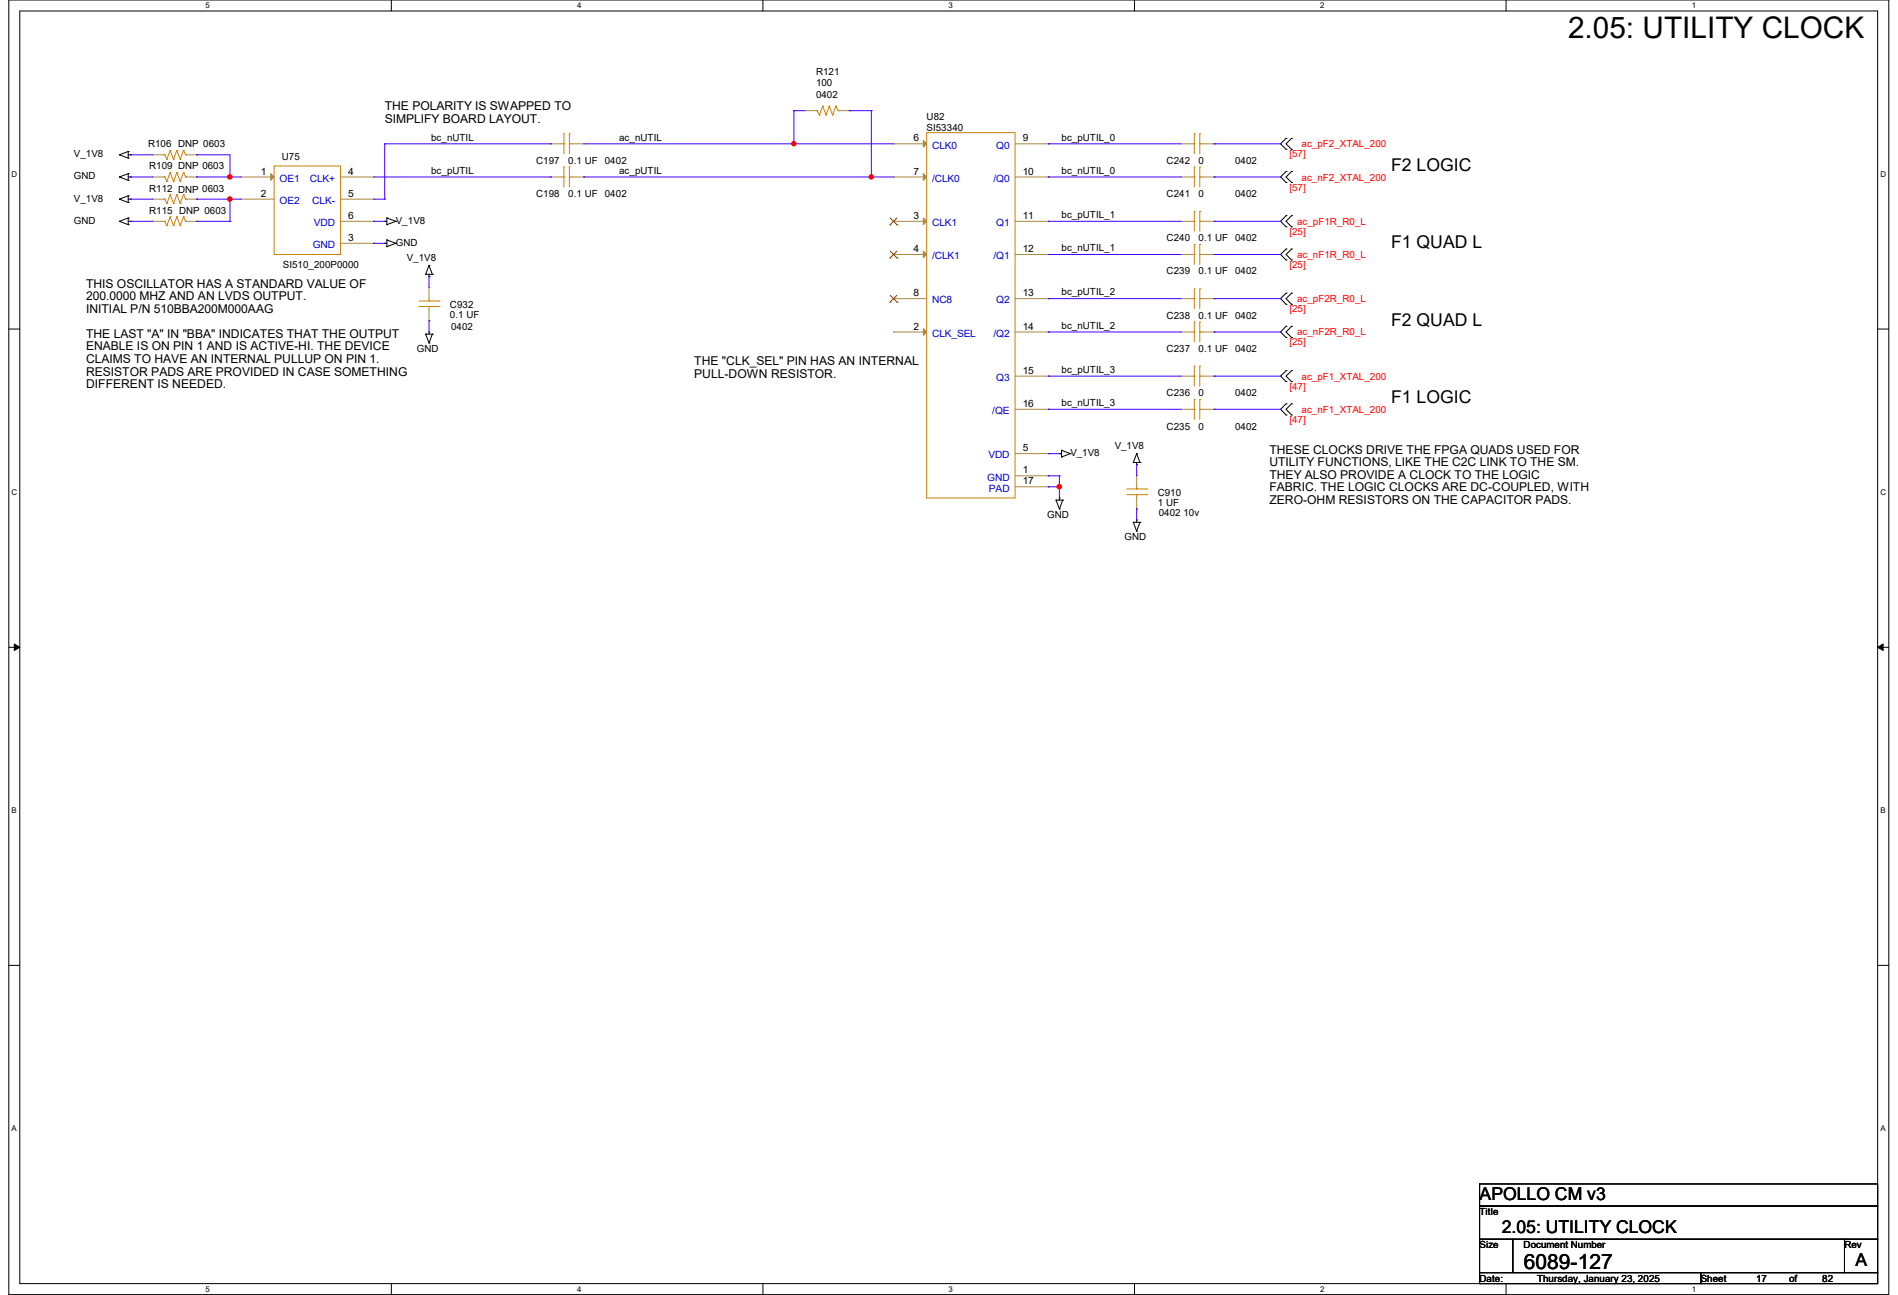
[picture p144: page 17]

THE POLARITY IS SWAPPED TO
SIMPLIFY BOARD LAYOUT.

INITIAL P/N 510BBA200M000AAG
THE LAST "A" IN "BBA" INDICATES THAT THE OUTPUT
ENABLE IS ON PIN 1 AND IS ACTIVE-HI. THE DEVICE
CLAIMS TO HAVE AN INTERNAL PULLUP ON PIN 1.
RESISTOR PADS ARE PROVIDED IN CASE SOMETHING
DIFFERENT IS NEEDED.

bc_nUTIL_2
/QE 16 VDD 5 GND 1 PAD 17

THE "CLK_SEL" PIN HAS AN INTERNAL
PULL-DOWN RESISTOR.

THESE CLOCKS DRIVE THE FPGA QUADS USED FOR
UTILITY FUNCTIONS, LIKE THE C2C LINK TO THE SM.
THEY ALSO PROVIDE A CLOCK TO THE LOGIC
FABRIC. THE LOGIC CLOCKS ARE DC-COUPLED, WITH
ZERO-OHM RESISTORS ON THE CAPACITOR PADS.

# 2.06: REFCLK SYNTHESIZER R0A

# F1 R0 RIGHT QUADS

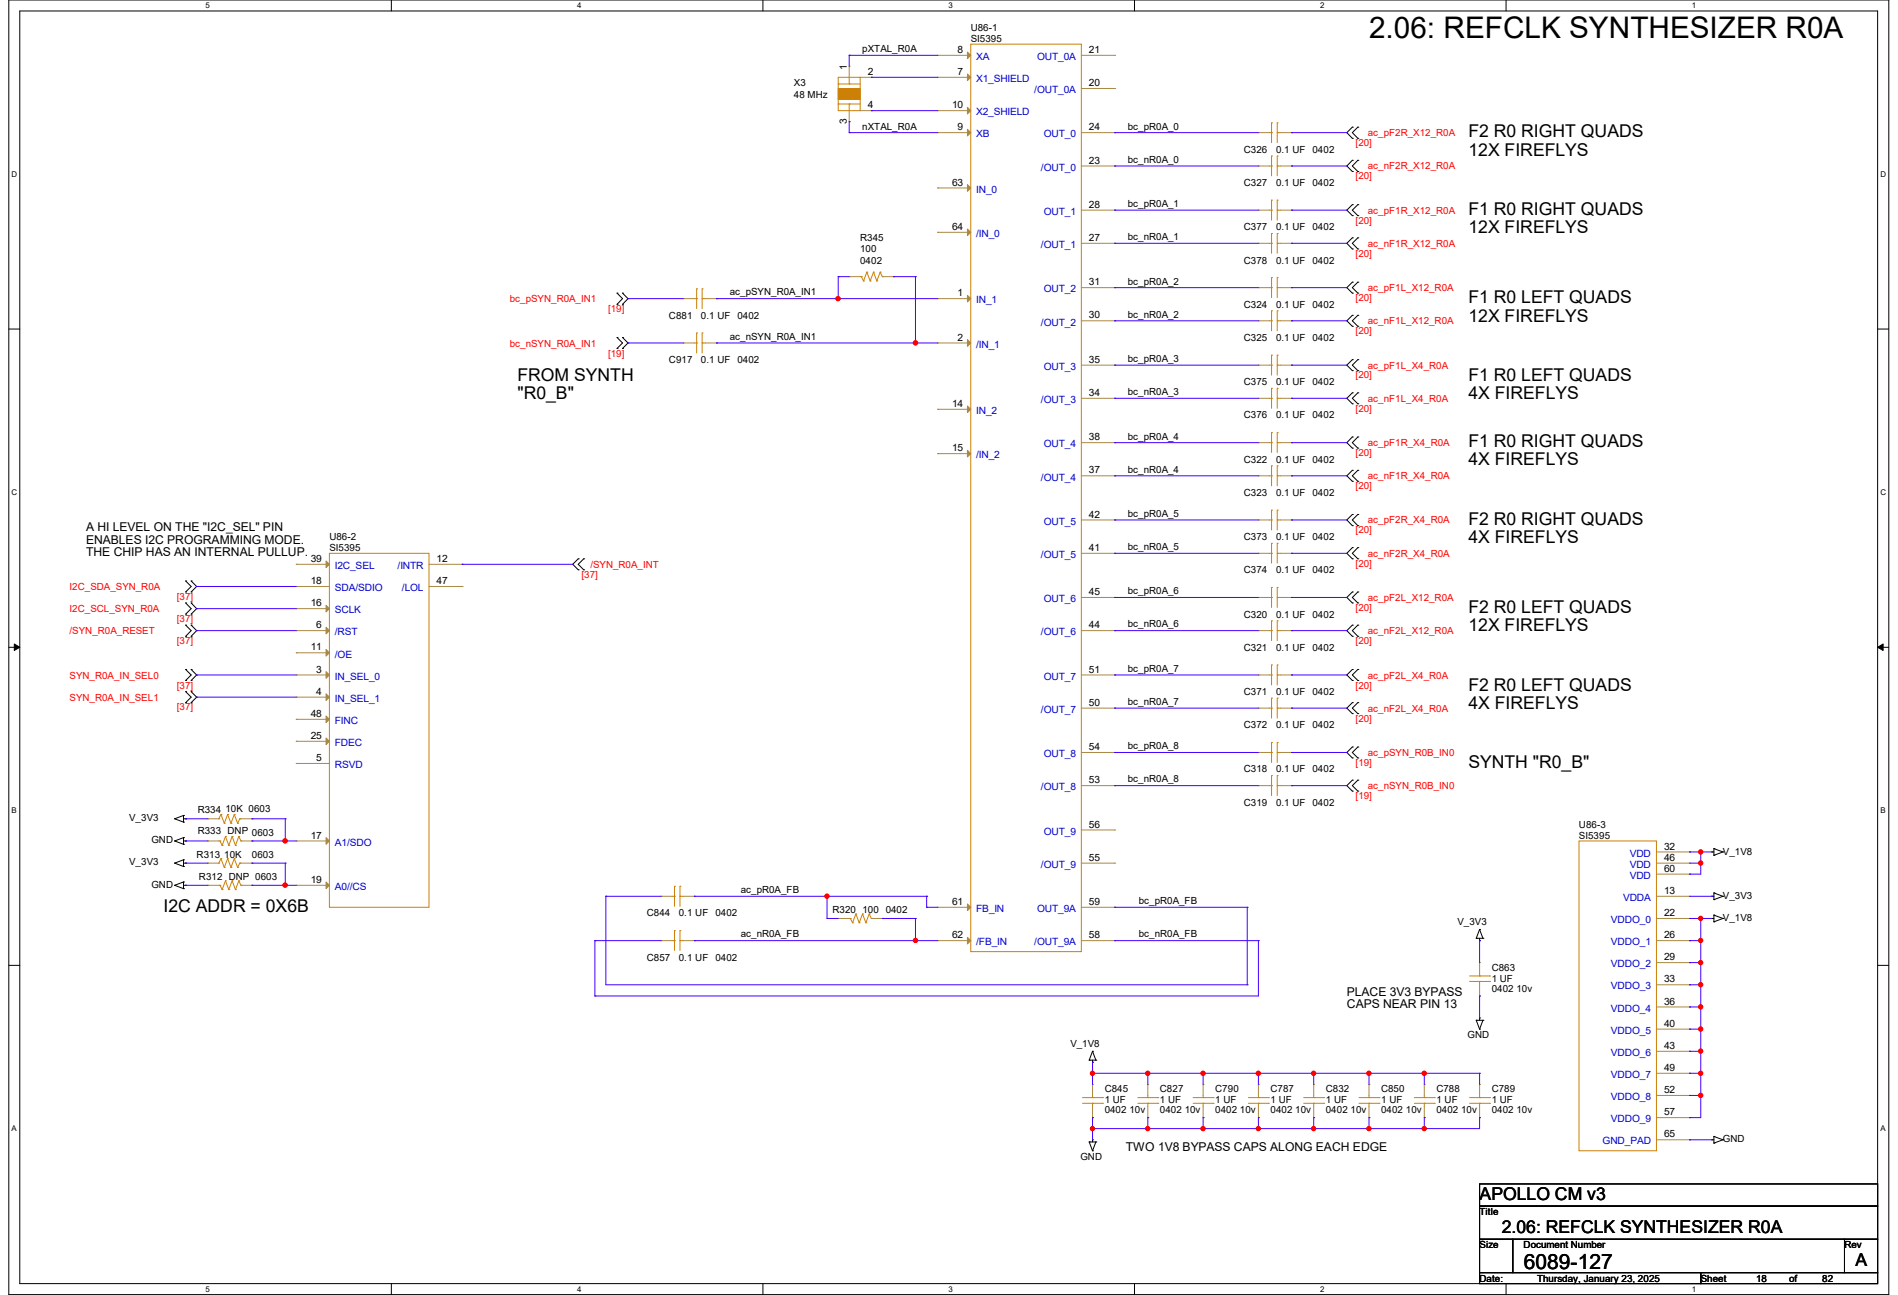
[picture p145: page 18]

A HI LEVEL ON THE "I2C_SEL" PIN
ENABLES I2C PROGRAMMING MODE.
THE CHIP HAS AN INTERNAL PULLUP.

TWO 1V8 BYPASS CAPS ALONG EACH EDGE

## THE REFERENCE CLOCK 0 SYNTHESIZER “B” CAN BE DRIVEN BY A LOCAL CRYSTAL, THE OUTPUT OF SYNTHESIZER “A”, THE 40 MHZ

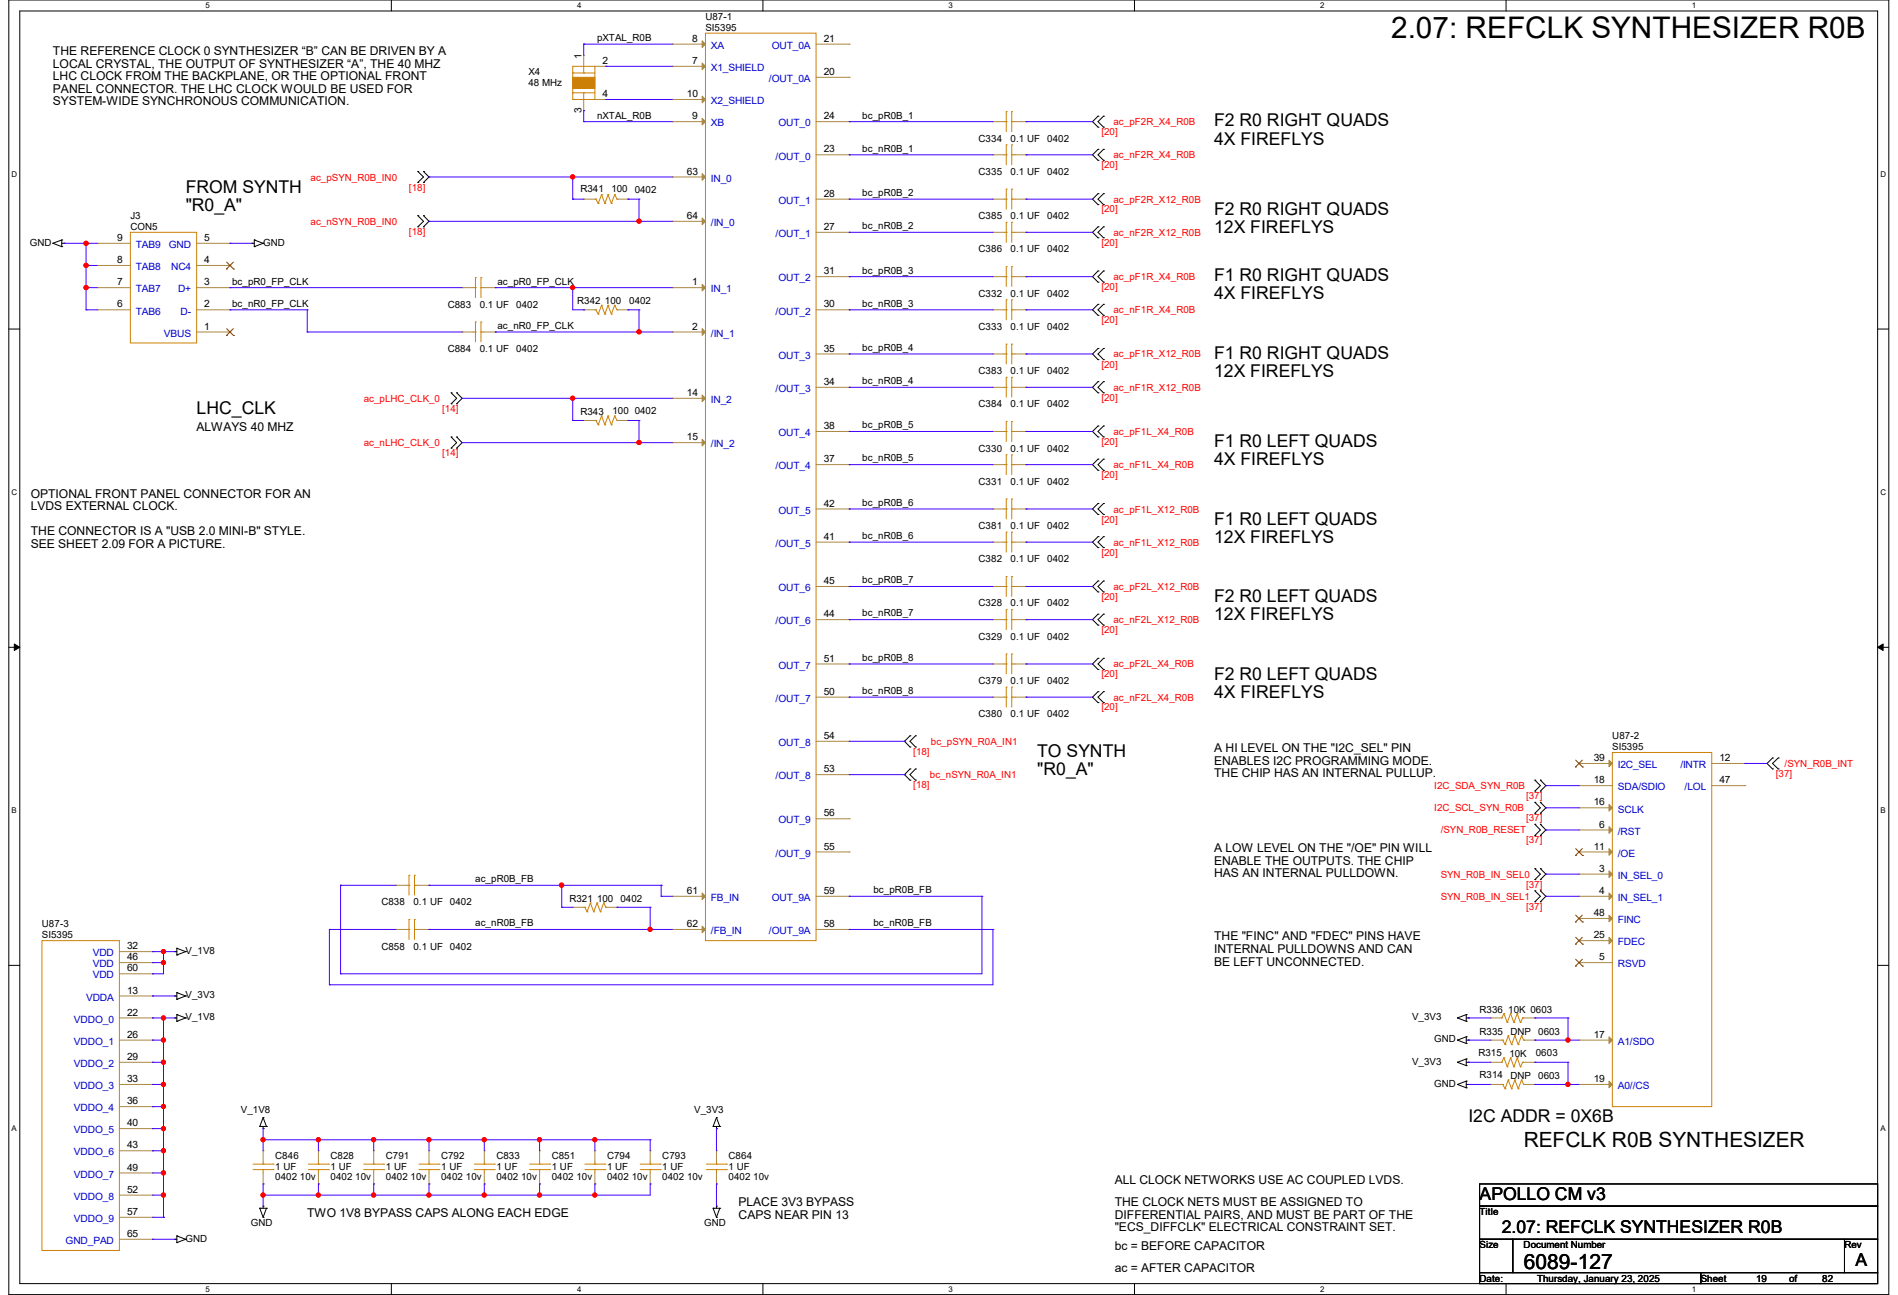
[picture p146: page 19]

LHC CLOCK FROM THE BACKPLANE, OR THE OPTIONAL FRONT
PANEL CONNECTOR. THE LHC CLOCK WOULD BE USED FOR
SYSTEM-WIDE SYNCHRONOUS COMMUNICATION.

OPTIONAL FRONT PANEL CONNECTOR FOR AN
LVDS EXTERNAL CLOCK.
THE CONNECTOR IS A "USB 2.0 MINI-B" STYLE.
SEE SHEET 2.09 FOR A PICTURE.

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

A LOW LEVEL ON THE "/OE" PIN WILL
ENABLE THE OUTPUTS. THE CHIP
HAS AN INTERNAL PULLDOWN.

THE "FINC" AND "FDEC" PINS HAVE
INTERNAL PULLDOWNS AND CAN
BE LEFT UNCONNECTED.

ALL CLOCK NETWORKS USE AC COUPLED LVDS.
THE CLOCK NETS MUST BE ASSIGNED TO
DIFFERENTIAL PAIRS, AND MUST BE PART OF THE
"ECS_DIFFCLK" ELECTRICAL CONSTRAINT SET.
bc = BEFORE CAPACITOR
ac = AFTER CAPACITOR

TWO 1V8 BYPASS CAPS ALONG EACH EDGE

FPGA#1 LEFT | FPGA#1 RIGHT

# 2.08: REFCLK R0 FANOUT

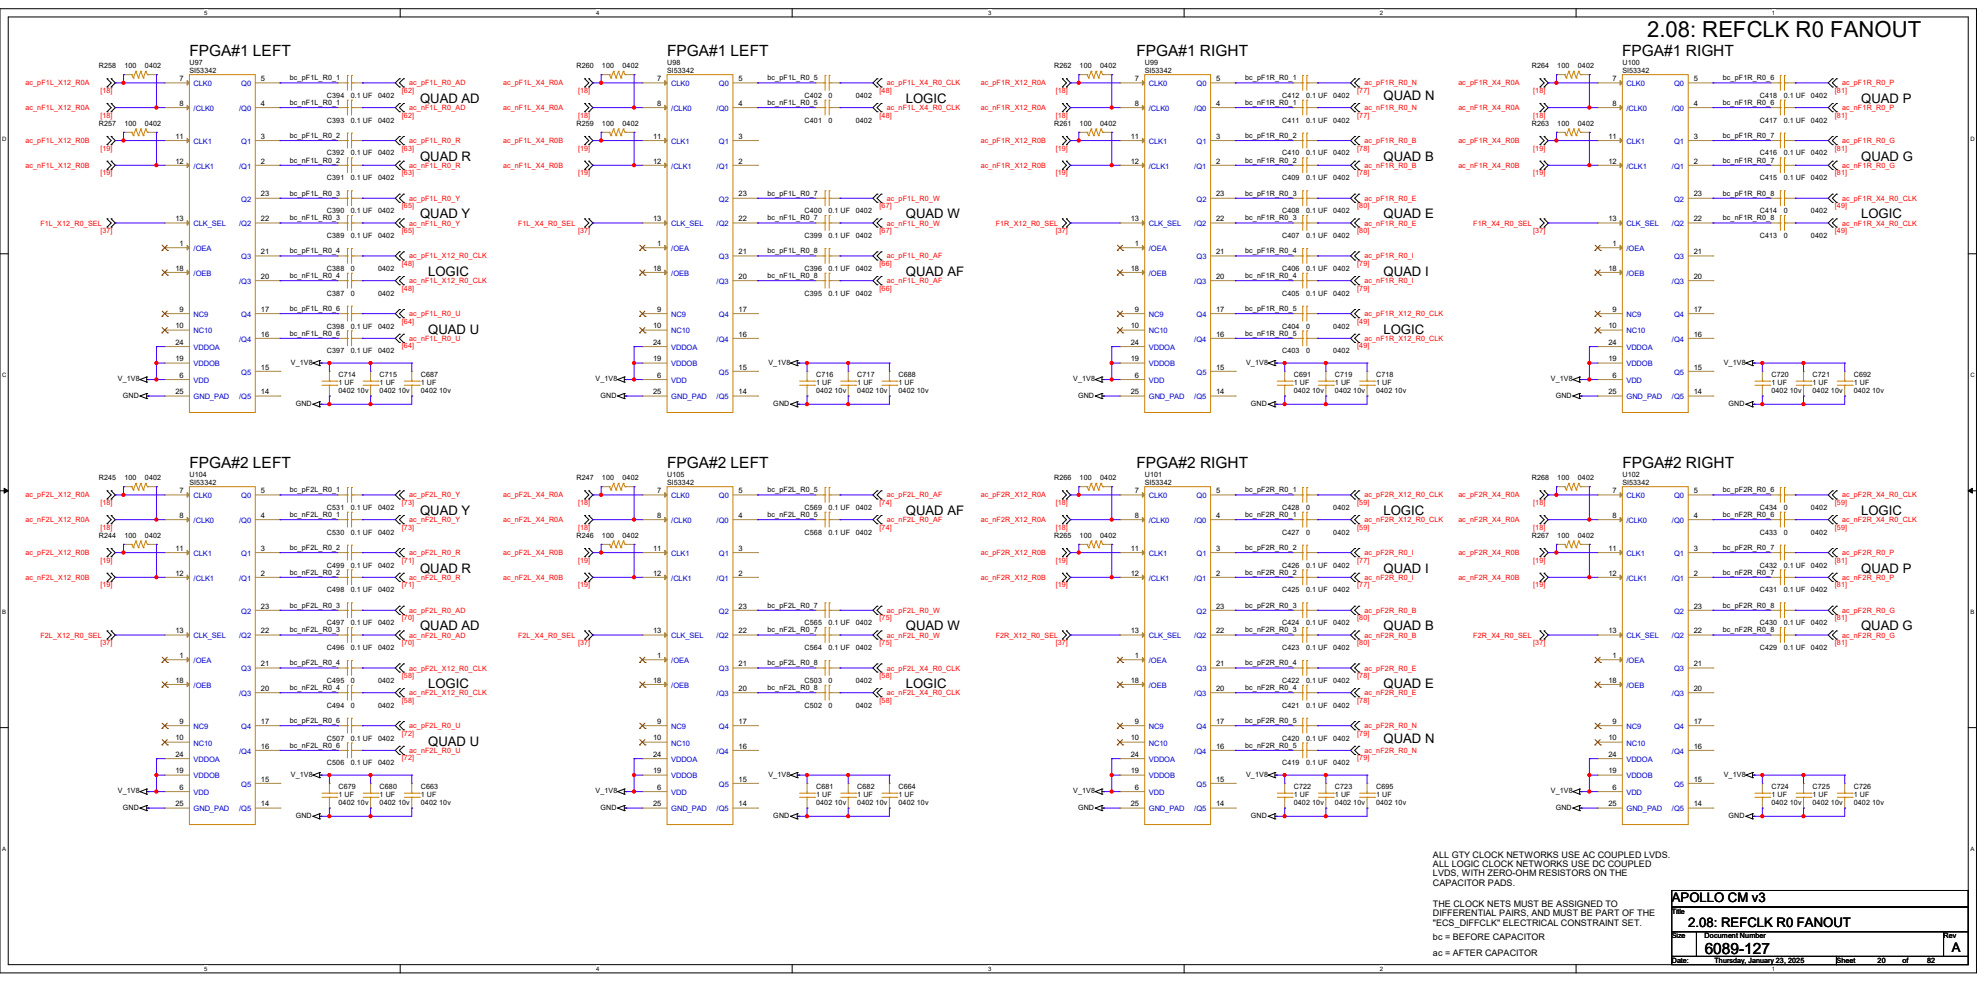
[picture p147: page 20]

ALL GTY CLOCK NETWORKS USE AC COUPLED LVDS.
ALL LOGIC CLOCK NETWORKS USE DC COUPLED
LVDS, WITH ZERO-OHM RESISTORS ON THE
CAPACITOR PADS.

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

## IF THE HQ_CLK OR LHC_CLK IS AC-COUPLED ON THE SM, USE

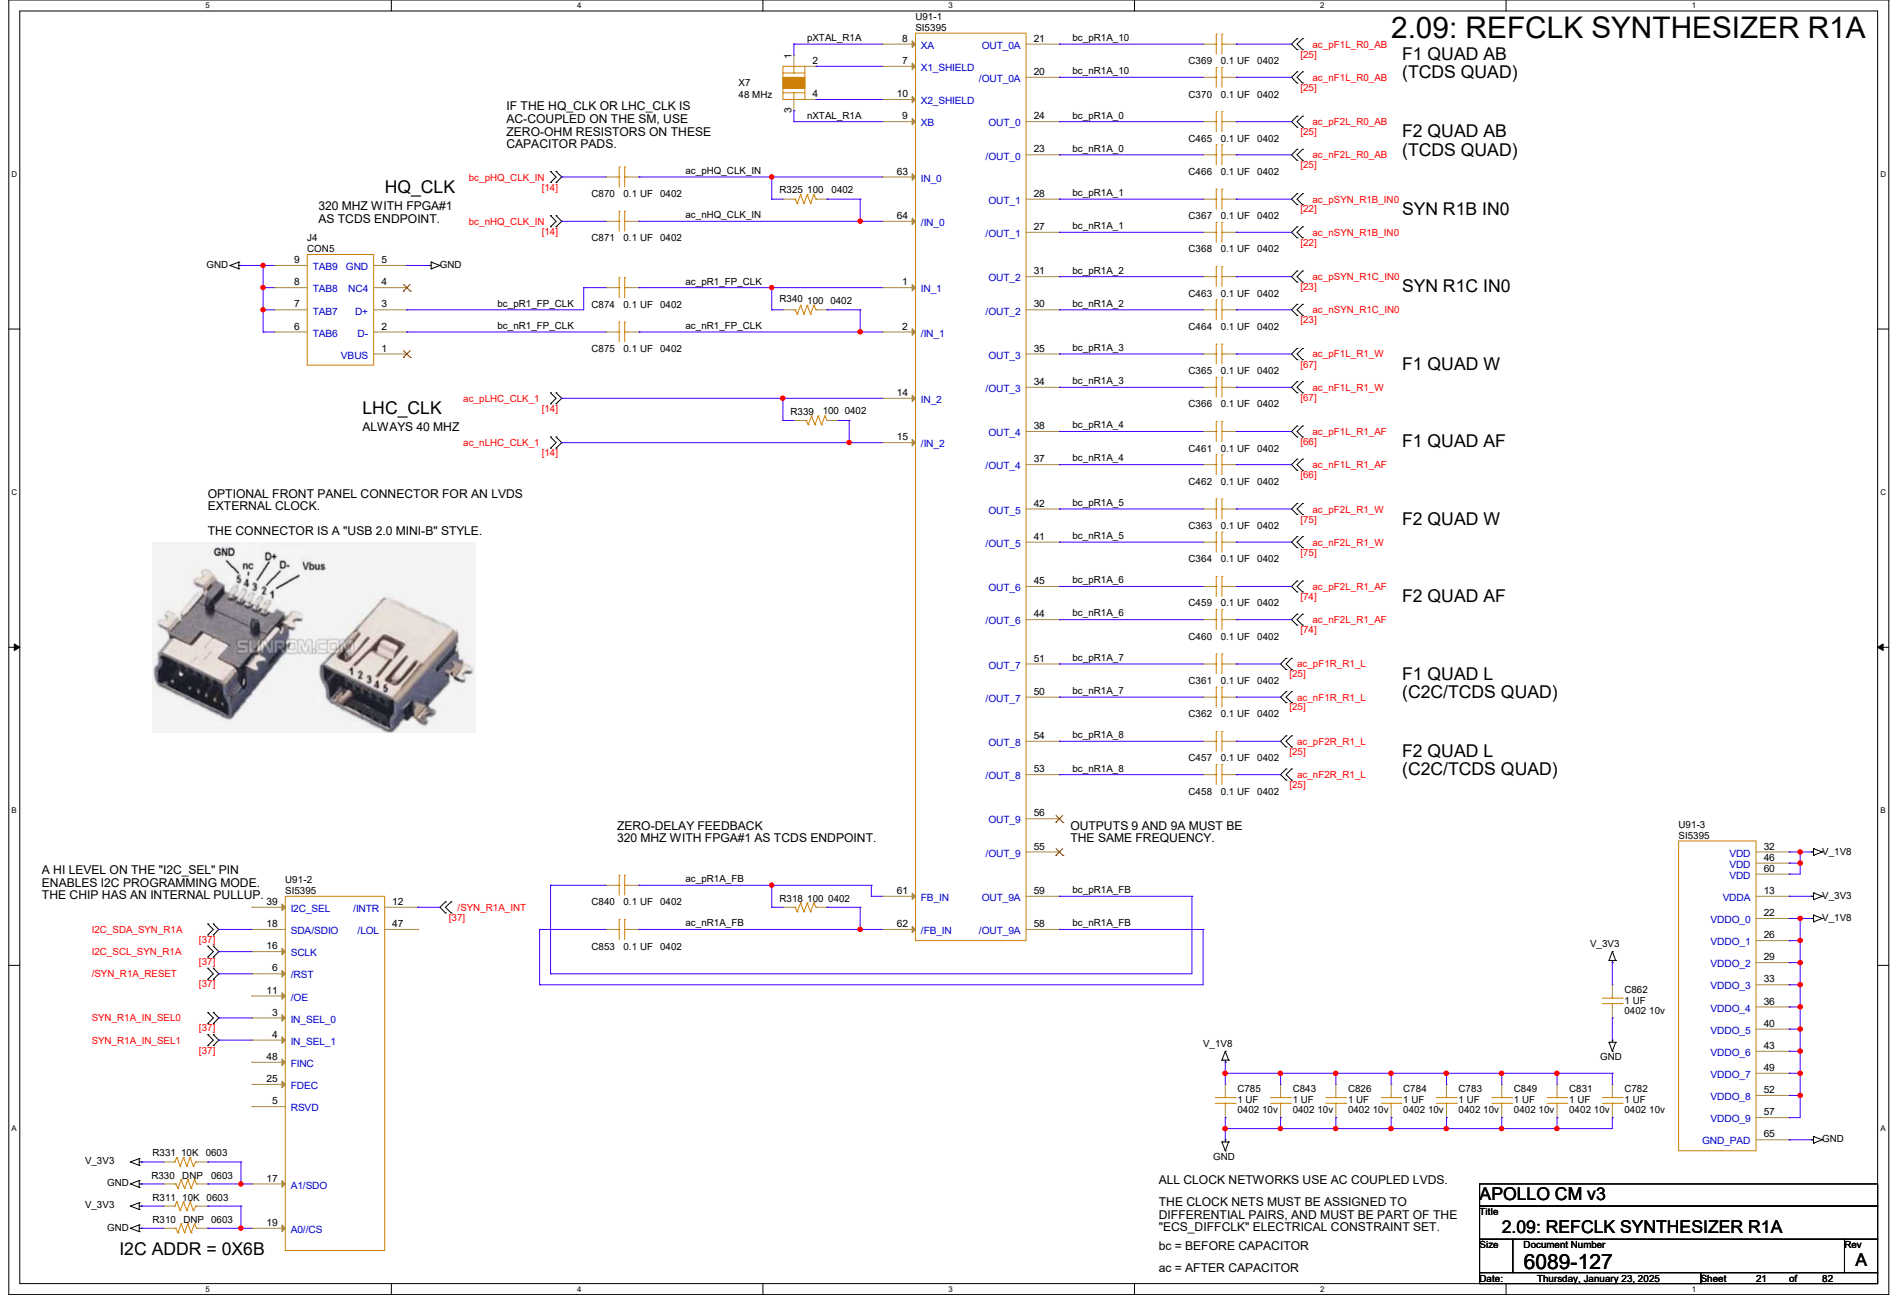
[picture p148: page 21]

ZERO-OHM RESISTORS ON THESE
CAPACITOR PADS.

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

ZERO-DELAY FEEDBACK
320 MHZ WITH FPGA#1 AS TCDS ENDPOINT.

OUTPUTS 9 AND 9A MUST BE
THE SAME FREQUENCY.

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

# F1 QUAD AB (TCDS QUAD)

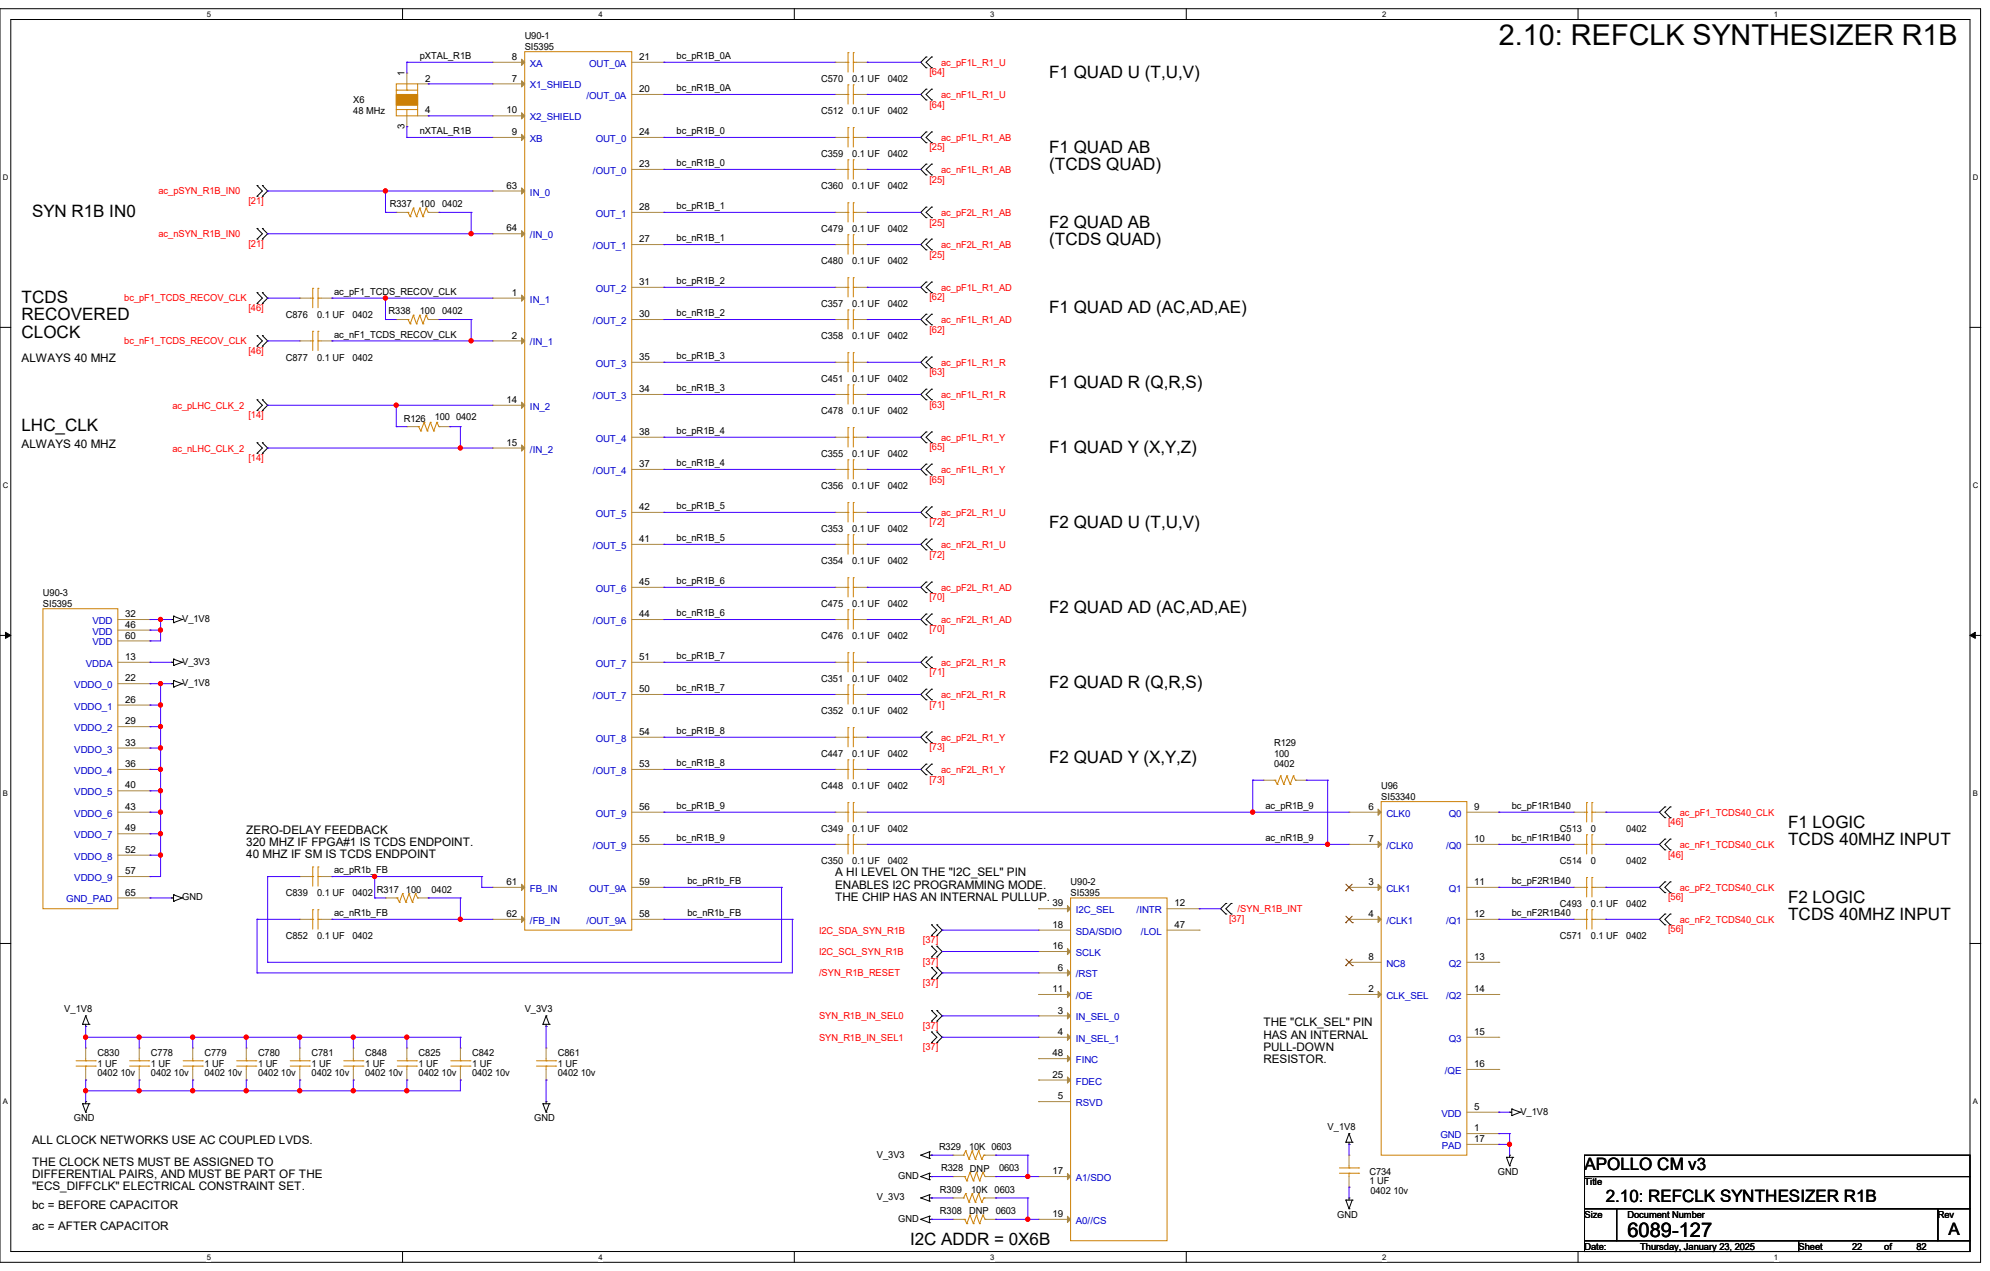
[picture p149: page 22]

F1 QUAD AD (AC,AD,AE) TCDS
RECOVERED
CLOCK

F2 QUAD AD (AC,AD,AE)

ZERO-DELAY FEEDBACK
320 MHZ IF FPGA#1 IS TCDS ENDPOINT.
40 MHZ IF SM IS TCDS ENDPOINT

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

/QE 16 VDD 5 GND 1 PAD 17

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

# SYN R1C IN0

# 2.11: REFCLK SYNTHESIZER R1C

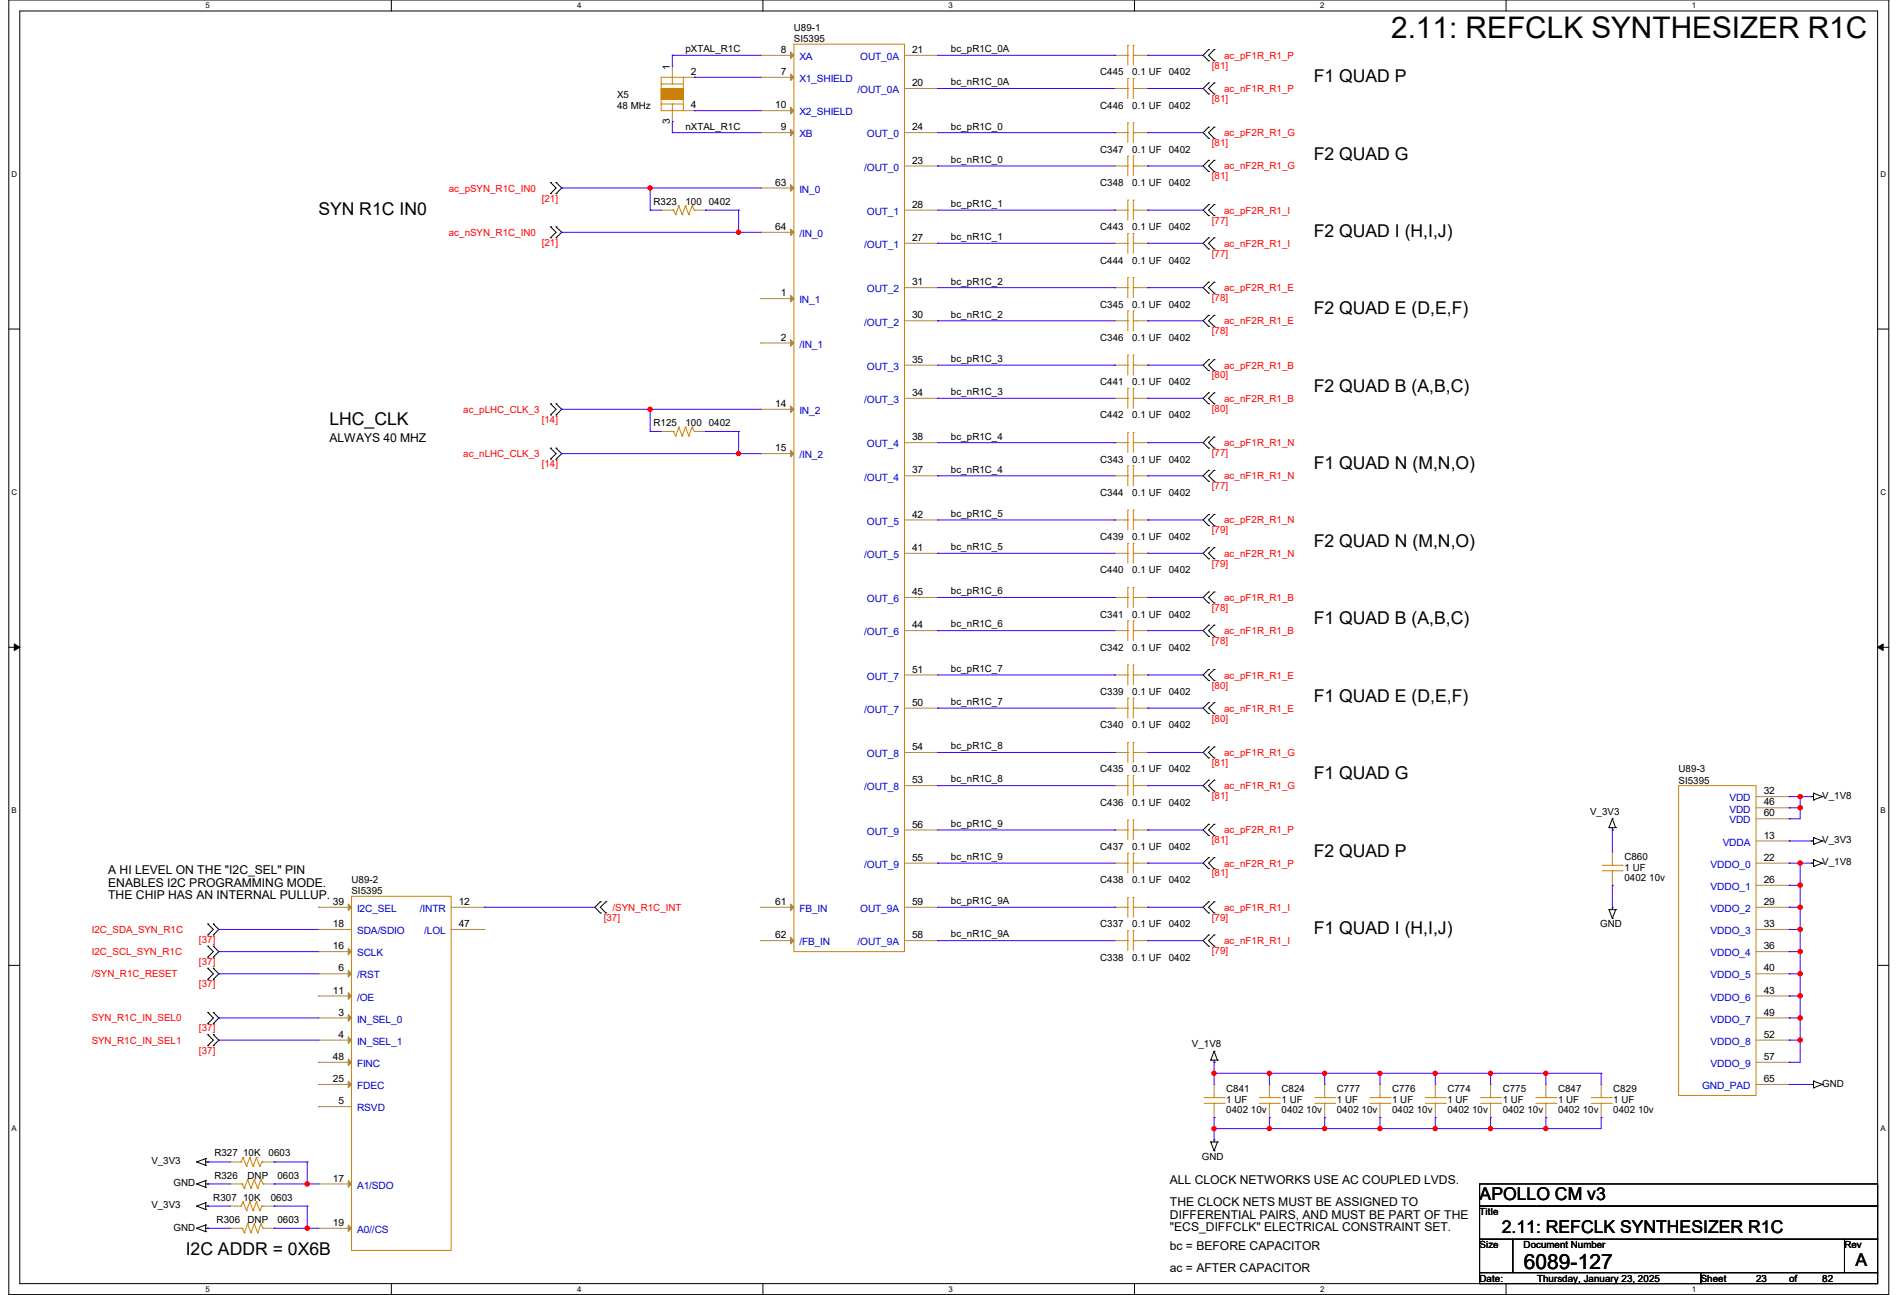
[picture p150: page 23]
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

# 2.12: LEDS AND LEVEL SHIFTERS

# PM6 72 PM5 73

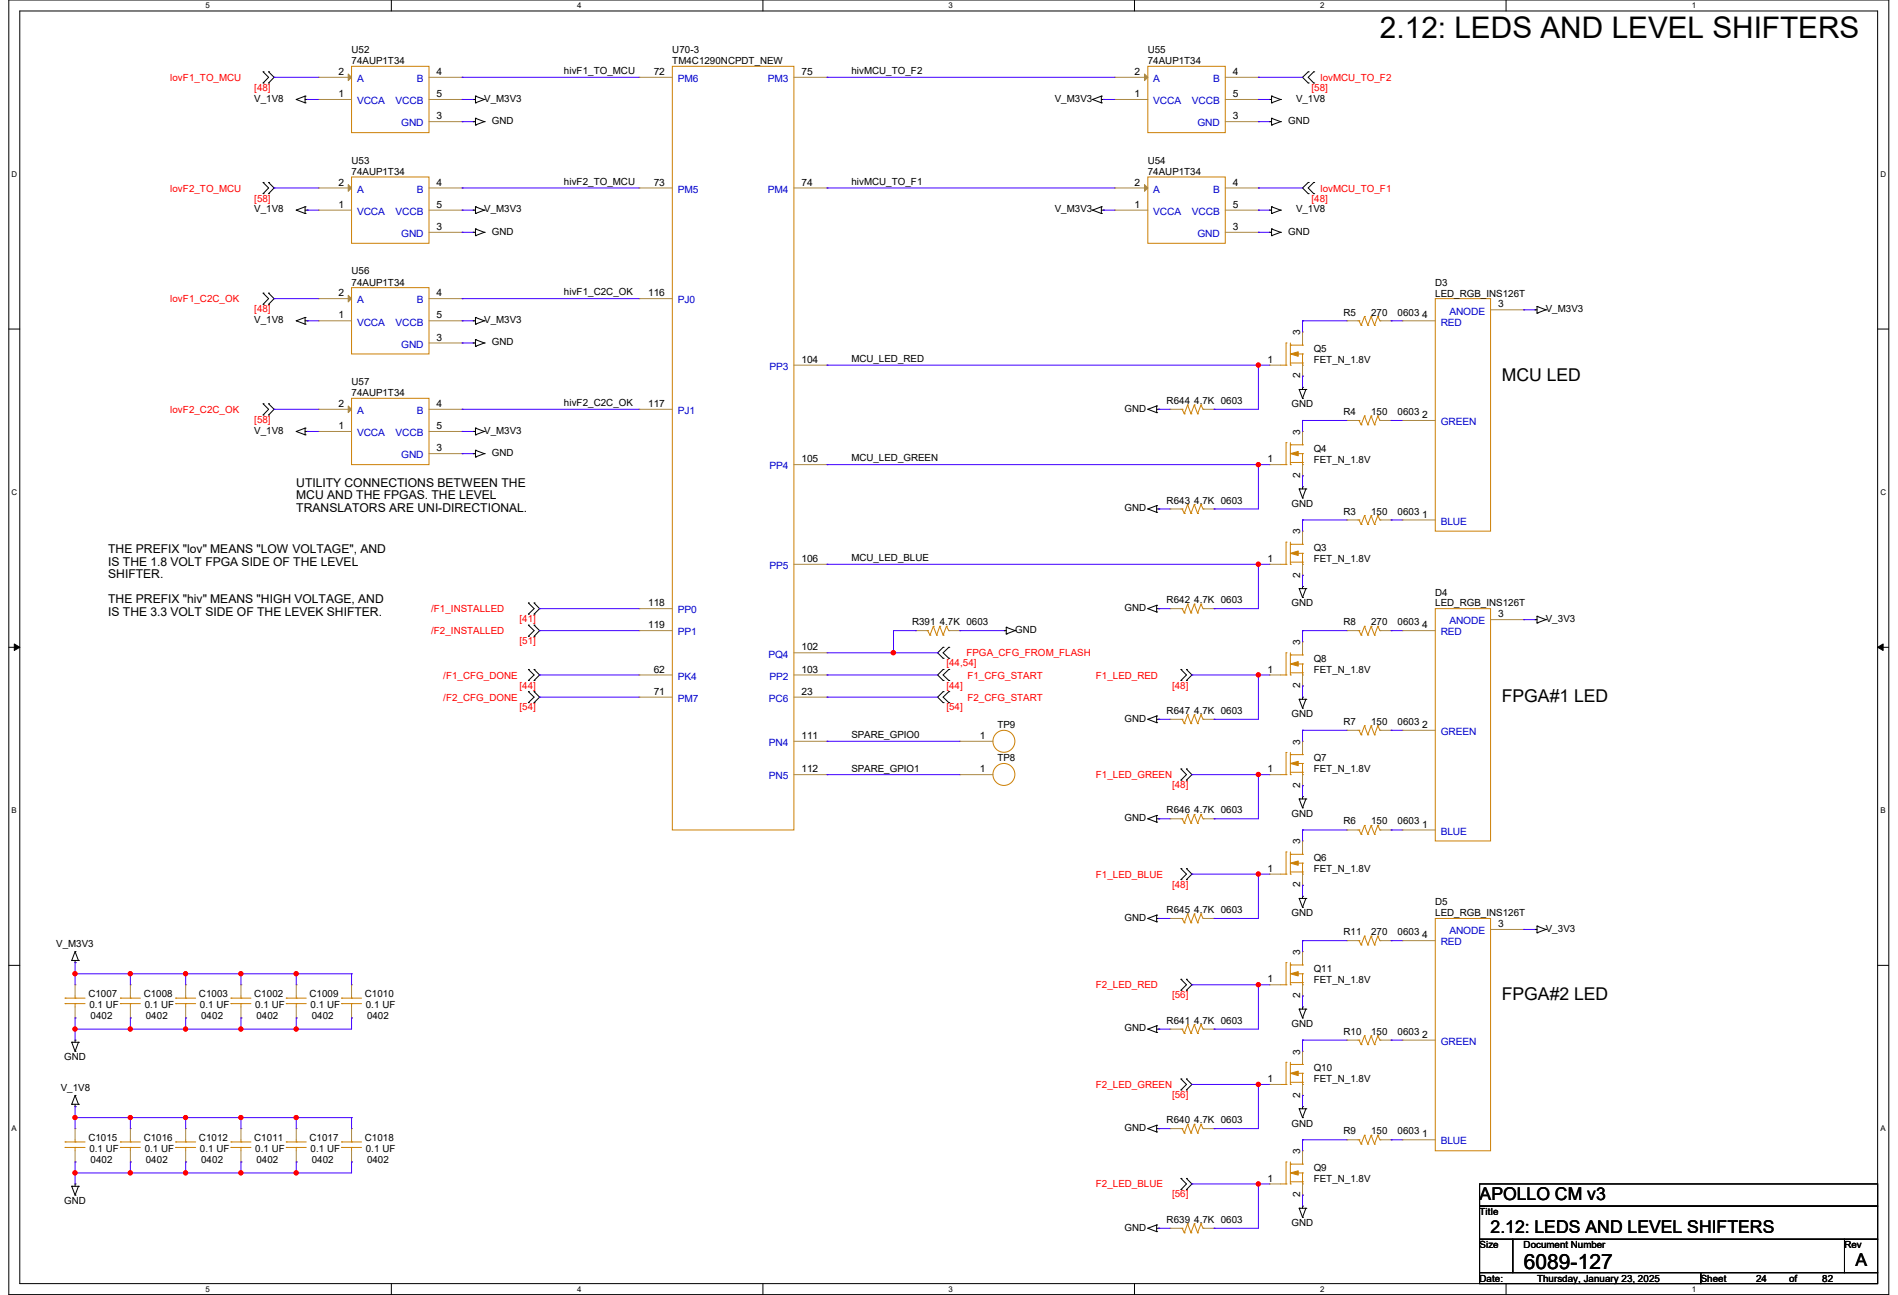
[picture p151: page 24]

UTILITY CONNECTIONS BETWEEN THE
MCU AND THE FPGAS. THE LEVEL
TRANSLATORS ARE UNI-DIRECTIONAL.

THE PREFIX "lov" MEANS "LOW VOLTAGE", AND
IS THE 1.8 VOLT FPGA SIDE OF THE LEVEL
SHIFTER.
THE PREFIX "hiv" MEANS "HIGH VOLTAGE, AND
IS THE 3.3 VOLT SIDE OF THE LEVEK SHIFTER.

2.12: LEDS AND LEVEL SHIFTERS

# THE "AB" QUADS ARE DEDICATED TO TCDS SIGNALS. THE "L" QUADS ARE DEDICATED

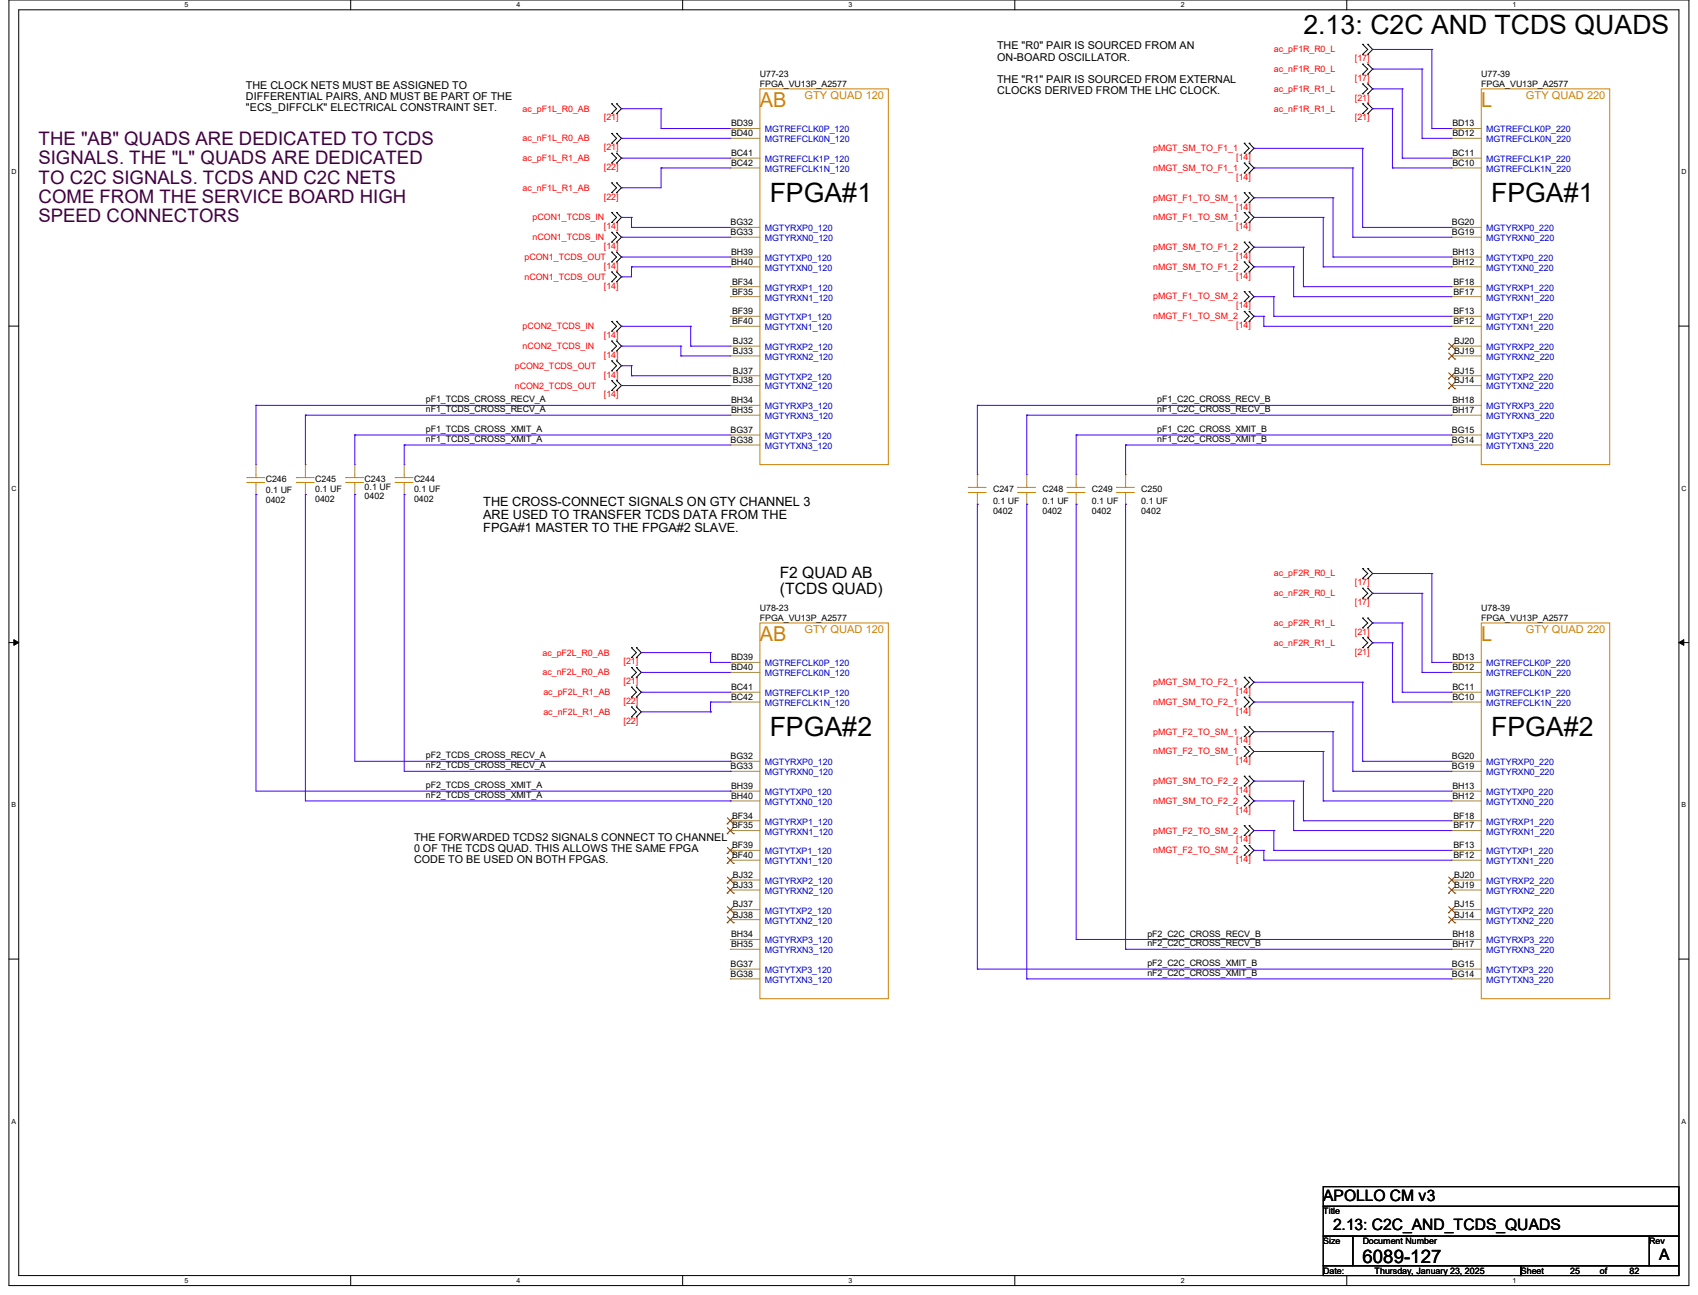
[picture p152: page 25]

THE "R0" PAIR IS SOURCED FROM AN
ON-BOARD OSCILLATOR.
THE "R1" PAIR IS SOURCED FROM EXTERNAL
CLOCKS DERIVED FROM THE LHC CLOCK.

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

TO C2C SIGNALS. TCDS AND C2C NETS
COME FROM THE SERVICE BOARD HIGH
SPEED CONNECTORS

THE CROSS-CONNECT SIGNALS ON GTY CHANNEL 3
ARE USED TO TRANSFER TCDS DATA FROM THE
FPGA#1 MASTER TO THE FPGA#2 SLAVE.

THE FORWARDED TCDS2 SIGNALS CONNECT TO CHANNEL
0 OF THE TCDS QUAD. THIS ALLOWS THE SAME FPGA
CODE TO BE USED ON BOTH FPGAS.

## SPREAD THESE CAPACITORS AROUND THE BOARD

# 3.01: POWER MANAGEMENT M3V3

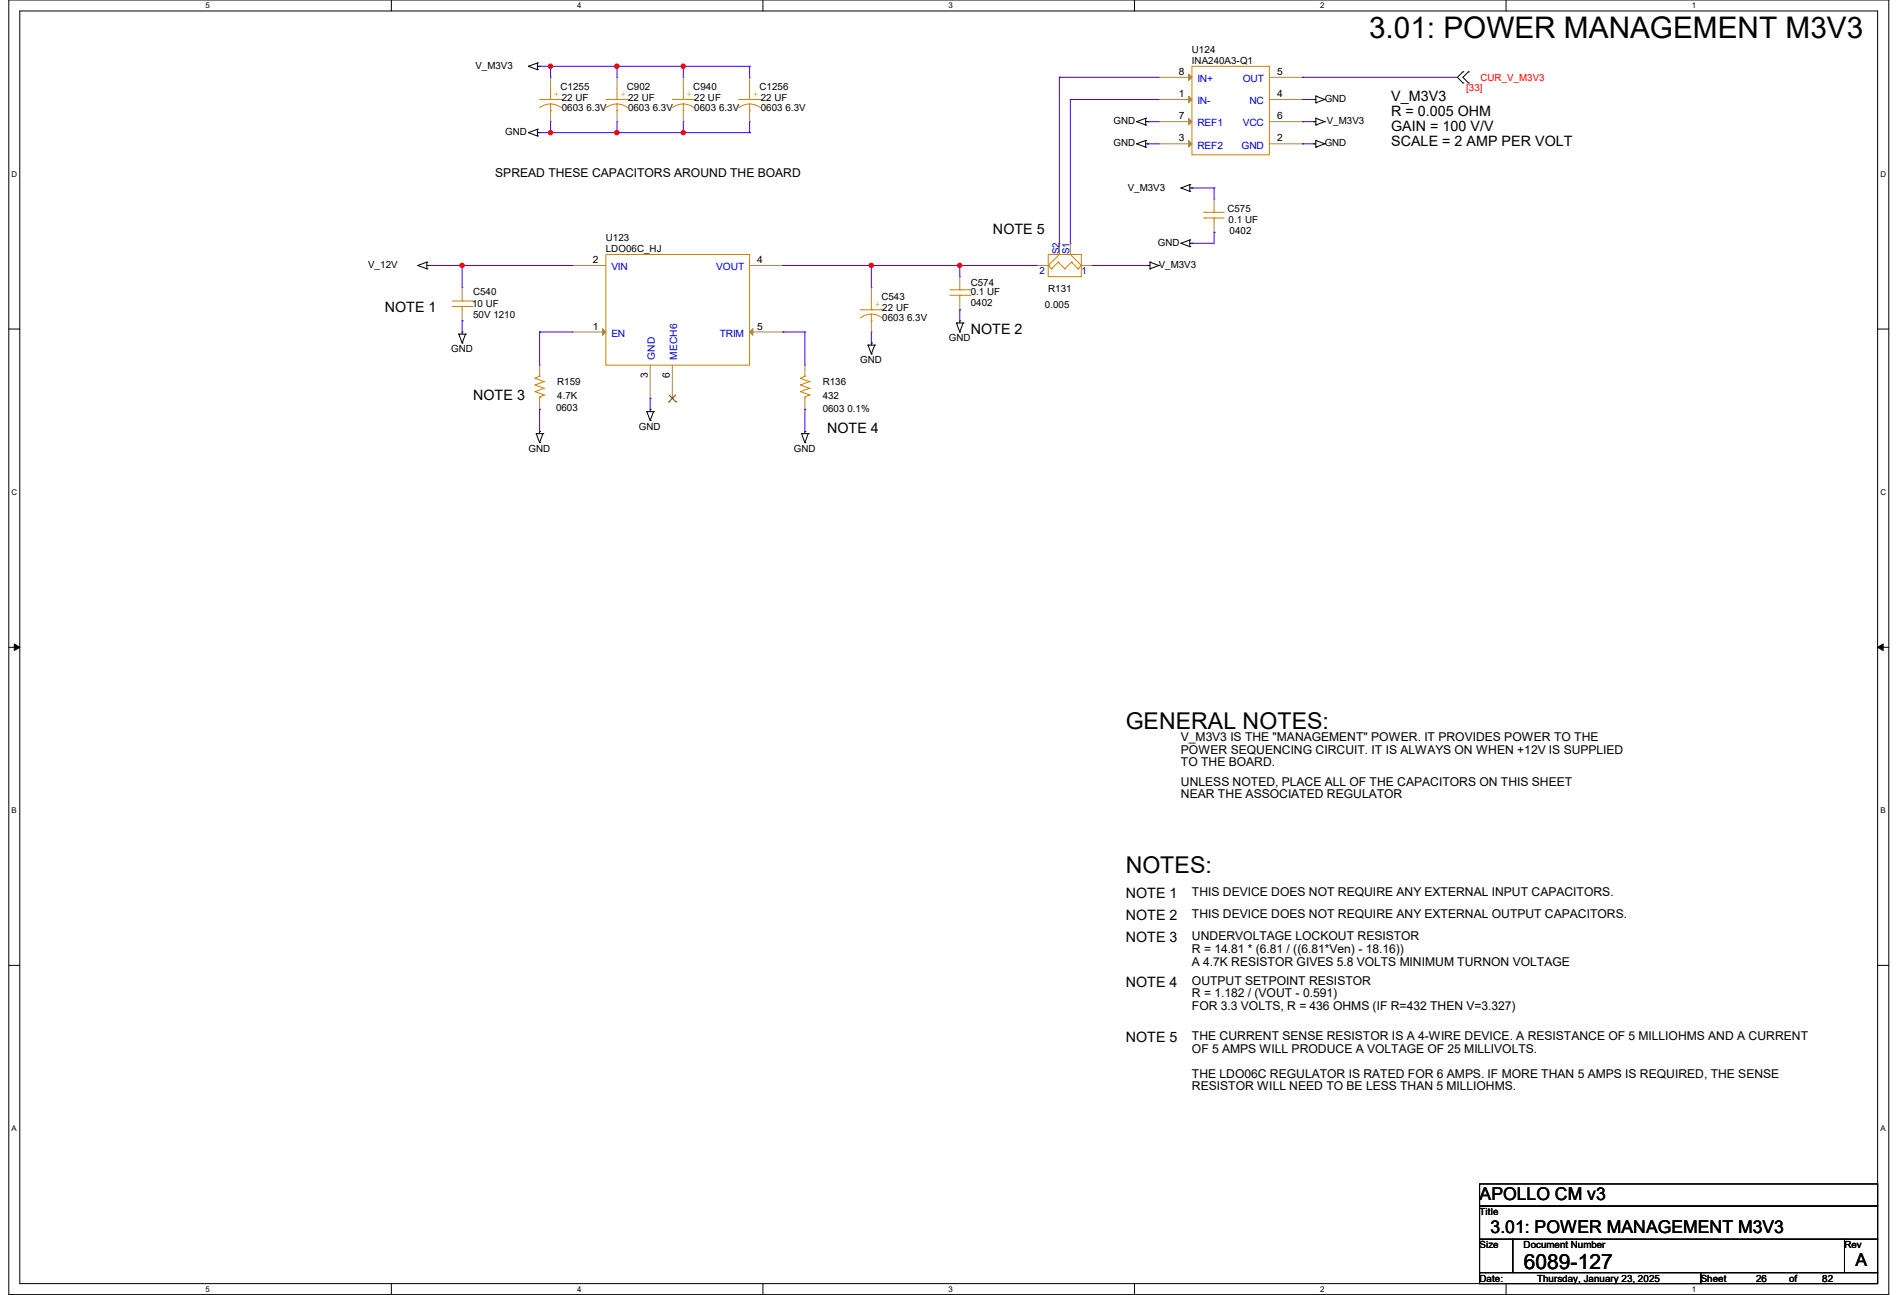
[picture p153: page 26]

V_M3V3 IS THE "MANAGEMENT" POWER. IT PROVIDES POWER TO THE
POWER SEQUENCING CIRCUIT. IT IS ALWAYS ON WHEN +12V IS SUPPLIED
TO THE BOARD.
UNLESS NOTED, PLACE ALL OF THE CAPACITORS ON THIS SHEET
NEAR THE ASSOCIATED REGULATOR

THIS DEVICE DOES NOT REQUIRE ANY EXTERNAL INPUT CAPACITORS.
THIS DEVICE DOES NOT REQUIRE ANY EXTERNAL OUTPUT CAPACITORS.
UNDERVOLTAGE LOCKOUT RESISTOR
R = 14.81 * (6.81 / ((6.81*Ven) - 18.16))
A 4.7K RESISTOR GIVES 5.8 VOLTS MINIMUM TURNON VOLTAGE
OUTPUT SETPOINT RESISTOR
R = 1.182 / (VOUT - 0.591)
FOR 3.3 VOLTS, R = 436 OHMS (IF R=432 THEN V=3.327)

THE CURRENT SENSE RESISTOR IS A 4-WIRE DEVICE. A RESISTANCE OF 5 MILLIOHMS AND A CURRENT
OF 5 AMPS WILL PRODUCE A VOLTAGE OF 25 MILLIVOLTS.
THE LDO06C REGULATOR IS RATED FOR 6 AMPS. IF MORE THAN 5 AMPS IS REQUIRED, THE SENSE
RESISTOR WILL NEED TO BE LESS THAN 5 MILLIOHMS.

# I2C ADDR = 0X40 (AND 0X41)

## NOTE 5

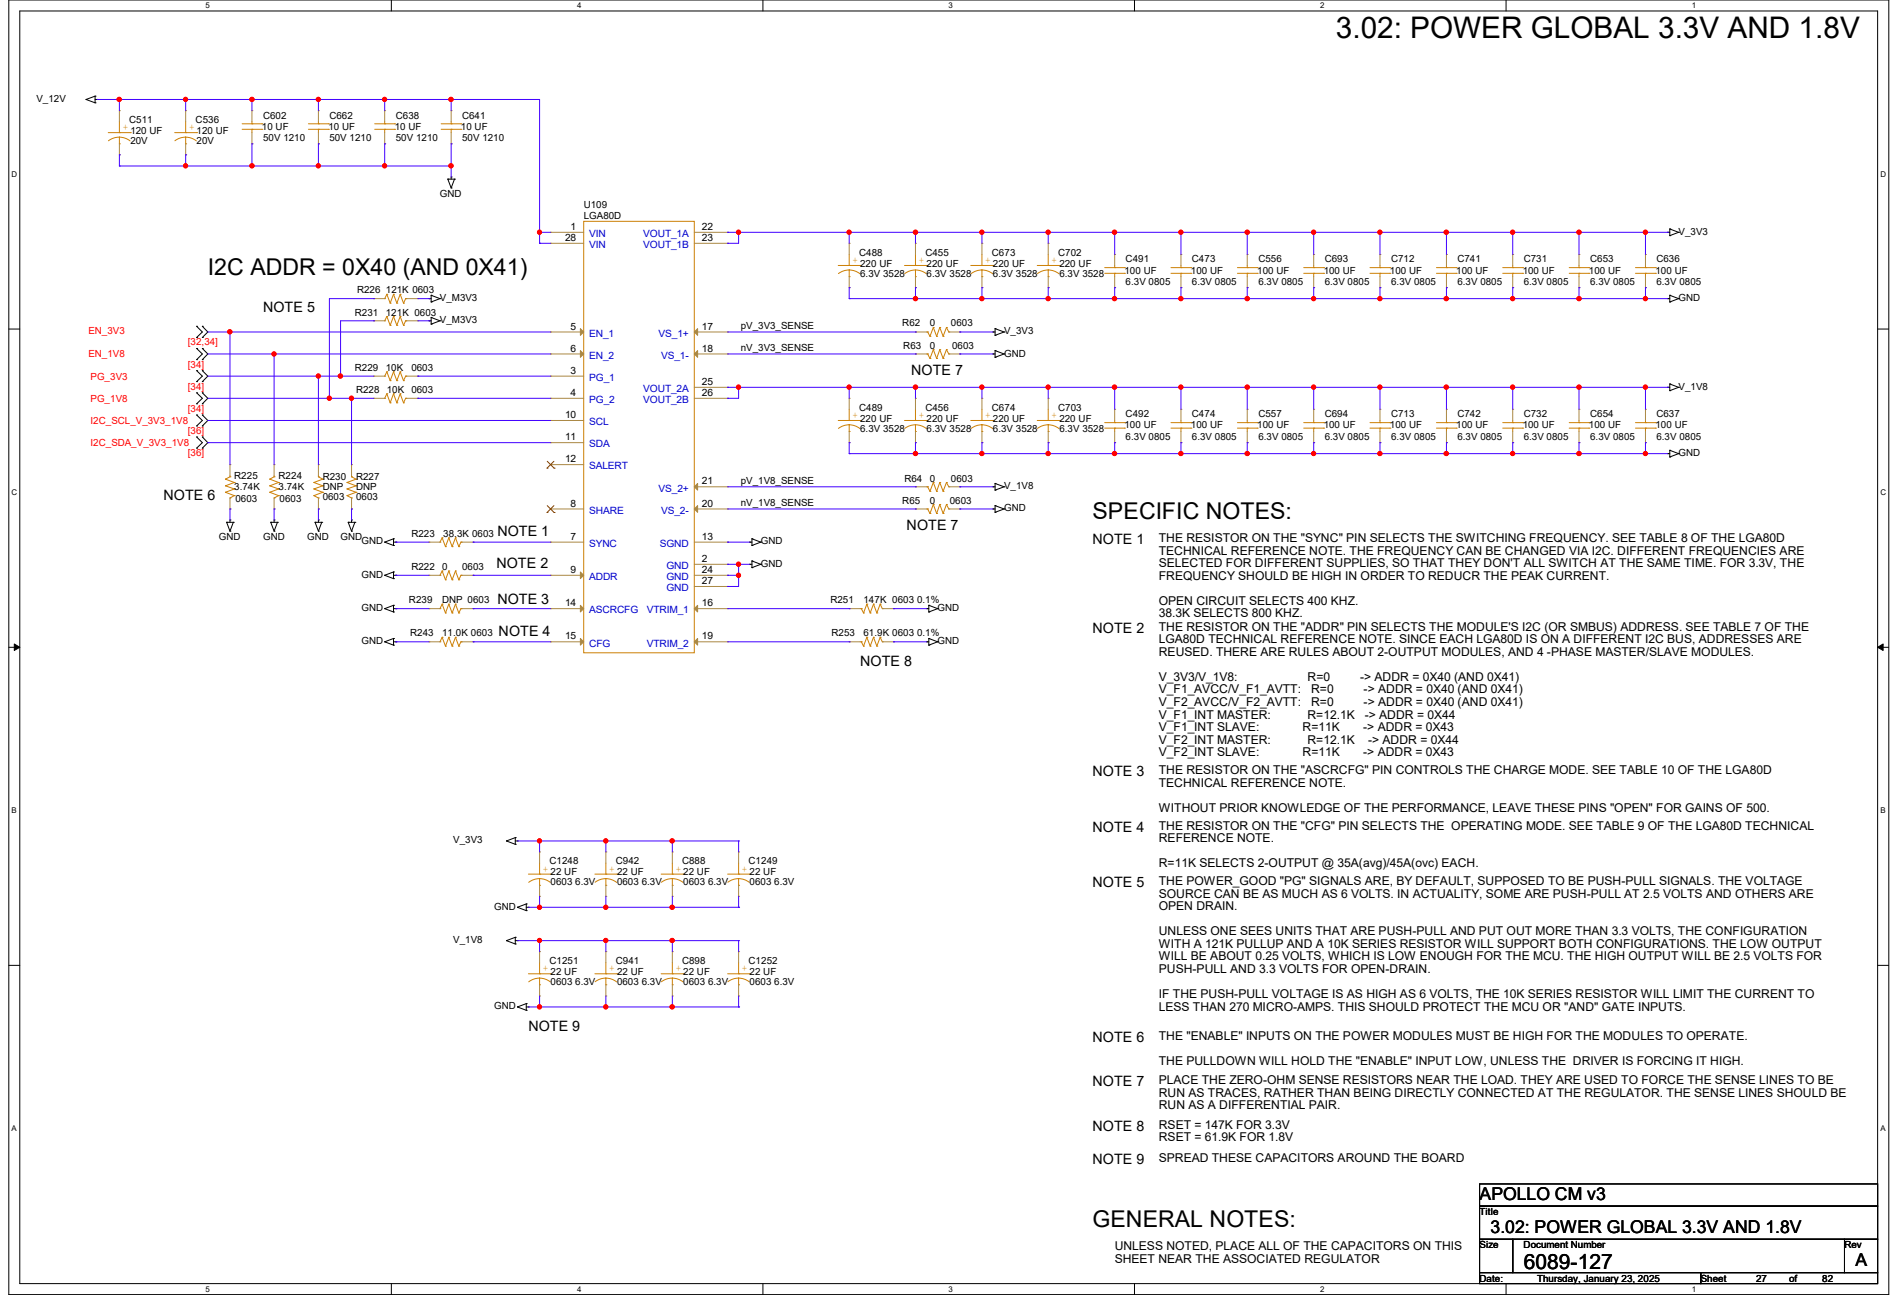
[picture p154: page 27]

THE RESISTOR ON THE "SYNC" PIN SELECTS THE SWITCHING FREQUENCY. SEE TABLE 8 OF THE LGA80D
TECHNICAL REFERENCE NOTE. THE FREQUENCY CAN BE CHANGED VIA I2C. DIFFERENT FREQUENCIES ARE
SELECTED FOR DIFFERENT SUPPLIES, SO THAT THEY DON'T ALL SWITCH AT THE SAME TIME. FOR 3.3V, THE
FREQUENCY SHOULD BE HIGH IN ORDER TO REDUCR THE PEAK CURRENT.
OPEN CIRCUIT SELECTS 400 KHZ.
38.3K SELECTS 800 KHZ.
THE RESISTOR ON THE "ADDR" PIN SELECTS THE MODULE'S I2C (OR SMBUS) ADDRESS. SEE TABLE 7 OF THE
LGA80D TECHNICAL REFERENCE NOTE. SINCE EACH LGA80D IS ON A DIFFERENT I2C BUS, ADDRESSES ARE
REUSED. THERE ARE RULES ABOUT 2-OUTPUT MODULES, AND 4 -PHASE MASTER/SLAVE MODULES.
THE RESISTOR ON THE "ASCRCFG" PIN CONTROLS THE CHARGE MODE. SEE TABLE 10 OF THE LGA80D
TECHNICAL REFERENCE NOTE.
WITHOUT PRIOR KNOWLEDGE OF THE PERFORMANCE, LEAVE THESE PINS "OPEN" FOR GAINS OF 500.
THE RESISTOR ON THE "CFG" PIN SELECTS THE OPERATING MODE. SEE TABLE 9 OF THE LGA80D TECHNICAL
REFERENCE NOTE.
R=11K SELECTS 2-OUTPUT @ 35A(avg)/45A(ovc) EACH.
THE POWER_GOOD "PG" SIGNALS ARE, BY DEFAULT, SUPPOSED TO BE PUSH-PULL SIGNALS. THE VOLTAGE
SOURCE CAN BE AS MUCH AS 6 VOLTS. IN ACTUALITY, SOME ARE PUSH-PULL AT 2.5 VOLTS AND OTHERS ARE
OPEN DRAIN.
UNLESS ONE SEES UNITS THAT ARE PUSH-PULL AND PUT OUT MORE THAN 3.3 VOLTS, THE CONFIGURATION
WITH A 121K PULLUP AND A 10K SERIES RESISTOR WILL SUPPORT BOTH CONFIGURATIONS. THE LOW OUTPUT
WILL BE ABOUT 0.25 VOLTS, WHICH IS LOW ENOUGH FOR THE MCU. THE HIGH OUTPUT WILL BE 2.5 VOLTS FOR
PUSH-PULL AND 3.3 VOLTS FOR OPEN-DRAIN.
IF THE PUSH-PULL VOLTAGE IS AS HIGH AS 6 VOLTS, THE 10K SERIES RESISTOR WILL LIMIT THE CURRENT TO
LESS THAN 270 MICRO-AMPS. THIS SHOULD PROTECT THE MCU OR "AND" GATE INPUTS.

THE "ENABLE" INPUTS ON THE POWER MODULES MUST BE HIGH FOR THE MODULES TO OPERATE.
THE PULLDOWN WILL HOLD THE "ENABLE" INPUT LOW, UNLESS THE DRIVER IS FORCING IT HIGH.
PLACE THE ZERO-OHM SENSE RESISTORS NEAR THE LOAD. THEY ARE USED TO FORCE THE SENSE LINES TO BE
RUN AS TRACES, RATHER THAN BEING DIRECTLY CONNECTED AT THE REGULATOR. THE SENSE LINES SHOULD BE
RUN AS A DIFFERENTIAL PAIR.
RSET = 147K FOR 3.3V
RSET = 61.9K FOR 1.8V
SPREAD THESE CAPACITORS AROUND THE BOARD

UNLESS NOTED, PLACE ALL OF THE CAPACITORS ON THIS
SHEET NEAR THE ASSOCIATED REGULATOR

A

## NOTE 5

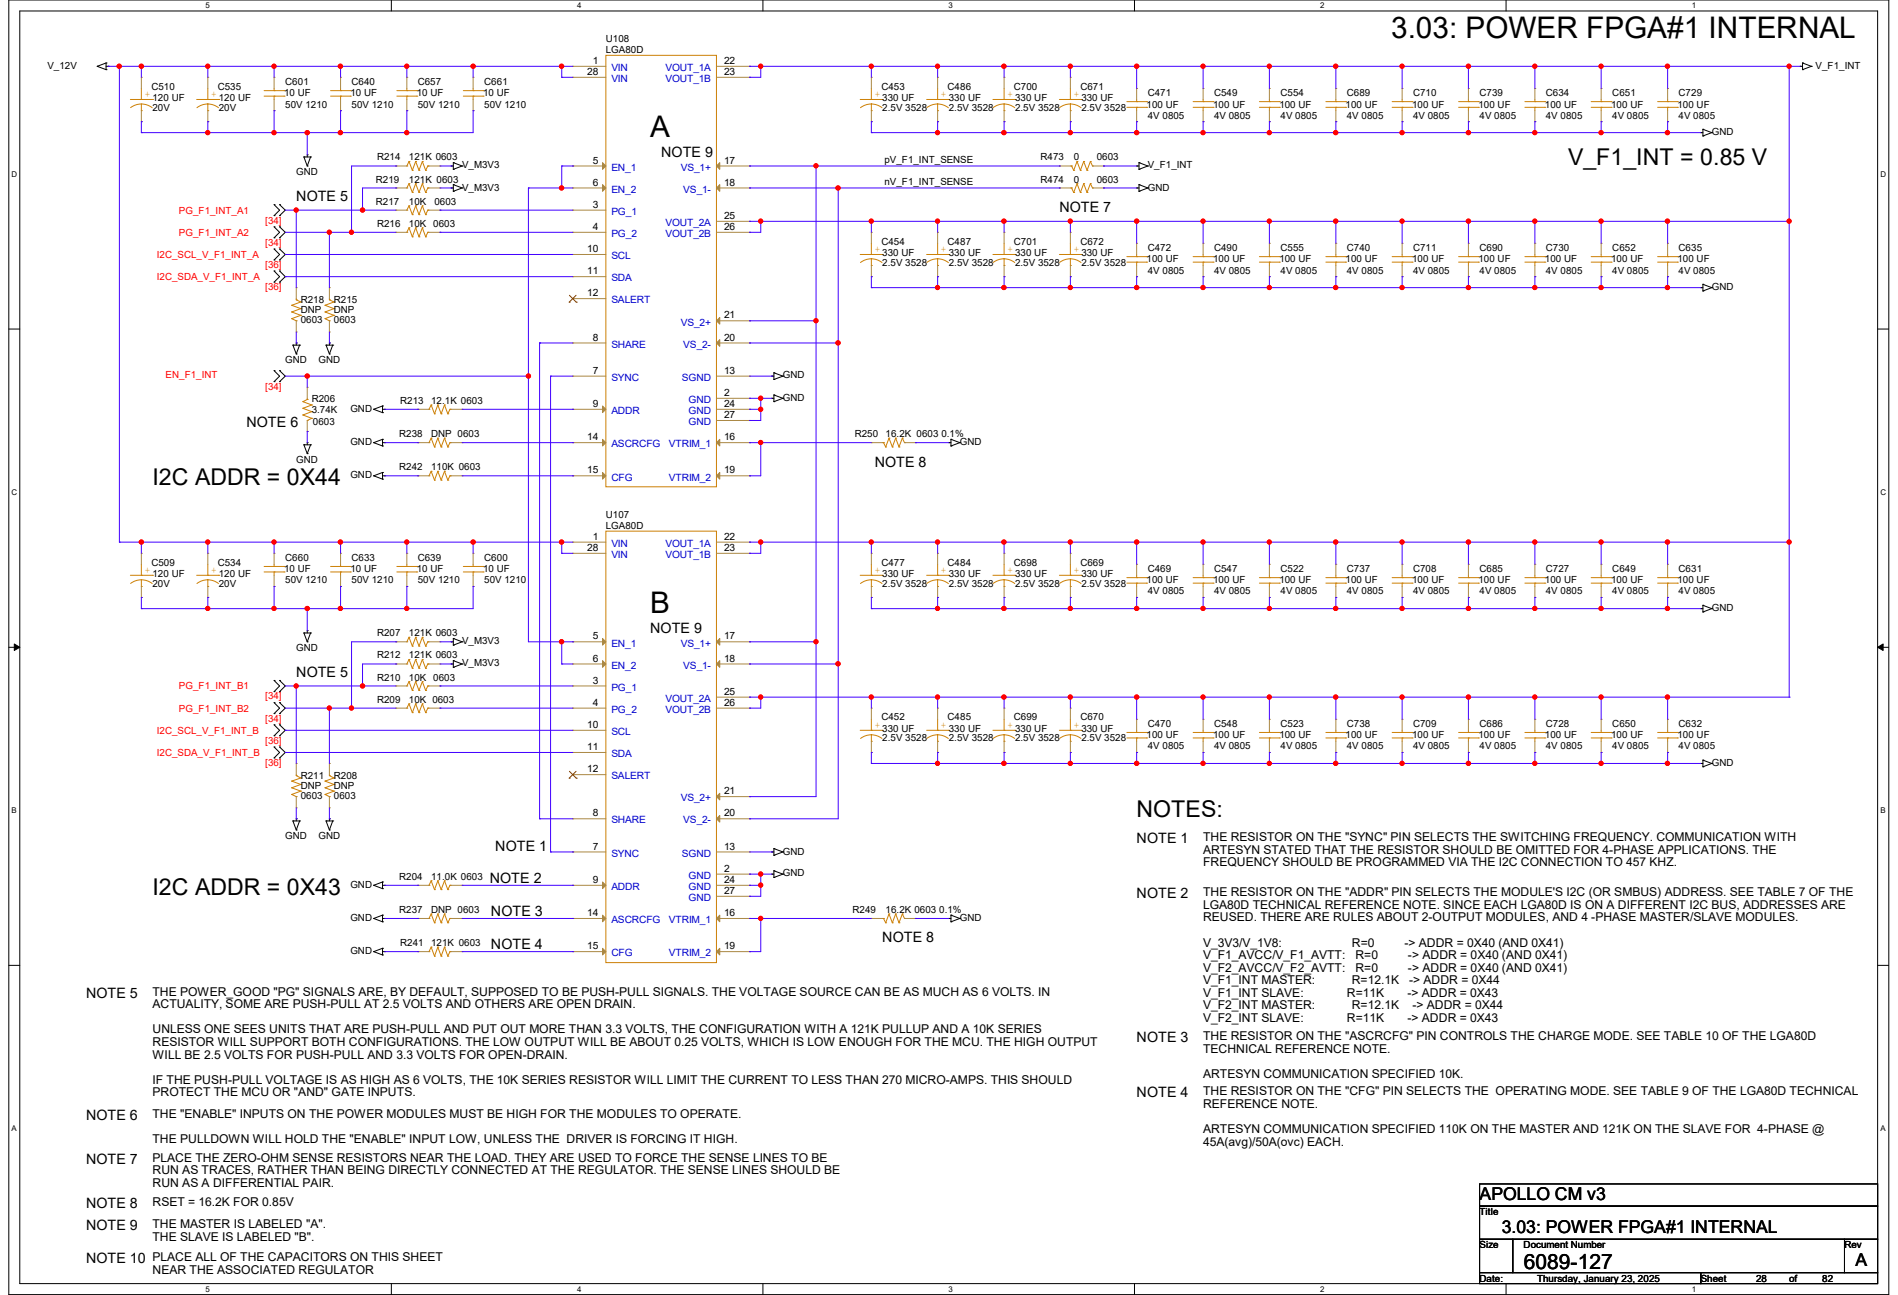
[picture p155: page 28]

THE RESISTOR ON THE "SYNC" PIN SELECTS THE SWITCHING FREQUENCY. COMMUNICATION WITH
ARTESYN STATED THAT THE RESISTOR SHOULD BE OMITTED FOR 4-PHASE APPLICATIONS. THE
FREQUENCY SHOULD BE PROGRAMMED VIA THE I2C CONNECTION TO 457 KHZ.

NOTE 2 THE RESISTOR ON THE "ADDR" PIN SELECTS THE MODULE'S I2C (OR SMBUS) ADDRESS. SEE TABLE 7 OF THE

LGA80D TECHNICAL REFERENCE NOTE. SINCE EACH LGA80D IS ON A DIFFERENT I2C BUS, ADDRESSES ARE
REUSED. THERE ARE RULES ABOUT 2-OUTPUT MODULES, AND 4 -PHASE MASTER/SLAVE MODULES.
THE RESISTOR ON THE "ASCRCFG" PIN CONTROLS THE CHARGE MODE. SEE TABLE 10 OF THE LGA80D
TECHNICAL REFERENCE NOTE.
ARTESYN COMMUNICATION SPECIFIED 10K.
THE RESISTOR ON THE "CFG" PIN SELECTS THE OPERATING MODE. SEE TABLE 9 OF THE LGA80D TECHNICAL
REFERENCE NOTE.
ARTESYN COMMUNICATION SPECIFIED 110K ON THE MASTER AND 121K ON THE SLAVE FOR 4-PHASE @
45A(avg)/50A(ovc) EACH.

THE POWER_GOOD "PG" SIGNALS ARE, BY DEFAULT, SUPPOSED TO BE PUSH-PULL SIGNALS. THE VOLTAGE SOURCE CAN BE AS MUCH AS 6 VOLTS. IN
ACTUALITY, SOME ARE PUSH-PULL AT 2.5 VOLTS AND OTHERS ARE OPEN DRAIN.
UNLESS ONE SEES UNITS THAT ARE PUSH-PULL AND PUT OUT MORE THAN 3.3 VOLTS, THE CONFIGURATION WITH A 121K PULLUP AND A 10K SERIES
RESISTOR WILL SUPPORT BOTH CONFIGURATIONS. THE LOW OUTPUT WILL BE ABOUT 0.25 VOLTS, WHICH IS LOW ENOUGH FOR THE MCU. THE HIGH OUTPUT
WILL BE 2.5 VOLTS FOR PUSH-PULL AND 3.3 VOLTS FOR OPEN-DRAIN.
IF THE PUSH-PULL VOLTAGE IS AS HIGH AS 6 VOLTS, THE 10K SERIES RESISTOR WILL LIMIT THE CURRENT TO LESS THAN 270 MICRO-AMPS. THIS SHOULD
PROTECT THE MCU OR "AND" GATE INPUTS.
THE "ENABLE" INPUTS ON THE POWER MODULES MUST BE HIGH FOR THE MODULES TO OPERATE.
THE PULLDOWN WILL HOLD THE "ENABLE" INPUT LOW, UNLESS THE DRIVER IS FORCING IT HIGH.
PLACE THE ZERO-OHM SENSE RESISTORS NEAR THE LOAD. THEY ARE USED TO FORCE THE SENSE LINES TO BE
RUN AS TRACES, RATHER THAN BEING DIRECTLY CONNECTED AT THE REGULATOR. THE SENSE LINES SHOULD BE
RUN AS A DIFFERENTIAL PAIR.
RSET = 16.2K FOR 0.85V

NOTE 8
NOTE 9 THE MASTER IS LABELED "A".

THE SLAVE IS LABELED "B".
PLACE ALL OF THE CAPACITORS ON THIS SHEET
NEAR THE ASSOCIATED REGULATOR

# V_F1_AVCC = 0.9 V

# V_F1_AVTT = 1.2 V

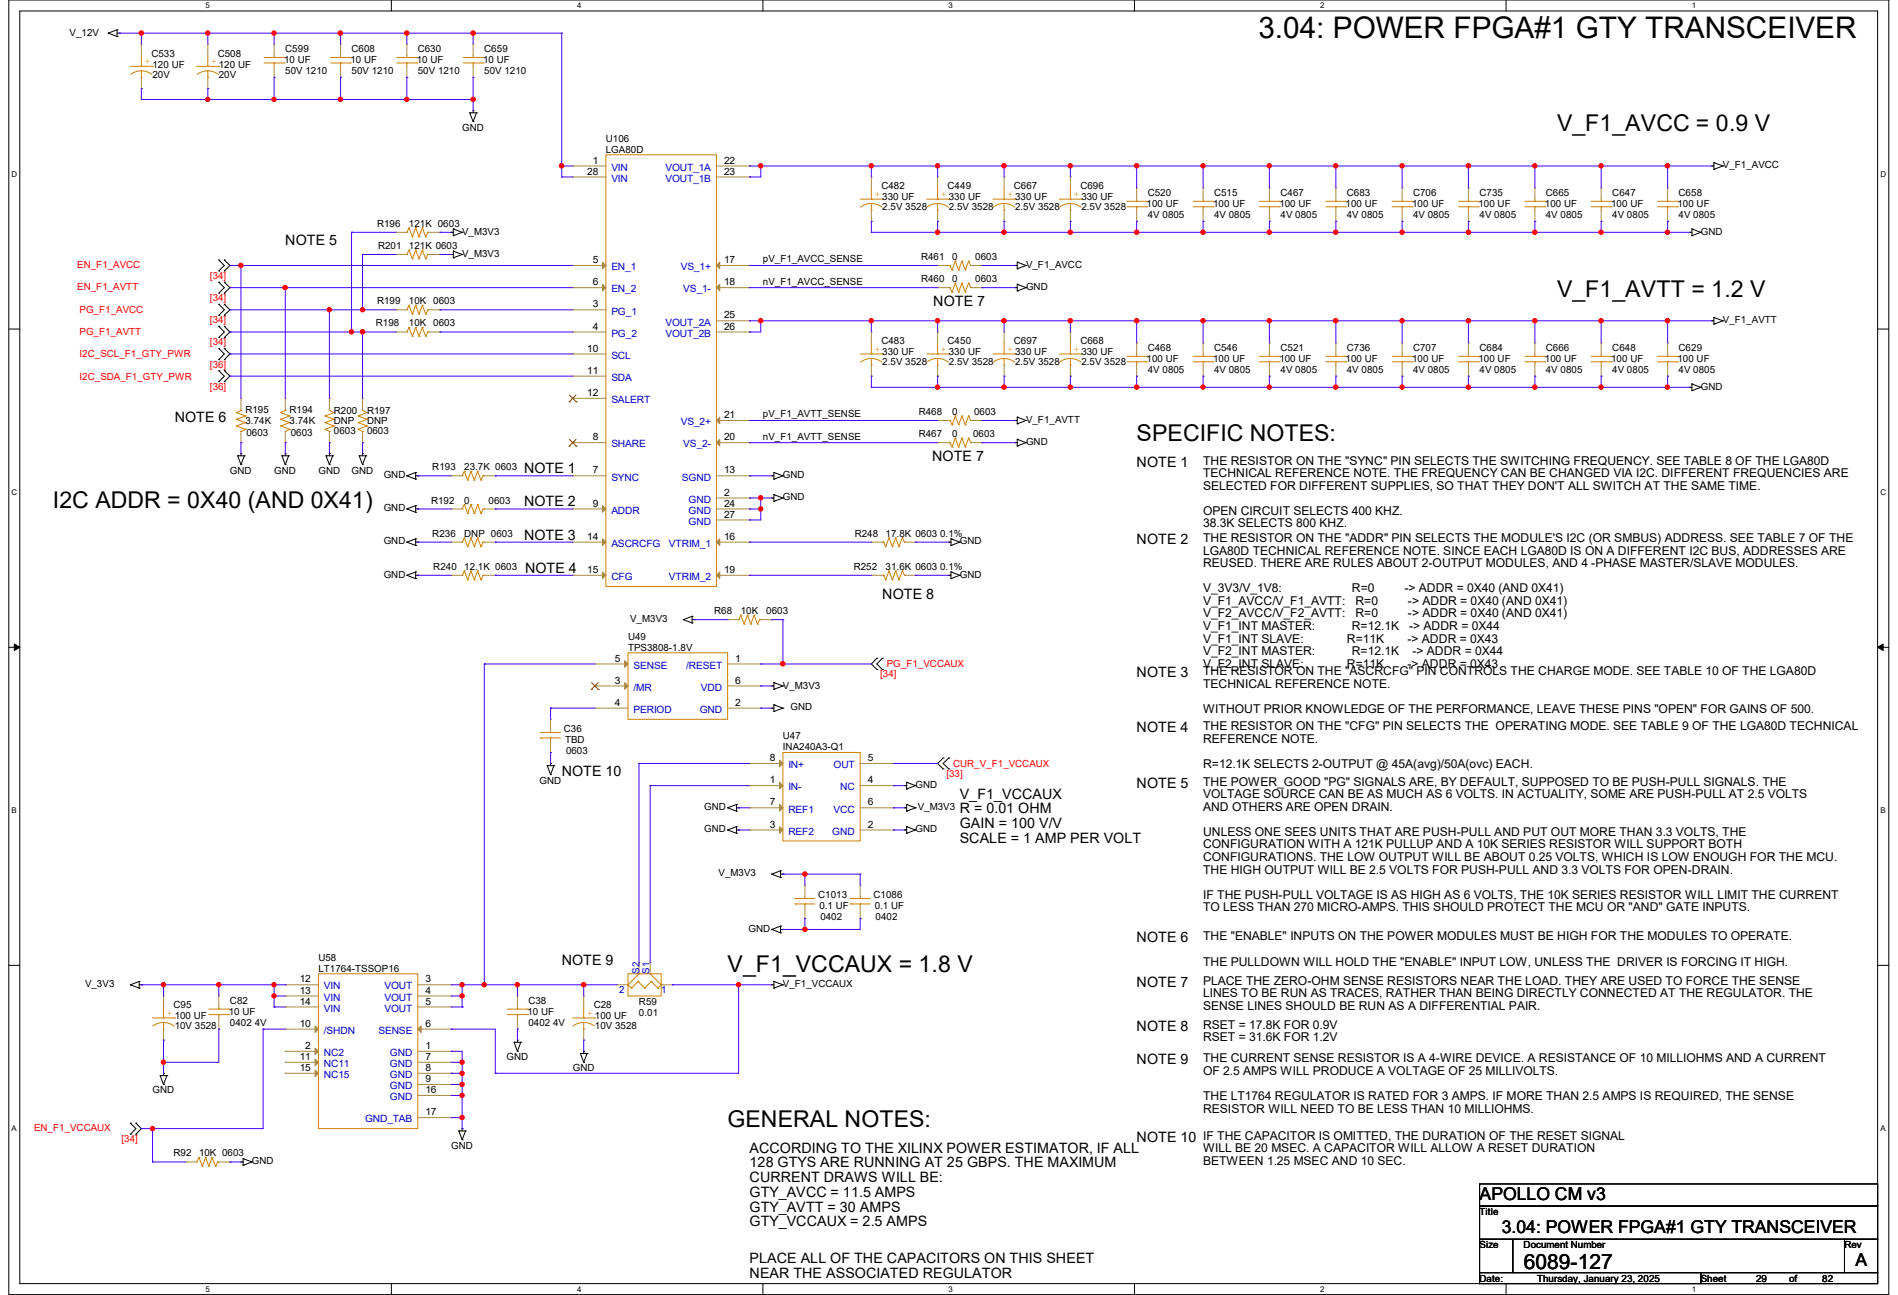
[picture p156: page 29]

3.04: POWER FPGA#1 GTY TRANSCEIVER

THE RESISTOR ON THE "SYNC" PIN SELECTS THE SWITCHING FREQUENCY. SEE TABLE 8 OF THE LGA80D
TECHNICAL REFERENCE NOTE. THE FREQUENCY CAN BE CHANGED VIA I2C. DIFFERENT FREQUENCIES ARE
SELECTED FOR DIFFERENT SUPPLIES, SO THAT THEY DON'T ALL SWITCH AT THE SAME TIME.
OPEN CIRCUIT SELECTS 400 KHZ.
38.3K SELECTS 800 KHZ.
THE RESISTOR ON THE "ADDR" PIN SELECTS THE MODULE'S I2C (OR SMBUS) ADDRESS. SEE TABLE 7 OF THE
LGA80D TECHNICAL REFERENCE NOTE. SINCE EACH LGA80D IS ON A DIFFERENT I2C BUS, ADDRESSES ARE
REUSED. THERE ARE RULES ABOUT 2-OUTPUT MODULES, AND 4 -PHASE MASTER/SLAVE MODULES.
THE RESISTOR ON THE "ASCRCFG" PIN CONTROLS THE CHARGE MODE. SEE TABLE 10 OF THE LGA80D
TECHNICAL REFERENCE NOTE.
WITHOUT PRIOR KNOWLEDGE OF THE PERFORMANCE, LEAVE THESE PINS "OPEN" FOR GAINS OF 500.
THE RESISTOR ON THE "CFG" PIN SELECTS THE OPERATING MODE. SEE TABLE 9 OF THE LGA80D TECHNICAL
REFERENCE NOTE.
R=12.1K SELECTS 2-OUTPUT @ 45A(avg)/50A(ovc) EACH.

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

THE "ENABLE" INPUTS ON THE POWER MODULES MUST BE HIGH FOR THE MODULES TO OPERATE.
THE PULLDOWN WILL HOLD THE "ENABLE" INPUT LOW, UNLESS THE DRIVER IS FORCING IT HIGH.
PLACE THE ZERO-OHM SENSE RESISTORS NEAR THE LOAD. THEY ARE USED TO FORCE THE SENSE
LINES TO BE RUN AS TRACES, RATHER THAN BEING DIRECTLY CONNECTED AT THE REGULATOR. THE
SENSE LINES SHOULD BE RUN AS A DIFFERENTIAL PAIR.
RSET = 17.8K FOR 0.9V
RSET = 31.6K FOR 1.2V
THE CURRENT SENSE RESISTOR IS A 4-WIRE DEVICE. A RESISTANCE OF 10 MILLIOHMS AND A CURRENT
OF 2.5 AMPS WILL PRODUCE A VOLTAGE OF 25 MILLIVOLTS.
THE LT1764 REGULATOR IS RATED FOR 3 AMPS. IF MORE THAN 2.5 AMPS IS REQUIRED, THE SENSE

RESISTOR WILL NEED TO BE LESS THAN 10 MILLIOHMS. GENERAL NOTES:

NOTE 10 IF THE CAPACITOR IS OMITTED, THE DURATION OF THE RESET SIGNAL

ACCORDING TO THE XILINX POWER ESTIMATOR, IF ALL
128 GTYS ARE RUNNING AT 25 GBPS. THE MAXIMUM
CURRENT DRAWS WILL BE:
GTY_AVCC = 11.5 AMPS
GTY_AVTT = 30 AMPS
GTY_VCCAUX = 2.5 AMPS

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

PLACE ALL OF THE CAPACITORS ON THIS SHEET
NEAR THE ASSOCIATED REGULATOR

# 3.05: POWER FPGA#2 INTERNAL

## NOTE 5

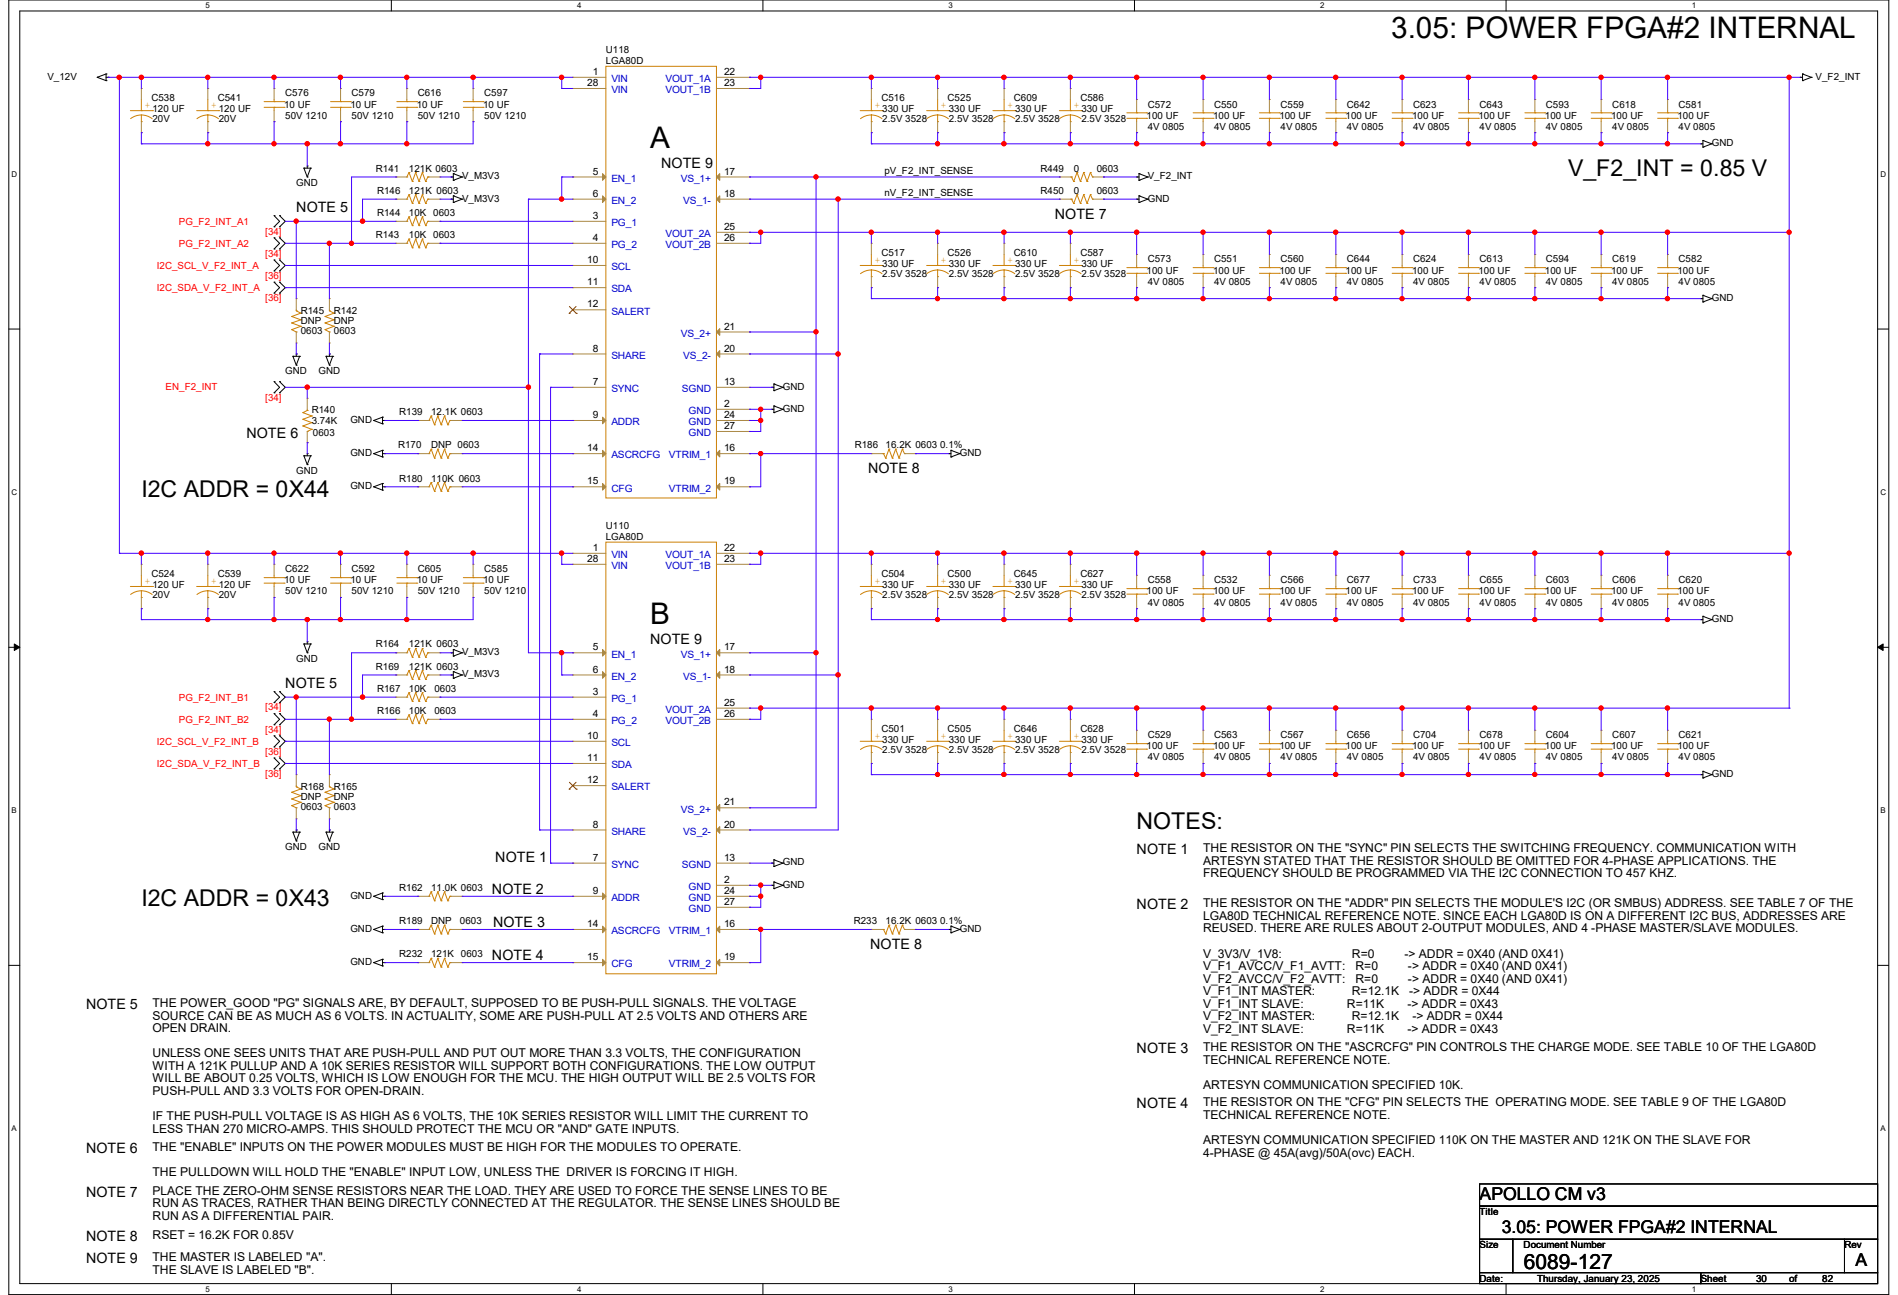
[picture p157: page 30]
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

THE RESISTOR ON THE "ADDR" PIN SELECTS THE MODULE'S I2C (OR SMBUS) ADDRESS. SEE TABLE 7 OF THE
LGA80D TECHNICAL REFERENCE NOTE. SINCE EACH LGA80D IS ON A DIFFERENT I2C BUS, ADDRESSES ARE
REUSED. THERE ARE RULES ABOUT 2-OUTPUT MODULES, AND 4 -PHASE MASTER/SLAVE MODULES.
THE RESISTOR ON THE "ASCRCFG" PIN CONTROLS THE CHARGE MODE. SEE TABLE 10 OF THE LGA80D
TECHNICAL REFERENCE NOTE.
ARTESYN COMMUNICATION SPECIFIED 10K.
THE RESISTOR ON THE "CFG" PIN SELECTS THE OPERATING MODE. SEE TABLE 9 OF THE LGA80D
ARTESYN COMMUNICATION SPECIFIED 110K ON THE MASTER AND 121K ON THE SLAVE FOR
4-PHASE @ 45A(avg)/50A(ovc) EACH.

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

NOTE 7 PLACE THE ZERO-OHM SENSE RESISTORS NEAR THE LOAD. THEY ARE USED TO FORCE THE SENSE LINES TO BE

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

NOTE 8
NOTE 9 THE MASTER IS LABELED "A".

THE SLAVE IS LABELED "B".

# 3.06: POWER FPGA#2 GTY TRANSCEIVER

# V_F2_AVTT = 1.2 V

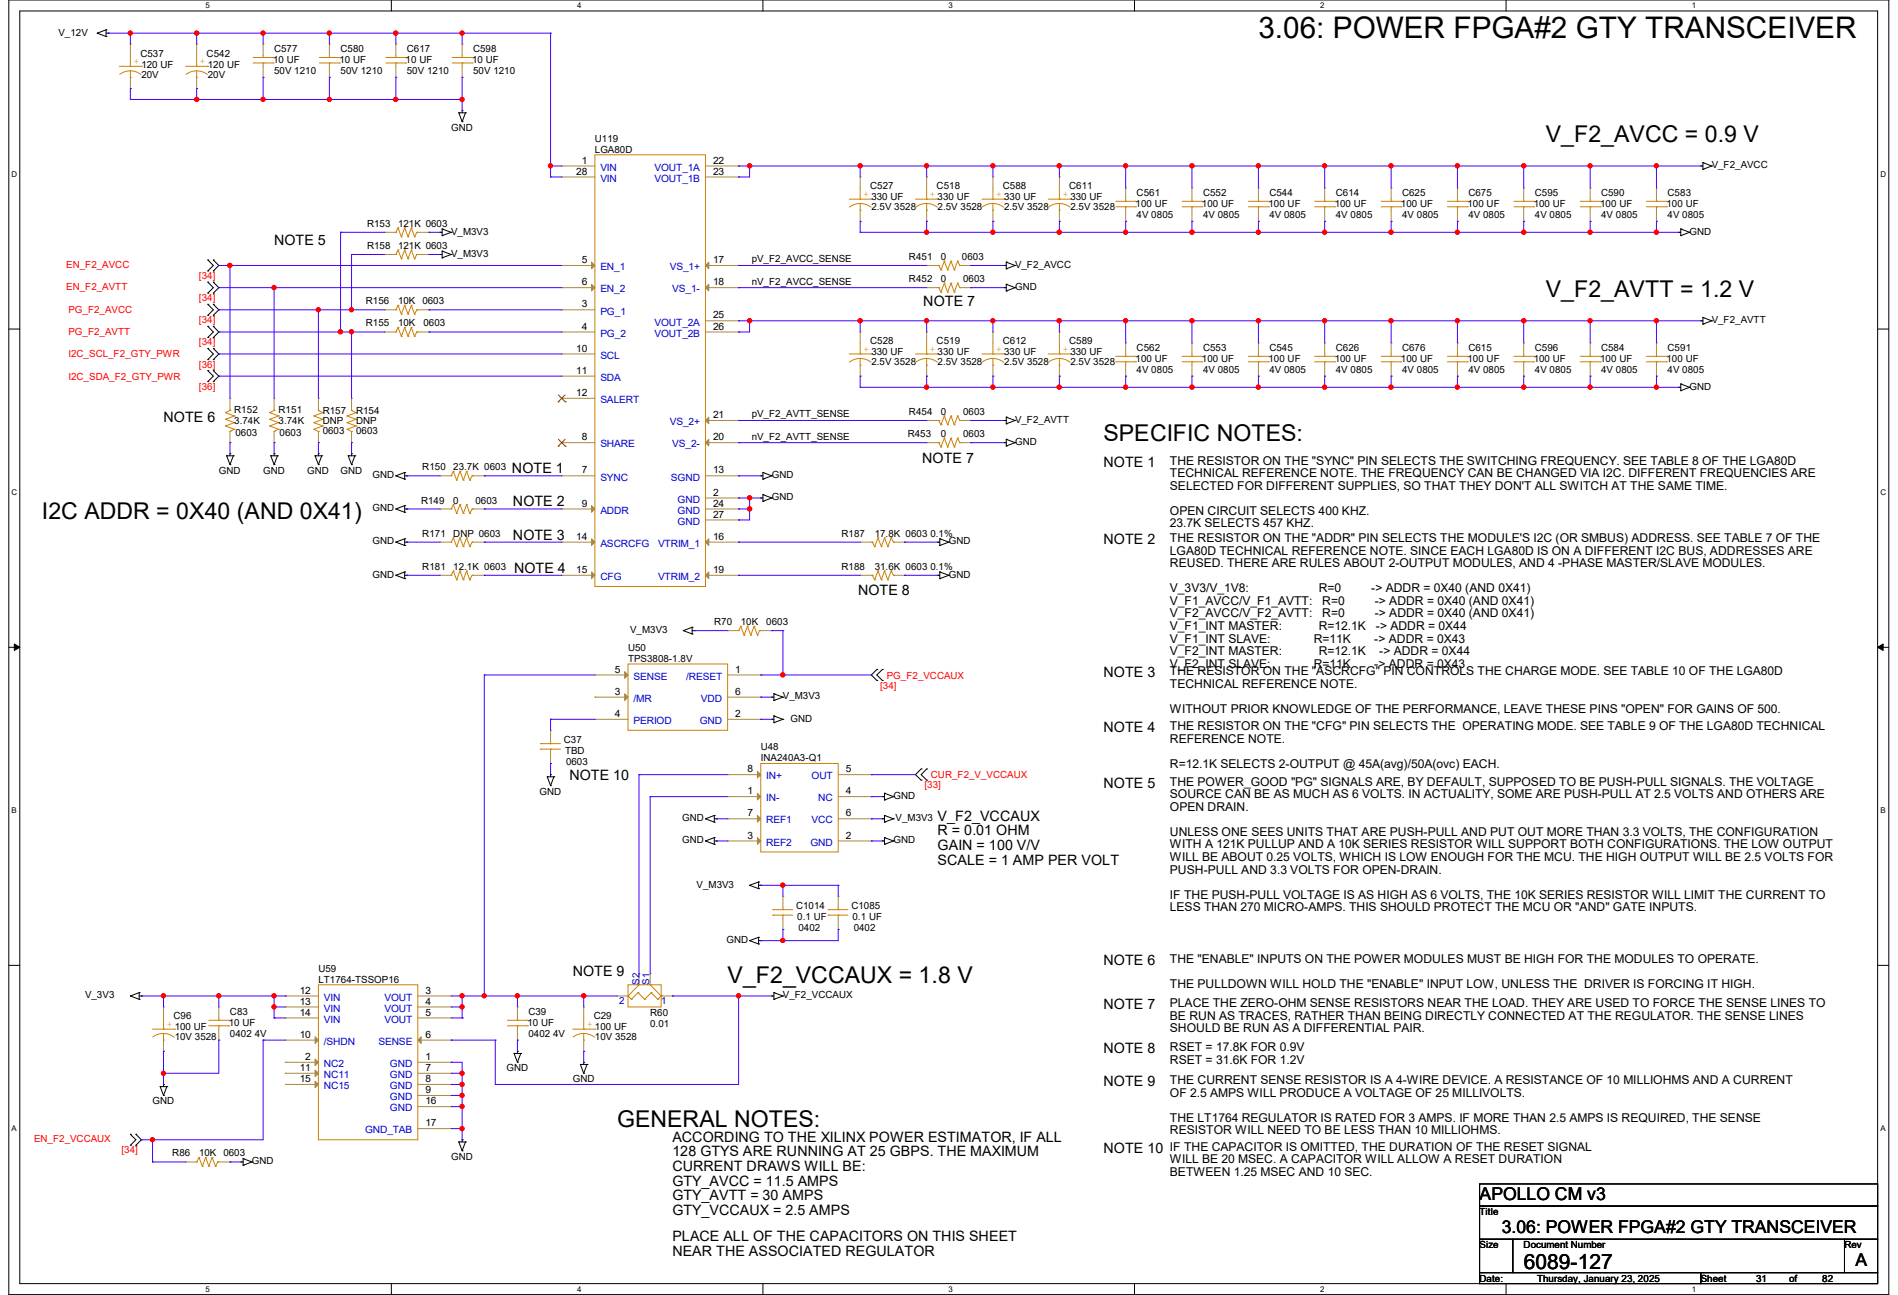
[picture p158: page 31]

THE RESISTOR ON THE "SYNC" PIN SELECTS THE SWITCHING FREQUENCY. SEE TABLE 8 OF THE LGA80D
TECHNICAL REFERENCE NOTE. THE FREQUENCY CAN BE CHANGED VIA I2C. DIFFERENT FREQUENCIES ARE
SELECTED FOR DIFFERENT SUPPLIES, SO THAT THEY DON'T ALL SWITCH AT THE SAME TIME.
OPEN CIRCUIT SELECTS 400 KHZ.
23.7K SELECTS 457 KHZ.
THE RESISTOR ON THE "ADDR" PIN SELECTS THE MODULE'S I2C (OR SMBUS) ADDRESS. SEE TABLE 7 OF THE
LGA80D TECHNICAL REFERENCE NOTE. SINCE EACH LGA80D IS ON A DIFFERENT I2C BUS, ADDRESSES ARE
REUSED. THERE ARE RULES ABOUT 2-OUTPUT MODULES, AND 4 -PHASE MASTER/SLAVE MODULES.
THE RESISTOR ON THE "ASCRCFG" PIN CONTROLS THE CHARGE MODE. SEE TABLE 10 OF THE LGA80D
TECHNICAL REFERENCE NOTE.
WITHOUT PRIOR KNOWLEDGE OF THE PERFORMANCE, LEAVE THESE PINS "OPEN" FOR GAINS OF 500.
THE RESISTOR ON THE "CFG" PIN SELECTS THE OPERATING MODE. SEE TABLE 9 OF THE LGA80D TECHNICAL
REFERENCE NOTE.
R=12.1K SELECTS 2-OUTPUT @ 45A(avg)/50A(ovc) EACH.
THE POWER_GOOD "PG" SIGNALS ARE, BY DEFAULT, SUPPOSED TO BE PUSH-PULL SIGNALS. THE VOLTAGE
SOURCE CAN BE AS MUCH AS 6 VOLTS. IN ACTUALITY, SOME ARE PUSH-PULL AT 2.5 VOLTS AND OTHERS ARE
OPEN DRAIN.

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

NOTE 9 THE CURRENT SENSE RESISTOR IS A 4-WIRE DEVICE. A RESISTANCE OF 10 MILLIOHMS AND A CURRENT

OF 2.5 AMPS WILL PRODUCE A VOLTAGE OF 25 MILLIVOLTS.

128 GTYS ARE RUNNING AT 25 GBPS. THE MAXIMUM
CURRENT DRAWS WILL BE:
GTY_AVCC = 11.5 AMPS
GTY_AVTT = 30 AMPS
GTY_VCCAUX = 2.5 AMPS
PLACE ALL OF THE CAPACITORS ON THIS SHEET
NEAR THE ASSOCIATED REGULATOR

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

3.06: POWER FPGA#2 GTY TRANSCEIVER

# 3.07: POWER FOR FF X12 XMIT

## NOTE 8

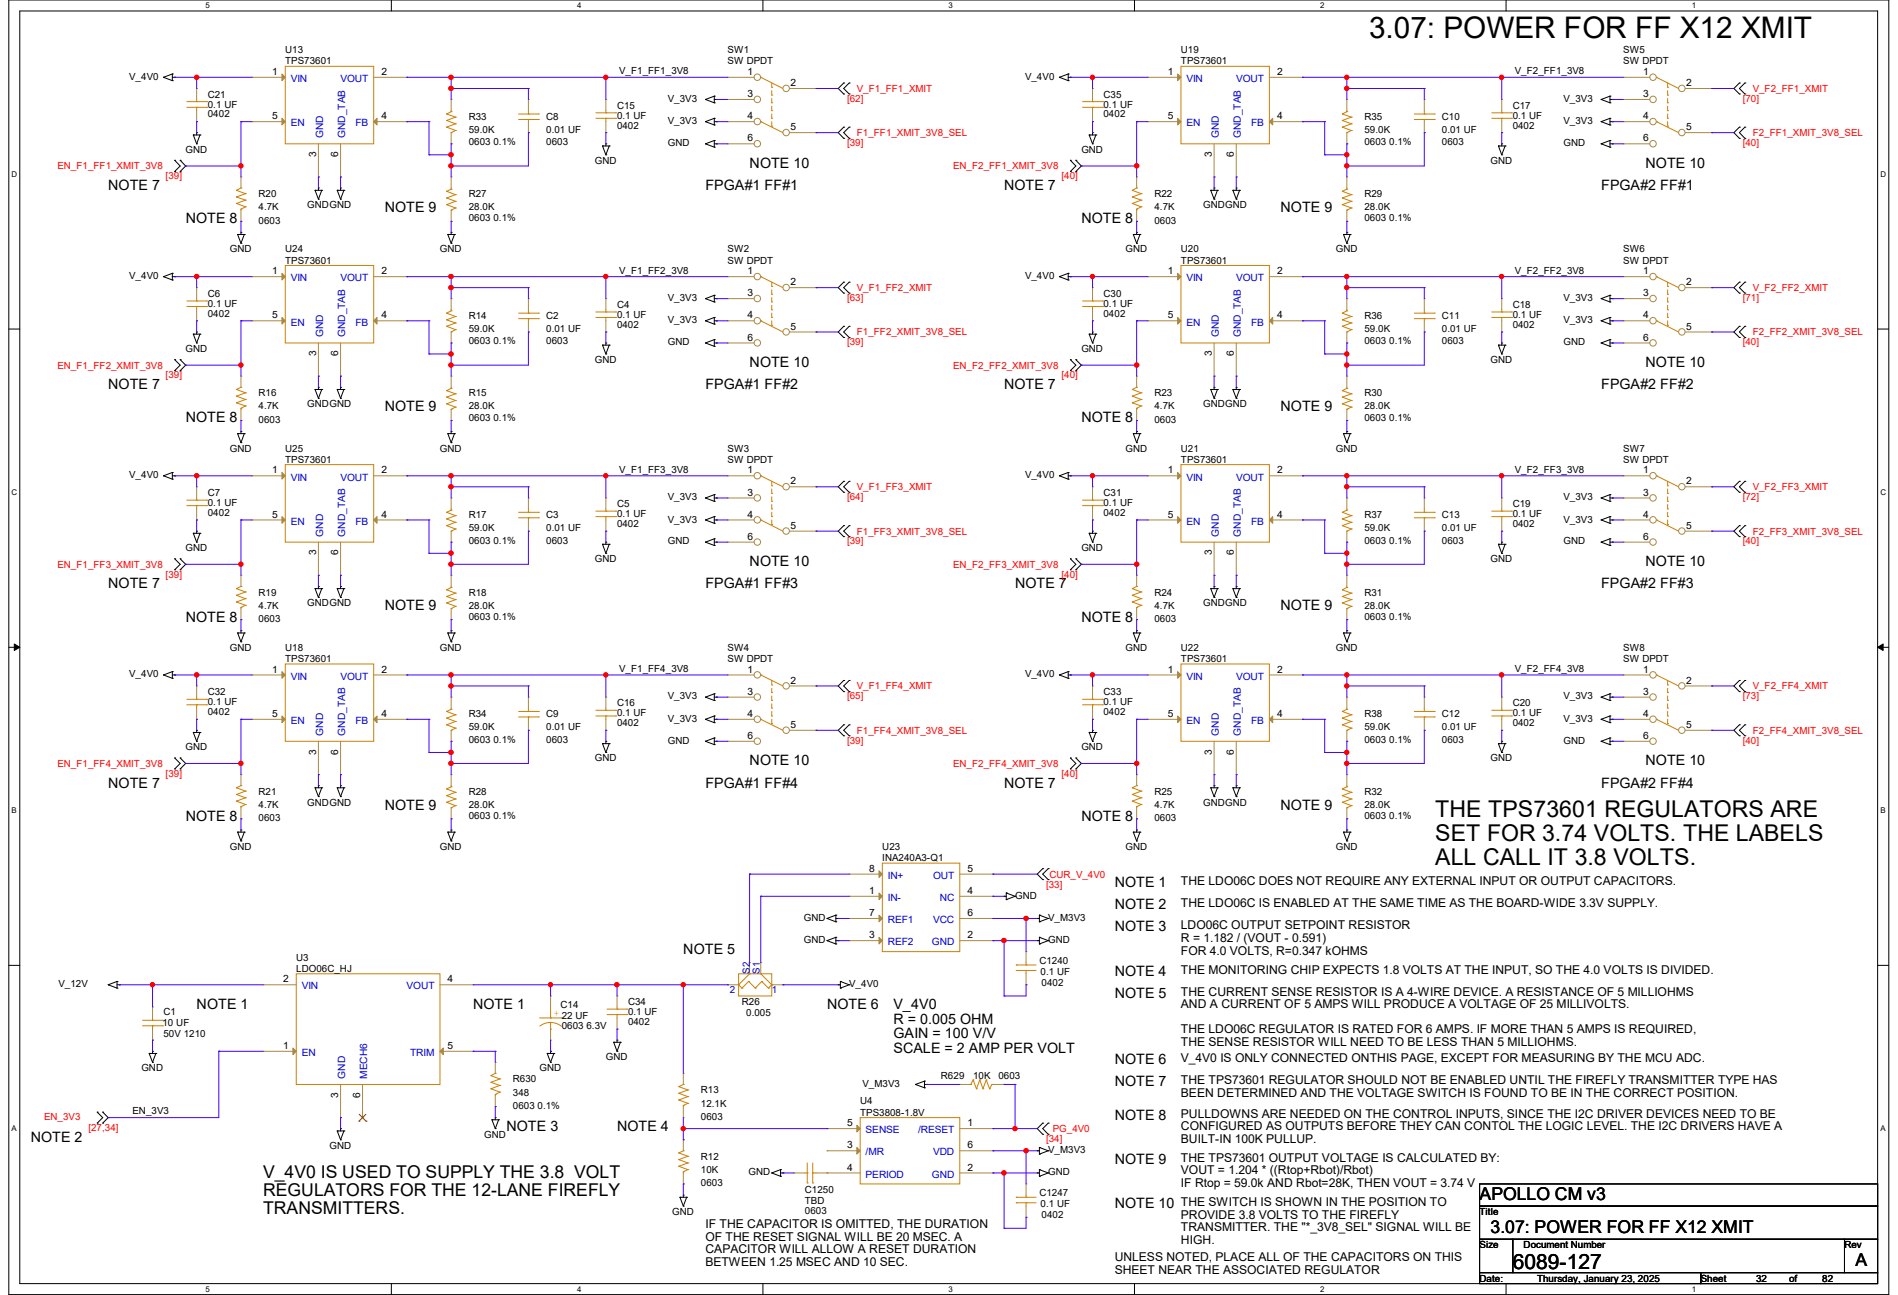
[picture p159: page 32]

THE TPS73601 REGULATORS ARE
SET FOR 3.74 VOLTS. THE LABELS
ALL CALL IT 3.8 VOLTS.

THE LDO06C DOES NOT REQUIRE ANY EXTERNAL INPUT OR OUTPUT CAPACITORS.
THE LDO06C IS ENABLED AT THE SAME TIME AS THE BOARD-WIDE 3.3V SUPPLY.
LDO06C OUTPUT SETPOINT RESISTOR
R = 1.182 / (VOUT - 0.591)
FOR 4.0 VOLTS, R=0.347 kOHMS
THE MONITORING CHIP EXPECTS 1.8 VOLTS AT THE INPUT, SO THE 4.0 VOLTS IS DIVIDED.
THE CURRENT SENSE RESISTOR IS A 4-WIRE DEVICE. A RESISTANCE OF 5 MILLIOHMS
AND A CURRENT OF 5 AMPS WILL PRODUCE A VOLTAGE OF 25 MILLIVOLTS.
THE LDO06C REGULATOR IS RATED FOR 6 AMPS. IF MORE THAN 5 AMPS IS REQUIRED,
THE SENSE RESISTOR WILL NEED TO BE LESS THAN 5 MILLIOHMS.

R = 0.005 OHM
GAIN = 100 V/V
SCALE = 2 AMP PER VOLT

NOTE 6 V_4V0 IS ONLY CONNECTED ONTHIS PAGE, EXCEPT FOR MEASURING BY THE MCU ADC.
NOTE 7

THE TPS73601 REGULATOR SHOULD NOT BE ENABLED UNTIL THE FIREFLY TRANSMITTER TYPE HAS
BEEN DETERMINED AND THE VOLTAGE SWITCH IS FOUND TO BE IN THE CORRECT POSITION.

NOTE 8 PULLDOWNS ARE NEEDED ON THE CONTROL INPUTS, SINCE THE I2C DRIVER DEVICES NEED TO BE

CONFIGURED AS OUTPUTS BEFORE THEY CAN CONTOL THE LOGIC LEVEL. THE I2C DRIVERS HAVE A
BUILT-IN 100K PULLUP.
THE TPS73601 OUTPUT VOLTAGE IS CALCULATED BY:
VOUT = 1.204 * ((Rtop+Rbot)/Rbot)
IF Rtop = 59.0k AND Rbot=28K, THEN VOUT = 3.74 V
THE SWITCH IS SHOWN IN THE POSITION TO
PROVIDE 3.8 VOLTS TO THE FIREFLY
TRANSMITTER. THE "*_3V8_SEL" SIGNAL WILL BE
HIGH.

V_4V0 IS USED TO SUPPLY THE 3.8 VOLT
REGULATORS FOR THE 12-LANE FIREFLY
TRANSMITTERS.

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

3.07: POWER FOR FF X12 XMIT

UNLESS NOTED, PLACE ALL OF THE CAPACITORS ON THIS
SHEET NEAR THE ASSOCIATED REGULATOR
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
