apollo-lhc/Cornell_CM_Rev3_HW/(commit log)

2024-01-02 Added Gerber files
2024-01-02 Added PDF of the schematic
2024-01-02 Added PCB drill files
    [6089-127-reva_20-1-18.drl, 6089-127-reva_20-bd-18-15.drl, 6089-127-reva_20-bd-18-17.drl, 6089-127-reva_20-bd-18-4.drl, 6089-127-reva_20-bd-18-6.drl]
2024-01-02 Added PCB "README" file
2024-10-15 Initial versions for CMv3
    [CMv3_TM4C_controller_pin_specs.xlsx]
2024-11-04 Updated schematics
2024-11-08 Put pilot quantity spreadsheet in git
    [PilotQuantities_08Nov2024.xlsx]
2024-11-18 First pass at test board documentation
2025-01-22 Initial CMv3 clock configuration files
    [ConfigurationIndex.xlsx]
2025-01-23 Updated schematic, added sheet #12, fixed I2C addresses
2025-01-29 Documentation and clock files for production testing
    [ConfigurationIndex.xlsx]
2025-01-29 Updated configuration index
    [ConfigurationIndex.xlsx]
2025-01-30 Testing plan update
    [ConfigurationIndex.xlsx]
2025-02-17 Added synth config files for testing R0A and R0B inputs
    [ConfigurationIndex.xlsx]
2025-02-20 Reorganized into "projects" and "test_projects"
    Configuration in "projects" will be used for operations. Configurations in "test_projects" will be used for testing the hardware.
    [ConfigurationIndex.xlsx, TestConfigurationIndex.xlsx]
2025-08-04 Moved testing instructions to BoardTesting directory
2025-08-05 Added instructions for heatsink and FireFly installation
2025-10-01 Added instruction for heatsink removal
2025-10-06 Update production test manual
    Firefly installation/I2C test. Various fixes and improvements suggested by testers
2026-02-18 Initial instructions for FireFly installation on a TF board
2026-06-03 Added R0A config with 320 MHz on all outputs from 48 MHz crystal
    [TestConfigurationIndex.xlsx]
2026-06-03 updated config file database
    [TestConfigurationIndex.xlsx]
2026-07-13 Finishing adding 320 MHz clocks
    [ConfigurationIndex.xlsx]
2026-07-13 Assembly and shipping info
